senecjusz/Dynia-eyes/50-elektronika/README.md

# 50 – Elektronika

- [sprzet.md](sprzet.md) – posiadane i brakujące części,
- [polaczenia.md](polaczenia.md) – jak co jest podłączone (piny, zasilanie) i opis wszystkich szkiców,
- szkice testowe: `blink/`, `skan-i2c/`, `test-serwa/` (19.10),
- `kalibracja/` – kalibracja modułów po kolei z portu: `k <n>` wybiera kanał i trzyma 1500 µs do nasadzenia orczyka, `s`/`min`/`max` zapisują środek i krańce, `t` drukuje tabelę do `kalibracja-oczu.md`,
- `oczy-ruch/` – program ruchu oczu (sakady, fiksacje, tryby spoczynek/aktywny),
- `test-powerbank/` – test auto-wyłączania powerbanku (E5.5),
- `test-galka/` – łagodny ruch gałki dużego oka bez kalibracji (koło albo losowo, amplituda i kanały z portu: `start`, `a`, `ax`, `ay`, `x`, `y`, `losowo`, `stop`, `off`),
- `test-24h/` – test 24 h mechaniki na dwóch modułach, dziennik i środki oczu w NVS (E5.6),
- schematy i zdjęcia płytek.
