senecjusz/Dynia-eyes/10-inspiracje/README.md

# 10 – Inspiracje

Projekty i materiały znalezione w internecie, na których bazujemy.

Jeden plik `.md` na inspirację, np. `ping-pong-eyes-instructables.md`:
- link do źródła,
- co z tego bierzemy (mechanizm, kod, pomysł),
- na który poziom projektu się przydaje (1 / 2 / 3).

Pobrane pliki (STL, kod, PDF) w podfolderze o tej samej nazwie.

Pliki:
- `mechanizmy-oka-zrodla.md` – źródła researchu mechanizmów oka,
- `pumpkin-eyes-kent-harris.md`, `arduino-servo-pumpkin-eyes-68percentwater.md` – projekty dyni z oczami na serwach,
- `servo-pumpkin-pythoncader.md` (kod w `servo-pumpkin-pythoncader/`) – analiza kodu ServoPumpkin (21.10), wzór dla `50-elektronika/oczy-ruch`.
