senecjusz/Dynia-eyes/60-firmware/README.md

# 60 – Firmware

Kod dla Arduino Nano (ATmega328) sterujący serwami przez PCA9685.

Jeden podfolder na program, np. `test-serwa/`, `oczy-losowo/`, `duze-oko/`.
