senecjusz/Dynia-eyes/40-cad/archiwum/v1/README.md

# Oko F v1 – PRZESTARZAŁE, NIE DRUKOWAĆ

Pierwsza wersja modułu małego oka (wariant F), zastąpiona przez **v1.1** (`40-cad/stl/*-v1.1.stl`).

Powody wycofania (review v1, 2026-10-18):
- **napęd w martwym punkcie**: korba, cięgno i orczyk leżały na jednej prostej przy oku na wprost,
- luzy liczone od piłeczki 40,0 mm (realnie 39,5–40,5),
- STL eksportowane z grubą siatką (otwory jako wielokąty co 22,5°): luz bagnetu spadał z 0,6 do ~0,14 mm, a gwint gniazdo–nakrętka miał wcisk,
- rant Ø72 × 2 mm za duży.

Stan modelu v1 jest zapisany w Onshape jako wersja dokumentu **„v1”** (dokument SimpleEye).

| Plik | Co to |
|---|---|
| `*-v1.stl` | eksporty v1 (nie drukować) |
| `oko-f-v1-build.js` | skrypt, który zbudował drzewo v1 przez REST API |
