senecjusz/Dynia-eyes/30-projekt/decyzje.md

# Dziennik decyzji

| Data | Decyzja | Dlaczego |
|---|---|---|
| 2026-10-17 | Sterowanie: Arduino Nano + PCA9685, serwa SG90 | Sprzęt już kupiony; PCA9685 obsłuży do 16 serw |
| 2026-10-17 | Dostęp agentów do GitHuba tylko przez deploy key tego repo | Ochrona pozostałych repozytoriów |
| 2026-10-17 | Dynia prawdziwa | Projekt na 1–2 tygodnie, wilgoć akceptowalna |
| 2026-10-17 | Małe oczy bez powiek – 1 serwo na oko | Najprostszy mechanizm, pewny do zrobienia z synem |
| 2026-10-17 | Punkt wyjścia: moduł-rurka (68percentwater), mocowanie gwintem | Mały otwór w dyni, montaż bez narzędzi przez syna |
| 2026-10-17 | Poziomy = złożoność, nie mechanizm; duże oko w podpoziomach 2a/2b/2c | Każdy krok daje działające oko; mechanizm dobieramy w analizach |
| 2026-10-17 | Moduł oka wpinany bagnetem w gniazdo osadzone w dyni; mocowanie gniazda do ustalenia | Montaż modułu bez narzędzi, wymuszona pionowa oś oka |
| 2026-10-17 | Mocowanie małego oka: gniazdo z rantem + nakrętka (rodzic), moduł na bagnet (syn); wymiary rantu i napędu zaktualizowane w v1.1 (patrz niżej) | Najbezpieczniejsze; dziecko robi tylko prostą, nie do pomylenia czynność |
| 2026-10-17 | Drukowany klucz nasadowy do nakrętki gniazda, pod grzechotkę 3/8" | Syn może sam dokręcić gniazdo; jeden klucz do wszystkich oczu |
| 2026-10-17 | Model oka F v1 w Onshape (SimpleEye) ze zwykłych operacji + zmienne `#…`, wszystkie części w jednym Part Studio w pozycji złożonej | Użytkownik może sam edytować drzewo; jedno miejsce do sprawdzania kolizji i luzów |
| 2026-10-17 | Gwint gniazda/nakrętki: trapezowy, prawy, skok 3 mm, luz 0,3 mm, od 14 do 45 mm pod powierzchnią | Docisk ścianki 15–35 mm; prawy = dokręcanie „normalnie” patrząc od środka dyni |
| 2026-10-17 | Bagnet: 3 zaczepy w gnieździe na 0°/150°/210° (nierówno = jedna pozycja), obrót 30°, garb zatrzasku 0,6 mm | Moduł wchodzi tylko pionowo; klik potwierdza zamknięcie |
| 2026-10-17 | Napęd oka: SG90 leżący w tulei za jarzmem (wałek pionowo), cięgno korba 20 mm ↔ orczyk 14 mm, piłeczka na 2 czopach + kolec z tyłu | Wszystko mieści się w tulei Ø53,3; ruch oka ±30–40° bez kolizji |
| 2026-10-17 | Środek piłeczki 5 mm pod powierzchnią dyni; piłeczka wystaje ~13 mm ponad rant | Czopy muszą zmieścić się w tulei przed rantem; do oceny na wydruku |
| 2026-10-17 | Pudełko z elektroniką i powerbankiem w środku dyni (pionowa wieża); powerbank na podstawce = opcja | Minimum bez dodatkowych konstrukcji; wyprowadzenie na zewnątrz tylko gdy starczy czasu |
| 2026-10-17 | Plan: minimum (4–8 małych oczu) do 25.10, rozszerzenia niezależne; duże oko raczej na przyszły rok | 2 weekendy do Halloween; nic opcjonalnego nie może blokować minimum |
| 2026-10-17 | Połączenia i osie na śruby M3/M4; piłeczka na śrubach-osiach przez bieguny (P1) | Śruby są w warsztacie; pewniejsze niż drukowane czopy i klej |
| 2026-10-18 | Kontroler: Arduino Nano; zapas: ESP32 / Raspberry Pi (gdyby zabrakło pamięci), w warsztacie też Uno i Mega | Tani, 5 V jak PCA9685 i PIR, mały pobór; syn nie programuje sam, więc micro:bit niepotrzebny |
| 2026-10-18 | Dynia będzie prezentowana w szkole: filtrowanie radaru, limit serw w ruchu, zapasowe moduły | Tłum dzieci = ciągły ruch i dotykanie |
| 2026-10-18 | Małe oczy zawsze chaotyczne, bez czujnika; na ruch reaguje tylko duże oko (zamknięte gdy nikogo nie ma, otwiera się po wykryciu PIR-em) | Najprostsze; minimum nie potrzebuje żadnego czujnika |
| 2026-10-18 | Śledzenie przez duże oko: radar LD2450 + ESP32 (otwarcie i kierunek z jednego czujnika; góra–dół z odległości) | Duże oko ma 2 osie, radar podaje kąt wprost; Nano nie obsłuży portu szeregowego radaru |
| 2026-10-18 | Duże oko próbujemy zrobić w tym roku, równolegle z małymi oczami (małe oczy = minimum) | Projekt w CAD jest szybki; użytkownik ocenia mechanizm jako prosty |
| 2026-10-18 | Firmware od początku na ESP32, z kalibracją serw przez stronę w telefonie (Wi-Fi, zapis w pamięci) | Kalibracja to największe ryzyko; radar LD2450 później bez migracji |
| 2026-10-18 | Zamówić radar HLK-LD2450 | Dostawa kilka dni; śledzenie przez duże oko to wtedy jeden wieczór |
| 2026-10-18 | Drukarki: X1C w Warszawie (wydruki próbne w tygodniu), A1 mini w Kobyłce (weekendy, małe części) | Logistyka między dwoma miejscami |
| 2026-10-18 | v1.1 małego oka: napęd korba 22 \/ cięgno 16 \/ drukowane ramię orczyka 22 mm, ±30° (start ±25°), piłeczka 39,5–40,5, rant Ø68×1,5; drukowana testowo bez poprawek z review | Usuwa martwy punkt z v1 (przy orczyku 13–14 mm blokada ~20°); poprawki review → v2 |
| 2026-10-18 | Zasada DFAM: każda część z płaską stroną na stół, nic nie wystaje poza nią | Jarzmo v1/v1.1 nie leżało płasko |
| 2026-10-18 | v2 modułu oka ze śrubami zlecona nowej sesji (brief 30-projekt/brief-v2-modul-oka.md) | Po review v1.1 |
| 2026-10-18 | v2 modułu oka w gałęzi „v2” dokumentu SimpleEye (wersje „v1.1” i „v2 do review”): Part Studio „Oko F v2”, Variable Studio „Zmienne v2”, Assembly „Oko F v2 - zlozenie” | v1 i v1.1 zostają nietknięte; jedno miejsce na historię |
| 2026-10-18 | Oś oka: 2 × M3×8 z niskim łbem (ISO 7380 / DIN 7984) wkręcone ciasno w występy tulei, łby w pogłębieniu; jarzmo i piłeczka luźno; luz osiowy 0,3 mm | Łeb DIN 912 nie mieści się w ściance tulei bez wystawania pod gniazdo |
| 2026-10-18 | Przeguby napędu: M3×8 od dołu, tulejka z kołnierzem (korba/ramię luźno 0,2 mm), wkładki M3 w cięgnie, śruba dokręcona do oporu | Pewny luz i brak odkręcania przy ruchu wahadłowym |
| 2026-10-18 | Napęd v2: korba 26 mm @16°, cięgno 15,15, ramię orczyka 25,5; wałek serwa 51 mm za osią oka; kąt przenoszenia ≥ 41° przy ±30° (także z luzami) | Przy łbach M3 i tulejkach wymiary v1.1 nie mieszczą się w tulei Ø48,5 |
| 2026-10-18 | Jarzmo: pierścień odchylony o 60° w bok, kołek Ø4 + siodło; ograniczniki ±33° (kołki na oczkach w łukowych rowkach występów tulei) | Miejsce na cięgno za piłeczką; wymuszony obrót ręką idzie na tuleję, nie na serwo; druga pozycja czworoboku niemożliwa |
| 2026-10-18 | SG90 wzdłuż osi, wałkiem do tyłu, wysunięty 7 mm pod tuleję za gniazdem; wsuwany od tyłu, przednie ucho na słupku tulei, tylne na pokrywie tylnej (odciążenie kabla kołkami) | Warstwa napędu na wysokości środka piłeczki daje najwięcej miejsca; moduł krótszy (72,6 mm) |
| 2026-10-18 | Gałka wystaje ~8 mm; gniazdo na ściankę 15–30 mm; rant i nakrętka (Ø72, bez skrzydełek) dopasowane do dyni R 150; gwint 45° z fazą początku; bagnet z językami (garb 0,6 mm) i znacznikami WSUŃ/ZAMKNIĘTE | Brief v2 (pkt 4, 5, 7, 8, 9) |
| 2026-10-18 | v2 bez bagnetu: gniazdo + tuleja = jedna Obudowa (montuje rodzic, syn wpina wtyczkę); piłeczka wklejona (CA) w drukowaną tylną Miskę zamiast jarzma C i wiercenia | Mniej części i mniejsza średnica (otwór ~Ø57 zamiast 64); moment rozłożony na tylną połowę piłeczki |
| 2026-10-18 | v2.1 w gałęzi „v2” (wersja „v2.1 do review”): Part Studio „Oko F v2.1”, Assembly „Oko F v2.1 - zlozenie”; „v2 do review” zostaje w historii | Poprawki po review v2 |
| 2026-10-18 | Obudowa jednoczęściowa: otwór w dyni Ø57, rant Ø63 z ząbkami, gwint 45° skok 3 na rurze Ø52,5, nakrętka Ø66 od środka; ścianka dyni 15–25 mm | Mniejsza średnica bez bagnetu; przegub H musi leżeć za gwintem, żeby go skręcić przy założonej nakrętce |
| 2026-10-18 | Miska = pas kulisty 8 mm (wnętrze Ø40,9, klej 0,2) z tyłu piłeczki w płaszczyźnie odchylonej o 60°, korba zrośnięta; przyrząd do wklejania ustawia źrenicę | Pełna półkula łamie DFAM (oczka poza płaską stroną) i zajmuje miejsce cięgna |
| 2026-10-18 | Wnętrze zostaje Ø48,5; napęd v2.1: korba 25,25 @17°, cięgno 17,21, ramię 27 @200°, wałek serwa 54 mm za osią oka; kąt przenoszenia ≥ 44° przy ±30° | W mniejszej rurze czworobok z łbami M3 i tulejkami nie mieści się (≤ ~30° kąta przenoszenia albo kolizje) |
| 2026-10-18 | Oś oka: 2 × M3×5 ISO 7380 (koniec 0,35 mm przed piłeczką); wybranie 0,6 mm w ściance na przegub H | Dłuższa śruba weszłaby w piłeczkę; przy −33° ramię i cięgno dotykały ścianki |
| 2026-10-18 | v2.1b: szczelina na klej 0,5 mm (klej wypełniający, akrylowy 2K); czasza przyrządu = piłeczka + 0,4 niezależnie od kleju; wersja „v2.1b do review” | Decyzja użytkownika; 0,2 mm za mało dla piłeczek 39,5–40,5 |
| 2026-10-18 | Assembly: wałek serwa z limitem −37…+30°, przegub C Revolute, H Ball | Bez limitu solver wpadał w drugą gałąź czworoboku (ramię 68°); Cylindrical w C pozwalał cięgnu się przechylać |
| 2026-10-18 | Luz gwintu drukowanego 0,5 mm (zamiast 0,3) i próbka gwintu przed drukiem obudowy | Nakrętka v1.1 po wydruku była za ciasna |
| 2026-10-18 | Cienkie elementy wymagające podpór niedopuszczalne; jarzmo/miska ze ściankami ≥ 2–2,4 mm i płaską stroną na stół | Jarzmo v1.1 pękało przy zdejmowaniu podpór |
| 2026-10-18 | v2.1c (wersja „v2.1c do review”): jarzmo drukowane płaskim bokiem miski bez podpór; korba zrośnięta z miską na całej szerokości pasa; piasta C Ø10 jako kropla 45° (spłaszczona po stronie ściany); oczka 2,4 mm; pogłębienie łba osi 1,9 | Wydruk v1.1: jarzmo bez płaskiej strony pękało przy odrywaniu podpór; ścianka wokół tulejki była 1,2 mm |
| 2026-10-18 | `luzGwint` 0,5 i osobne części „Probka gwintu” (pierścień 14 mm + kawałek nakrętki) drukowane przed obudową | Nakrętka v1.1 z luzem 0,3 była po wydruku za ciasna |
| 2026-10-18 | Kabel SG90: taśma prosto do tyłu z dołu krótszego boku od strony wałka; pokrywa z otworem w kształcie dziurki od klucza (9 × 3,4 na wtyczkę 3-pin, szczelina 1,2 zaciska taśmę) i prowadnicami zamiast kołków | Kabel wychodzi przy wałku; wtyczka musi przejść przy założonej pokrywie |
| 2026-10-18 | Otwór małego oka pod stałą otwornicę Ø56 mm (część w otworze Ø~55,6) | Otwornica 57 niedostępna; stała daje równiejszy otwór niż nastawna |
| 2026-10-18 | v2.1d: otwór w dyni pod stałą otwornicę Ø56; część obudowy w otworze Ø55,6 (luz 0,2/str.), gwint Ø54,9 (0,55/str.), rant Ø63 bez zmian; serwo i pokrywa montowane od środka dyni po założeniu obudowy | Otwornicy Ø57 nie ma; serwo i występ pokrywy wystają poza Ø56 |
| 2026-10-18 | v2.2: gniazdo w dyni + kaseta (kompletny moduł skręcony na stole) wsuwana osiowo, z żebrem (pozycja GÓRA) i 2 sprężystymi zaczepami; otwór Ø62 (zastąpione: Ø63,5, nastawna otwornica) | W dyni nic się nie skręca (v2.1d nie dało się złożyć); syn wkłada moduł sam |
| 2026-10-18 | Zakres pracy oka ±30°, ograniczniki ±33° jako stop | Przy ±33° napęd na granicy (review v2.1d) |
| 2026-10-18 | Gwint: luz 0,3 przy flankach 45° i głębszy zarys (~1,6–1,8 mm) | Próbka v2.1 (luz 0,5) za luźna: ~1,3 mm luzu |
| 2026-10-18 | CAD zostaje w Onshape. Fusion 360 odpada (tylko Windows). SolidCraft (open source, klon Fusion z MCP, Win+Linux) – wrócić, gdy projekt się ustabilizuje | Praca na dwóch komputerach (Windows + Linux); SolidCraft v0.14 jest jeszcze za młody |
| 2026-10-18 | v2.2: otwór w dyni Ø63,5 (otwornica 2½", „64”); kaseta Ø54,5 ze ścianką 3; gniazdo Ø54,9 / rdzeń 58,9; gwint 45° skok 5, zarys 2,0, Ø62,9; nakrętka Ø74 × 7 (otwór 59,5, zazębienie 1,7); rant Ø74 | Przy Ø62 ścianka kasety 2 mm nie mieści łba śruby osi z gwintem; przy flankach 45° i skoku 3 zazębienie ≤ 1,5 |
| 2026-10-18 | Kaseta wsuwana od środka dyni; rowek kasety na żebrze gniazda (135°), 2 zaczepy obwodowe drukowane w XY, haczyki w okienkach gniazda (59°/239°); oś oka: ISO 7380 M3 skrócone do 4 mm, łby zakrywa otwór gniazda | Złożony moduł z serwem nie przejdzie przez otwór od zewnątrz; zaczepy dostępne z wnętrza dyni |
| 2026-10-18 | Kaseta składana na stole w kolejności: jarzmo od tyłu → sanki serwa od tyłu → ramię przez tył → cięgno od tyłu → przeguby C i H od spodu (dwa otwory dolne) → pokrywa; sprawdzone symulacją wsuwania | W v2.1d słupek ucha i występy pokrywy blokowały drogę jarzma; cięgno założone wcześniej blokuje ramię |
| 2026-10-18 | Ogranicznik: kołek Ø2,6 × 1,6 na oczku jarzma, 6,7 mm za osią, w szczelinie na wylot w kasecie (stop ±33°); piasty C i H Ø10 (ścianka 2) z wybraniami w ściance kasety ≥ 2 mm | Review v2.1d: ogranicznik za słaby, piasty 1,15–1,2 mm |
| 2026-10-18 | Rozstaw oczu w dyni R 150: poziomo ≥ 115 mm, pionowo ≥ 145 mm (tył kasety okrągły, bez spłaszczeń) | Spłaszczenia dawały nożowe krawędzie (review) |
| 2026-10-18 | v2.2 ma osobne Variable Studio „Zmienne v2.2” (Part Studio v2.2 odwołuje się tylko do niego) | Zmiany v2.2 nie psują Part Studio v2.1 w tej samej gałęzi |
| 2026-10-18 | Otwór małego oka Ø63,5 (nastawna otwornica do 64) | Zaakceptowane przez użytkownika po planie v2.2 |
| 2026-10-18 | v2.3 = wąskie poprawki review v2.2: luz sanek 0,25, fazki wejściowe, zaczepy obrócone (kolizja z otworem H), pasek za okienkami ≥ 3,5, ucha pod wkładki; napęd bez zmian | Najważniejsze: wkładanie i pewne zablokowanie kasety; reszta po wydruku |
| 2026-10-18 | Rozstaw oczu w dyni: poziomo ≥ 125 mm, pionowo ≥ 145 mm | Review v2.2: przy 115 nachodzą ucha pokryw |
| 2026-10-18 | Pilotaż CAD w SolidCraft 0.15 (model `40-cad/solidcraft/oko-f-v2.3.solidcraft`), praca na żywo w aplikacji | Onshape zablokował API; SolidCraft działa na Windows i Linux |
| 2026-10-18 | Gwint gniazda i nakrętki: natywny ISO **M63×3** (flanki 60°) zamiast 45° skok 5; nakrętka M63.6×3 (luz 0,3 promieniowo), do porównania próbka M64.2×3 (0,6); najpierw próbka gwintu | Własny zwój 45° zawiesza SolidCraft 0.15 (#2079, #1856); natywny Thread liczy się w ~10 s |
| 2026-10-18 | Pilotaż SolidCraft 0.15 (CLI) dla v2.3, Onshape w zapasie | Onshape zablokował API (429, Retry-After ~7 h) |
| 2026-10-18 | Gwint gniazda i nakrętki w SolidCraft: ISO M63×3 (60°) zamiast 45°; nowa próbka przed drukiem | Własna helisa zawiesza SolidCraft (znane błędy), natywny gwint ISO działa |
| 2026-10-18 | SolidCraft głównym narzędziem CAD, dopóki daje oczekiwane wyniki; Onshape w zapasie | Pilotaż etapu 1 (gniazdo, kaseta, gwint ISO) zaakceptowany przez użytkownika |
| 2026-10-18 | SolidCraft głównym narzędziem CAD (Onshape zapasowo); v2.3 kompletna w `40-cad/solidcraft/oko-f-v2.3.solidcraft` | Decyzja użytkownika po etapie 1 |
| 2026-10-18 | v2.3: wybranie H poszerzone (−24,95 / −25,2 / −25,6), ścianka ≥ 2,05 | Symulacja: ramię–kaseta 0,32 i cięgno–kaseta 0,41 przy ±33° po zmianach v2.3; teraz 0,61 / 0,51 |
| 2026-10-18 | v2.4 = poprawki review v2.3 (otwory dolne ≥ 7,5, błona przyrządu, mostek i ścianki przy H, fazki wejściowe, faza zwoju i nakrętki, trzpień 0,3, parametry, widelec do zaczepów, szczelność siatek) | Review v2.3: błędy migracji do SolidCraft i drobne usterki |
| 2026-10-18 | Komputer w Warszawie: deploy key repo trzymany w `.ssh/` katalogu projektu (`~/Projects/010-Eye-pumpkin/.ssh/`, poza drzewem repo), git sięga po niego przez `core.sshCommand`; w `~/.ssh/config` nie ma żadnego wpisu | Życzenie użytkownika: klucz przy projekcie, nie w katalogu domowym. Poza drzewem repo nie da się go przypadkiem scommitować. Klucz bez hasła, więc chronią go tylko uprawnienia 600/700 |
| 2026-10-18 | v2.4: zaczepy 33°/213°, haczyki i okienka 47°/227° (−5° od v2.3); wybranie H współosiowe (r 25,25 / 25,8), pogrubienie H od z −46,5 | Usunięcie mostka przy otworze H i ścianka ≥ 2 wszędzie (review v2.3) |
| 2026-10-18 | v2.4: nakrętka bez radełka i faz otworu, obrócona o 24° (faza gwintu); gwint zawsze ostatnią operacją | Ograniczenie SolidCraft 0.15: radełko + czoło stożkowe psują gwint wewnętrzny |
| 2026-10-18 | Eksport 3MF zawsze przez `40-cad/narzedzia/napraw_siatki.js` + `sprawdz_siatki.js` (0 błędów) | Review v2.3: nieszczelne siatki z SolidCraft |
| 2026-10-18 | v2.4: luz ramię–kaseta 0,26 mm przy stopie +33° akceptowany; w razie potrzeby zakres pracy w firmware ±25° | Dotyczy tylko stopu; różnica ±25/±30° dla efektu nieistotna (użytkownik) |
| 2026-10-19 | Onshape (SimpleEye) wraca jako główne CAD; v2.5 małego oka powstaje w nim przez przebudowę według tabeli „Do v2.5” i `AGENTS.md`; SolidCraft zostaje archiwum v2.3/v2.4 | SolidCraft 0.15 przelicza całe drzewo przy każdej zmianie (~350 s przy 200 operacjach); blokada Onshape 18.10 była limitem okna (429), nie puli rocznej |
| 2026-10-19 | v2.5 w Onshape: najpierw 10 części modułu (gniazdo, nakrętka, kaseta, jarzmo z miską, sanki, ramię, cięgno, 2 tulejki, pokrywa), przyrządy i widelec później | Moduł jest potrzebny do wydruku testowego |
| 2026-10-19 | v2.5: gwint 45°, skok 5, rdzeń Ø58,9, gwint Ø62,9, `luzGwint` jako zmienna (start 0,3, wartość po próbce E2.0); nakrętka z powrotem z radełkiem | Profil 45° wydrukował się dobrze w v2.2, ISO 60° w PETG kiepsko; radełko usunięto tylko przez ograniczenie SolidCrafta |
| 2026-10-19 | v2.5: szczelina SG90 na 12,2 + `luzSanki` (rozrzut serw), mniejsze serwo dociska wkręt ucha | Projekt na rozrzut wymiarów zamiast pomiaru jednego egzemplarza |
| 2026-10-19 | v2.5 w nowym dokumencie Onshape „Oko F v2.5”, w folderze obok SimpleEye; SimpleEye zostaje archiwum | Stary dokument (271 operacji, atomowy) jest nieutrzymywalny |
| 2026-10-19 | `luzGwint` = 0,20 (gwint 45°, skok 5) dla gniazda i nakrętki v2.5 | Próbka E2.0: 0,20 → luz poprzeczny ok. 0,5 mm, pasuje; 0,25 → ok. 1,15 mm, za luźno |
| 2026-10-19 | Kontroler: ESP32-C3 SuperMini; NodeMCU ESP8266 i Arduino Nano jako zapas | Zgodne z decyzją „firmware na ESP32”: Wi-Fi do kalibracji, drugi UART na radar LD2450, mały rozmiar |
| 2026-10-20 | `wkladkaD` 4,0 → 4,4 (gniazda wkładek M3 w Kasecie i Cięgnie) | Wkładki M3×4×5 (długość 4, Ø5, podwójne radełko, z zestawu 360 szt.) w Ø4,0 wypychają plastik i rozdymają piasty Cięgna. Punkt odniesienia: karta Ruthex RX-M3x5x4 o tych samych wymiarach (otwór Ø4,4, głębokość ≥ 5, ścianka ≥ 1,3; Cięgno 1,6, Kaseta 1,8). (Uzupełnienie 20.10: nasze wkładki mają stopień prowadzący Ø4,0 – patrz wiersz niżej.) |
| 2026-10-20 | Gniazdo v2.6: `rantD` 74 → 67,5 (najwyżej 2 mm poza otworem Ø63,5); ząbki przy ściance przodu (r 31,5 → ok. 33) | Decyzja użytkownika po montażu v2.5: rant nie musi tyle wystawać, ma tylko nie wpaść do środka |
| 2026-10-20 | Gniazdo v2.6: osiowe bruzdy 6,8 × 1,05 pod łby śrub osi oka | Łby M3×10 użytkownika wystają 0,75 mm ponad Kasetę (pomiar 20.10), a Kaseta wsuwa się osiowo, nie obraca; Gniazdo ma przyjmować także łby wyższe niż ISO 7380 |
| 2026-10-20 | `wkladkaD` 4,4 wybrane do druku v2.6a: stopień prowadzący wkładki Ø4,0 (pomiar użytkownika), radełko Ø5 | Stopień wchodzi w otwór na zimno (0,2/str.), radełko ma 0,3/str. wcisku jak w karcie Ruthex dla Ø5; skuteczność potwierdzi dopiero wtopienie w nowe Cięgno |
| 2026-10-20 | v2.6: Sanki usunięte; serwo trzyma blok przedni wydrukowany z Kasetą (wkręt M2 wstępnie w uchu, dokręcany przez otwór montażowy połączony z otworem górnym) i Klamra H z tyłu (ramię zewnętrzne ≤ 3,5 nad kablem); kierunek serwa bez zmian (wałek i kabel z tyłu) | Sanek nic nie trzymało od ściany do środka, wpadały do Kasety (montaż 20.10); gniazdo blokujące ucho odrzucone, bo jego luz zależy od producenta serwa |
| 2026-10-20 | v2.6: Jarzmo i napęd wsuwane od przodu Kasety; napęd skręcany na stole; ucha Pokrywy wewnątrz Kasety po bokach, Pokrywa bez okna, zacisku, prowadnic i języka | Użytkownik włożył Jarzmo od przodu bez kanałów kołków; łączenie przegubów w rurze niewykonalne; nic poza Klamrą H nie ma wystawać poza obrys |
| 2026-10-20 | v2.7: przeguby C i H na śrubie M3×12, 1 podkładce M3 i nakrętce samohamującej; Cięgno bez piast i wkładek; Kaseta bez zmian (wariant B) | Bez lutownicy i bez deformacji piast; przy H góra nakrętki 6,7, luz do ścianki 0,79 przy ±30° oka i 0,27 przy ograniczniku ±33°; poszerzenie wybrania H w Kasecie (wariant A) odłożone |
| 2026-10-21 | Dźwigienkę nasadza się na wałek przy serwie na 1500 µs, mechanizm w położeniu „otwarte V, przegub H po prawej” (patrząc od tyłu); program ruchu w zakresie ±25° serwa wokół środka | Kalibracja pierwszego modułu: przy innym nasadzeniu środek uciekał, a czworobok w drugim położeniu blokował ruch |
| 2026-10-21 | v2.8: uszy SG90 przykręcane śrubami M3 (nie M2): blok przedni Kasety i Klamra H z otworem ciasnym Ø2,6 na całą długość, bez kanału na wkręt wstępny; śruba M3×10 | Montaż v2.7: M2 w otworze Ø2 z kanałem trzymała słabo; M3 przechodzi przez ucho SG90 bez rozwiercania i jest standardem projektu; wkręt wkładany pęsetą przez okno po wsunięciu serwa |
| 2026-10-21 | v2.8: Pokrywa przykręcana M3×8 wprost w plastik – ucha Pokrywy w Kasecie z otworem ciasnym Ø2,6 (głębokość pod M3×8 przez Pokrywę 3 mm + dno ≥ 0,6), bez wkładek | Ustalone przez użytkownika 20.10 (pomysł „śruba w plastik zamiast wtapiania”); Pokrywę zdejmuje się rzadko, wkładki tylko do częstego rozkręcania |
| 2026-10-21 | Piłeczka docelowo na 2 × M3×10 przez nawiercone bieguny (oś oka) + cyjanoakryl z primerem w Misce | Sprawdzone w montażu v2.5/v2.7: trzyma; klej modelarski nie trzymał |
| 2026-10-21 | v2.8 bez czekania na test Gniazda w dyni | Decyzja użytkownika: projekt ma iść naprzód; zmiany Gniazda z v2.6 przyjęte bez próby w dyni |
| 2026-10-20 | Zasilanie: powerbank (Baseus 20 000 mAh, zapas Manta) przez gniazdo USB-C na obudowie (breakout z 5,1 kΩ na CC) do V+ PCA9685 i 5V ESP, masa wspólna; bez akumulatora 12 V i bez zakupu pakietów NiMH; zapasu szukamy dopiero, gdy powerbank nie przejdzie testu podtrzymania | Wystawa trwa kilka dni, więc źródło trzeba łatwo wymienić; Baseus ma ok. 74 Wh (szacunek 30–40 h przy 0,3–0,4 A), NiMH 2400–5000 mAh daje ok. 1 dzień; 12 V odrzucony przez użytkownika ze względów bezpieczeństwa (dziecko 8 lat) |
| 2026-10-20 | Korekta wiersza „Gniazdo v2.6: osiowe bruzdy 6,8 × 1,05”: v2.6 po dwóch review (projekt i siatki), zgoda użytkownika: bruzdy Gniazda 8,3 × 1,05 z dnem walcowym R28,55 (z −8,6…−45,7, ścianka 0,90), `uchoDno` 1,6 (M3×8 nie dobija do dna), luz korpusu SG90 0,7 z przodu i z tyłu; kanał wkrętu 2,8 × 1,5 (usunięty w v2.8) | Review Fable/Astra 20.10: przy przesunięciu i skręcie Kasety łeb ocierał o bok bruzdy 7,3; wkręt M2×6 nie sięgał pełnego otworu; klony SG90 dłuższe niż model. Użytkownik chciał jeden kompletny zestaw do druku |
| 2026-10-20 | Otwory dolne Kasety (dostęp do przegubów C i H od spodu) zostają, choć napęd skręca się na stole | Mogą się przydać (użytkownik); Fable: przez otwór H da się dokręcić śrubę po nasadzeniu Ramienia |
| 2026-10-21 | v2.8: luz korpusu SG90 (`luzKorpusSerwa`) 0,7 → 0,4 z przodu i z tyłu | Ścianka przy otworze Ø2,6 pod M3×10 w uchu miałaby 0,65; przy 0,4 ma 0,95 (wariant b wykonawcy, zatwierdzony przez orkiestratora; `40-cad/onshape/weryfikacja-v2.8.md`) |
| 2026-10-22 | Duże oko w nowym dokumencie Onshape „Duże oko v1” (folder Halloween), z własnym Part Studio i Variable Studio; „Oko F v2.5” bez zmian | Decyzja użytkownika: osobny model, nie mieszać z modułem małego oka |
| 2026-10-22 | Duże oko: model od razu z geometrią 2c (obie powieki na wspólnej osi, kardan 2 osie, Płyta na 3 × MG90S, miejsce na Cięgno powieki dolnej); pierwszy wydruk 2b (dolna powieka na Ustalaczu), 2a awaryjnie (oś góra–dół zablokowana) | Użytkownik: przewidzieć całą geometrię od razu; przejście 2b → 2c to jedna nowa część bez zmian Rury i Płyty (`20-analizy/2026-10-18-duze-oko-jedna-noc.md`) |
| 2026-10-22 | Gałka Ø 60 (`#kulaD`), otwór w dyni 83, rant 96, bez próby z kartonem | Użytkownik: otwór zawsze można powiększyć (większy niż ok. 90 wymaga nowej Rury, bo rant 96 musi go przykryć) |
| 2026-10-22 | Środek gałki: metalowy przegub kardana 5/5 z warsztatu (Ø 11 × 24 mm, otwory Ø 5, wkręty dociskowe M4, zgięcie > 90° wg użytkownika), trzpienie M5 w Słupku i Uchwycie gałki; bez drukowanego Krzyżaka | Przegub jest w warsztacie; M5 zgodne z zasadą śrub; 2/2 (Ø 9 × 23,5, otwory Ø 2) za słaby na gałkę z powiekami i wymagałby pręta Ø 2 |
| 2026-10-22 | Gałka biała, front gładki (bez rowków, wkładek i szwów), bez tęczówki w modelu; tęczówkę i źrenicę rysuje syn | Praca z dzieckiem; AMS w X1C jest, ale nieużywany do tęczówki |
| 2026-10-22 | Rozmieszczenie: duże oko na środku frontu, po 3–4 małe oczy z każdej strony | Decyzja użytkownika |
| 2026-10-22 | **Korekta 3 wierszy wyżej (2c w modelu / 2b w druku; Ø60 z otworem 83 i rantem 96; Rura z gwintem i Nakrętką z analizy 18.10):** otwór w dyni ≤ Ø80 (część w otworze ≤ Ø79,5), rant ≤ 2 mm poza otwór, mocowanie lekkie bez Rury z gwintem, Nakrętki i kasety; od razu 2c, także w pierwszym wydruku | Użytkownik w rozmowie z orkiestratorem 22.10: „jesteśmy ograniczeni otwornicą 80”, „nie robiłbym tym razem tak ciężkiego mechanizmu jak zewnętrzne mocowanie i wkładanie kasety; to musi być lżejsze (cieńsze)”, „od razu 2c”. Otwór 83 był możliwością („zawsze można powiększyć”), nie wymaganiem. Wiersze wyżej wpisał wykonawca z rozmowy z użytkownikiem; rozstrzygnięcie techniczne orkiestratora z upoważnienia użytkownika |
| 2026-10-22 | Duże oko: **4 × MG90S** – lewo–prawo, góra–dół i osobne serwo na każdą powiekę (bez zapasowego MG90S); zastępuje 3 serwa i sprzężenie powiek jednym serwem | Użytkownik: „osobne serwo pod każdą powiekę jest bezpieczniejsze”; trzy review koncepcji v1 (Fable, Astra, Opus) wykazały kolizje jednoserwowego napędu powiek; osobne serwa powiek ma Cogley (EyeMech) |
| 2026-10-22 | Duże oko: podparcie gałki na kardanie 5/5 w środku kuli, napęd gałki prętami z przegubem kulowym na obu końcach (S–S), ogranicznik ruchu gałki w oknie Uchwytu wokół Słupka | Zwykłe śruby w cięgnach z analizy 18.10 zakleszczają się (mimośród 0,78 mm przy 15° wobec luzu 0,3 – Fable); kinematyka S–S potwierdzona niezależnym rachunkiem Fable; koncepcja `20-analizy/2026-10-22-duze-oko-2c-koncepcja-v2.md` |
| 2026-10-22 | Rozruch serw dużego oka jak w małym oku: ostatni impuls w NVS i płynny powrót; skok dopuszczalny tylko po zaniku prądu w trakcie ruchu albo ręcznym przestawieniu oka | Decyzja użytkownika; SG90/MG90S nie podają pozycji, więc bez czujnika skoku nie da się całkiem wyeliminować (Astra) |
| 2026-10-23 | Duże oko tylko z części posiadanych: przeguby kulowe RC 2 × M2 i 2 × M5, kardan 5/5, wkręty bez łba M3, druty Ø1,0 i Ø1,2 sprężynowe i Ø2,0 ocynkowany, łożyska 608-2RS i 6802-2RS; śruby i nakrętki dowolne; bez zakupów modelarskich | Użytkownik: rzeczy modelarskich nie dostanie i nie zdąży zamówić; śruby zdobędzie albo skróci |
| 2026-10-22 | Montaż w dyni wspólnie z synem: część kroków robi syn, część ojciec (narzędzia obsługuje ojciec) | Decyzja użytkownika |
| 2026-10-23 | **Korekta wiersza „Duże oko tylko z części posiadanych” (23.10):** przegubów kulowych RC nie ma – „M2 i M5 po 2 sztuki” to kardany PATIKIL 2/2 (2 szt., śruby M3) i 5/5 (2 szt., śruby M4), wychylenie > 90°; pręty napędu gałki z przegubem krzyżowym na obu końcach (drukowanym na śrubach albo z kardanów), zamiast końcówek kulowych | Użytkownik: „mam tylko to, to się wychyla powyżej 90 stopni” (linki Amazon B0FWJBJCKK, B0FWJB1HWS); wykonawca: w materiałach są tylko zdjęcia kardanów |
| 2026-10-23 | Korekta wiersza „Gałka biała, front gładki”: dopuszczone wgłębienie zera Ø3,2 × 1,0 w biegunie przednim Gałki (pod źrenicą rysowaną przez syna) do przyrządu zera – czapka z trzpieniem Ø3 na kołnierzu Ramy | Użytkownik: „jak będzie potrzeba zrobić wgłębienie, to ok”; bez cechy na kuli kierunku patrzenia nie da się ustawić przyrządem |
| 2026-10-23 | **PRD (`30-projekt/PRD.md`) nadrzędny wobec briefów i koncepcji E6**; praca z PM w rozmowie, bez orkiestratora i rund review | Użytkownik: model orkiestratora mało wydajny; orkiestrator dopisywał wymagania funkcjonalne (`wnioski-pracy-2026-10-23.md`, pkt 0) |
| 2026-10-23 | **Korekta „Duże oko: 4 × MG90S”:** powieki na jednym serwie (3 × MG90S); dolna nieruchoma albo osobne serwa tylko za zgodą użytkownika | Użytkownik: prościej w mechanice i sterowaniu |
| 2026-10-23 | Duże oko: zakres cel ±35° lewo–prawo / ±25° góra–dół, minimum ±30° / ±20° | Duże oko ma być „plastyczne”; ±25° / ±15° wpisał agent 18.10 bez decyzji użytkownika |
| 2026-10-23 | Duże oko v1 (Onshape) porzucone; nowy mechanizm wzorowany na The Face maker101 (kardan, nieruchome serwa, pręty, jedno serwo powiek), pręty drukowane, drut tylko gdy wyraźnie upraszcza | Napęd v3.2 przekombinowany; nic nie wydrukowano |
| 2026-10-23 | Duże oko w dyni: wcisk w otwór, awaryjnie mocowanie od środka; wyjmowanie bez niszczenia niewymagane; odporność na dzieci poza zakresem | Użytkownik: najprostsze możliwe, zastosowanie jednorazowe; „jak zepsują, to zepsują” |
| 2026-10-23 | Dynia w szkole od środy 28.10 przez kilka dni, zasilanie tylko z powerbanku (bez gniazdka); pudełko z elektroniką w środku dyni; czujnik PIR; bez światła i dźwięku; mechanizm pomarańczowy | Użytkownik |
| 2026-10-24 | Duże oko: moduł wkładany od środka dyni, kołnierz z łapami na wkręty do drewna 4 × 30–40, z zewnątrz maskownica Ø84; zastępuje wcisk od zewnątrz | Użytkownik w rozmowie z projektantem; koncepcja `20-analizy/2026-10-24-duze-oko-koncepcja-wstepna.md` zaakceptowana |
| 2026-10-24 | Jeśli powieki A (obie ruchome, 1 serwo) się nie mieszczą – wariant B (dolna nieruchoma) bez pytania; C (4 serwa) tylko za zgodą | Użytkownik przed nocną pracą zespołu |
| 2026-10-24 | Noc 24/25.10: projektant pracuje samodzielnie, review przez Astrę (krytyczny architekt), pomysły i wątpliwości do PM, commit na main po kamieniach milowych | Użytkownik: praca ma nie stanąć, rano bez pytań o wymiary (`30-projekt/brief-duze-oko-krok2-cad.md`) |
| 2026-10-24 | Duże oko v2: OpenSCAD tylko tymczasowo (noc 24/25.10, blokada tworzenia publicznego dokumentu Onshape w sesji agenta); po udanym projekcie model przerysowany w Onshape, dokument zakłada użytkownik | Użytkownik: OpenSCAD jest dla niego trudny, woli Onshape |
| 2026-10-24 | Elektronika i powerbank w podstawce pod dynią (sklejka 18/12 + druk), kable przez otwór w dnie dyni, dynia przymocowana do podstawki od środka, powerbank wymieniany szufladką z tyłu bez podnoszenia dyni; zastępuje pudełko w środku dyni | Użytkownik: wymiana powerbanku bez podnoszenia 10-kilogramowej dyni |
| 2026-10-24 | Szuflada podstawki (powerbank, ESP32-C3, płytki) drukowana 3D; okablowanie oczu trzema skrętkami Ethernet (grupa małych lewa, grupa małych prawa, duże oko) z keystone’ami | Użytkownik: jeden wspólny przewód na grupę, łatwe rozłączanie; keystone’y już kupione |
| 2026-10-25 | Podstawka: szufladka tylko na powerbank, otwierana do przodu, USB-C wpinany ręcznie; elektronika na stałe w podstawce; podstawka bez dna, płyta górna 18 mm, ok. 58 mm wys.; dynia na tulei przez otwór Ø80 w dnie, skrętki przez tuleję | Użytkownik w rozmowie z projektantem podstawki (z tyłu stoją inne dynie) |
| 2026-10-25 | **Korekta „powieki na jednym serwie”:** duże oko 4 × MG90S, każda powieka na własnym serwie; drut w uszku na tylnej krawędzi czaszy ok. 34 mm od osi; drukowane przedłużenie orczyka 25 mm (otwarcie 51,5°); tuba pierścienia zostaje | Użytkownik w rozmowie z projektantem po analizie uproszczenia (Opus, Astra, Fable): „dwie powieki, nawet na dwóch serwach – ruchem można dużo fajniej sterować” |
| 2026-10-25 | Duże oko: połączenie prętów S1/S2 z gałką przez kardany 2/2 z warsztatu (kostka z otworem Ø2 na kołek, pręt Ø2 do orczyka) zamiast oczka na sworzniu | Decyzja użytkownika w rozmowie z projektantem |
| 2026-10-25 | Klej dozwolony: gdy prościej wydrukować w częściach i skleić albo coś przykleić, kleimy; śruby tam, gdzie coś się obraca lub rozkręca | Użytkownik: „czasem prościej wydrukować coś w częściach i sklejać, nie mam problemu coś przykleić” |
| 2026-10-24 | Kalibracja małych oczu: wspólne wartości 1500/1100/1800 µs dla wszystkich modułów; jarzma montowane obrócone o 180° względem instrukcji (Ramię w lewo) | Użytkownik przy kalibracji z programistą |
| 2026-10-25 | **Podstawka wykonana (stan faktyczny):** dno 6 mm sklejone ze ściankami 40 mm, płyta górna 18 mm przykręcona 4 śrubami do dołu, otwór w płycie Ø60, bez listew nośnych; elektronika mocowana do dna; w dyni nie ma pudełka. Zastępuje wariant „bez dna, ok. 58 mm” | Użytkownik wykonał podstawkę z drewna |
| 2026-10-25 | Łączniki RJ45 gniazdo–gniazdo w dyni (nie keystone'y w podstawce); PIR HC-SR501 w przedniej ściance podstawki | Użytkownik: ma kabel i zaciskarkę, PIR kupiony |
| 2026-10-25 | Szufladka powerbanku zabezpieczona śrubą przed otwarciem przez dzieci | Użytkownik |
| 2026-10-26 | **Duże oko: wzorem jest adaptacja referencji The Face maker101** (synteza `20-analizy/2026-10-25-referencja-face-maker101-synteza.md`): jedna płyta serw, **jeden przegub gałki – kardan 5/5 z warsztatu w środku kuli**, pręty z drutu bez przegubów. **Wycofuje wiersz 2026-10-25 o kardanach 2/2 przy prętach S1/S2** | Użytkownik 26.10 („Ad 1 OK”); kardany 2/2 przy gałce to rozbudowa ponad referencję (PRD §9) |
| 2026-10-26 | Duże oko: zawias powiek na dwóch słupkach płyty serw, po bokach gałki (jak w referencji); oko z powiekami skręcane na stole, potem wsuwane w tubę; ok. 1 mm słupek–tuba akceptowane | Użytkownik 26.10 („OK” na wariant A) |
| 2026-10-26 | Podstawka – wymiary wykonane wg pomiarów (PRD 0.2 §5): wnętrze 216, dno 9, głębokość 226, wysokość 69; szufladka v2 (osobny front, mała rączka, blokada M4 w płytę górną, PIR po prawej stronie frontu). Zastępuje wiersz 2026-10-25 „dno 6 mm…, listwy” w części wymiarów | Pomiary i decyzje użytkownika 25.10 w sesji montażu |
| 2026-10-26 | Duże oko v3, wygląd: źrenica (czarny środek) najwyżej Ø20; gałka wystaje 24 mm przed rant tuby, zamknięte powieki 28 mm; czasza gałki od tyłu ok. 111° od przodu (zamiast ok. 120°, bo przy 120° pręt L–P zahacza o krawędź) | Użytkownik 26.10 („Q1 OK, Q2 OK, Q3 OK”) |
| 2026-10-26 | Duże oko v3: drut napędu i powiek Ø1,2 (Ø1,0 brak w warsztacie); nasady słupków zawiasu i kardana pogrubione skosami/żebrami 45° po płycie (bez nowych części), płytę użytkownik drukuje pod ok. 45° (orientacja po jego stronie); sztywność słupków liczona i sprawdzona przez Opus 5.5 i Astrę | Użytkownik 26.10 („mam tylko 1,2 mm”, „TAK / TAK … / tak”) |
| 2026-10-26 | Duże oko v3: płyta drukowana pod 45° z projektowaną podporą jako osobna siatka (jak w filmie Slant 3D, notatka `20-analizy/2026-10-26-druk-wytrzymalosc-notatki.md`), wyłączone podpory slicera | Użytkownik 26.10 („trzeba będzie zbudować oddzielną siatkę z supportami tak jak w filmie”) |
| 2026-10-26 | Duże oko v3: powrót na drut Ø1; zaczep „Z” według gięcia ręcznego użytkownika (noga 5–7 mm, R ok. 1 mm, ogon skracany do ok. 2 mm); test próbki 33° odwołany; minimalna zmiana, dopasowanie gięcia po stronie użytkownika | Użytkownik 26.10 („tak, tylko nie szalejcie. Jak trzeba będzie kombinować z gięciem, to coś wykombinuje”) |
| 2026-10-27 | Duże oko v3: na drutach powiek ogon „Z” przy uszku skracany po zgięciu do ok. 1 mm (zahaczał o powiekę i gałkę); na drutach gałki ogon 2 mm | Użytkownik 27.10 („Q2 tak”) |
| 2026-10-27 | Duże oko v3: trzpienie kardana jako drukowana część (kołnierz Ø9,3 × 5,2 w obecnych gniazdach, trzpień Ø4,95 wchodzi w kardan najwyżej 6 mm) z rdzeniem M3 × 10 ISO 7380 (12 mm z łbem); zastępuje M5 × 8, której nie ma; gałka i płyta bez przedruku | Otwór kardana zmierzony 27.10: Ø5,05–5,1, gładki, głębokość użytkowa 6 (wcześniejsze Ø5 było z karty produktu); posiadane M5 × 16 mają łby stożkowe Ø ok. 10 i nie wchodzą w gniazdo Ø9,5; użytkownik zatwierdził brief („tak”), po wydruku: „trzyma się dość mocno” |
| 2026-10-28 | Duże oko v3: oś powiek to wkręt M2 × 6 (posiadany) wkręcony w powiekę dolną, luźno w słupku i uchu powieki górnej; tuby ze szczelinami 5,0 na łby; przedruk powiek i tub, płyta i gałka bez zmian. Zastępuje drut Ø2 × 5,6 | Drutu Ø2 użytkownik nie ma; kołek na kleju odrzucił: „ma być zablokowany na ławce, nie dopiero w tubie”; review Astry `20-analizy/review/2026-10-28-duze-oko-zawias-astra.md` |
| 2026-10-28 | Duże oko v3: przedłużenie orczyka z rowkiem na ramię orczyka (szer. 4, gr. 2) i otworami na kołki Ø1 | Model zakładał piastę po płaskiej stronie orczyka; pomiar użytkownika ramienia 4 × 2 |
| 2026-10-28 | **Korekta wiersza z 27.10 (ogon 1 mm):** na drutach powiek ogon „Z” przy uszku 2 mm, zagięty w drugą stronę, ku serwu | Propozycja użytkownika; przemiatanie: do gałki 0,95 i 3,03, do powiek bez kolizji (commit 1b2aaf9 na `projektant-duze-oko`) |
| 2026-10-28 | Duże oko v3: uszka drutów na powiekach powiększone (wariant A): uszko zaczyna się 2,6 mm nad stołem, drukowane na podporze ze slicera, ścianki wokół otworu ≥ 1,12 | Użytkownik: jedno uszko wydrukowało się uszkodzone, „to uszko jest po prostu za malutkie”; wybór wariantu A w sesji projektanta |
| 2026-10-28 | Duże oko v3: kabel MG90S wychodzi po stronie wałka; serwa powiek: dwie wnęki 4 × 8 od krawędzi płyty (środki 27 i 46 mm od przodu) wycinane ręcznie, bez przedruku płyty; L–P: w razie potrzeby zeskrobać ok. 1 mm ze ścianki gniazda | Pomiar użytkownika przy montażu 28.10; model zakładał kabel po stronie przeciwnej (rysunek, pewność niska) |
| 2026-10-28 | Tacka elektroniki v2 bez przedruku: ESP32-C3 podniesiony o ok. 7 mm dwiema klejonymi podkładkami 11 × 4,9 × 7 na słupkach (`40-cad/3mf/Podstawka v2/Tacka - podkladki ESP (2 szt).3mf`, 8a07059 na `wykonawca-montaz`); wysokość do potwierdzenia jedną wtyczką Dupont | Użytkownik: „nie będziemy przedrukowywać całej podkładki… trzeba będzie podnieść ten ESP”; słupki 16 mm, wtyk Dupont z przewodem ok. 22–23 mm. Zasada 28.10: żadnych przedruków dużych części |
| 2026-10-28 | Mocowanie dyni do podstawki: otwór w dnie dyni wycinany otwornicą 60 (jak otwór w płycie podstawki Ø60–61); tuleja z gwintem ma ciasno pasować do tego otworu, bez dużego luzu | Użytkownik: „to powinno być w miarę ciasne montowanie… albo robimy 80-tką i wtedy tuleje 80, albo… 60”; wybór „60”. Model montażu (gwint Ø76 pod otwór Ø80) do przerobienia |
| 2026-10-28 | Duże oko v3: moduł podparty od dołu dwoma wspornikami L przyklejonymi na gorąco do ścianki w tylnym końcu tuby i do kołnierza; płyta klejona do ich półek; tuba z 8 łapami co 45° (łapę w miejscu kolizji można pominąć); drukuje się jedną tubę i parę wsporników tej samej długości | Użytkownik: klejone same ramiona (< 1 cm²) to za mało, płyta ma być podparta od dołu; jego propozycja 8 łap, ścianki i wspornika L; „commit, wszystko wydrukuję” (37b0045) |
| 2026-10-28 | Tuleja mocowania dyni: gwint Ø59 w otworze 60 (luz 0,5 na stronę), nakrętka z luzem gwintu 0,20 (standard z próbki E2.0), ścianka pod gwintem 3, przelot Ø49, wysokość 78, gwint na całej wysokości (bcc182c) | Użytkownik: „zróbmy to pół milimetra luzu… grubość 2,5 do 3 mm… RJ45 pojedynczo”; wcześniej: „żeby nie zrobił mega ciasno… nakrętka ma wejść… wykorzystajmy standardy” |
| 2026-10-28 | Małych oczu w dyni 7: 4 po lewej (kanały 0–3), 3 po prawej (4–6), rozmieszczone niesymetrycznie, z miejscem na duże oko na środku; czy robimy duże oko – później | Użytkownik: „zakładam, że wybieram 4 plus 3. A potem będziemy zastanawiać się, czy robimy duże oko, czy nie”; rozstaw `20-analizy/2026-10-28-rozstaw-oczu.md` |
| 2026-10-28 | Obciążenie powerbanku: rezystor 47 Ω / 3 W włączany tranzystorem IRLZ44N z ESP, impuls 1 s co 10 s | Elektronika z użytkownikiem; tranzystor zamówiony przez użytkownika |
| 2026-10-28 | Duże oko nie będzie gotowe na czwartek 29.10; do szkoły jadą małe oczy, PIR i przycisk | Użytkownik: „już widzę, że dużego oka nie skończę na jutro” |
| 2026-10-28 | Na czwartek 8 małych oczu: 4 po lewej, 3 po prawej i 1 na środku frontu (w miejscu przyszłego dużego oka); środkowe oko na kanale 7, jako czwarte serwo prawej skrętki | Użytkownik: „przyjmuję rozwiązanie z 8 małymi oczami” |
| 2026-10-29 | Na wystawę 4 małe oczy (lewa skrętka, kanały 0–3); pozostałe 4 i duże oko po terminie; firmware N_MALE = 4 (74a1979) | Użytkownik ok. 4:15: „Rezygnuję z ruszania się czterech oczu. Zostaną tylko cztery. Nie dam rady zrobić to”. Sprawdzone na sprzęcie: 4 oczy, przycisk blokady, powerbank 35,7 min bez restartu z obciążeniem IRLZ44N |
