senecjusz/Dynia-eyes/30-projekt/otwarte-2026-10-25.md

# Otwarte sprawy – stan 25.10 wieczorem (przenosiny do Warszawy)

Plan zadań: `30-projekt/plan.html`. Wymagania: `30-projekt/PRD.md`. Sesje agentów zostają na komputerze w Kobyłce. W Warszawie po `git pull` nowa sesja PM zaczyna od tego pliku.

## Do decyzji albo odpowiedzi użytkownika

1. **Uchwyt serw dużego oka – do analizy, potem decyzja** (użytkownik 25.10: mocowania poprowadzono od płyty najprostszą drogą bez oceny; rozważyć m.in. ramki przykręcane do serw, a potem do płyty). Szczegóły: `20-analizy/2026-10-25-uchwyt-serw-do-decyzji.md`. Dotychczasowe ustalenia – ramka S2: Opus i Astra w 2 rundach potwierdzili, że serwa S2 nie da się wsunąć w ramkę przy środkowym słupku. Błąd jest już w v9, który wydrukowałeś z błędem. Raporty: `20-analizy/review/2026-10-25-uchwyt-scianki-{opus,astra}{,-r2}.md`.
   - Wariant: ramka S2 przed uszami, serwo wsuwane od +x. Jest w `40-cad/openscad/duze-oko-v2.scad` za przełącznikiem `ramkaS2Zewn = false` (wyłączony). W pozycji zamontowanej nie ma kolizji: luz 0,30 mm w oknach, orczyki i pręty co najmniej 1,39 mm.
   - Astra r2: wariant też nie przechodzi przy wsuwaniu. Dolne ucho S2 trafia w skos podstawy wieży 1 przy odsunięciu ≥ 6,64 mm. Poprawka: wybranie w skosie i góra okna na z = −37,7 mm.
   - **Serwo SD:** dolne ucho blokuje się o niską ściankę słupek–wieża 3, potrzebne lokalne wybranie z luzem 0,30 mm. Projektant zgłosił, że ściankę usunął. Do sprawdzenia, czy SD wchodzi.
   - Rekomendacja PM: włączyć wariant, wprowadzić poprawki Astry r2, sprawdzić wsuwanie wszystkich 4 serw na siatkach, wyeksportować. Review jest po 2 rundach, więc dalej już tylko kontrola na siatkach, bez nowej rundy.
   - Pytanie pomocnicze: czy w wydrukowanym v9 serwo S2 dało się włożyć?
   - **Stan modelu:** w `duze-oko-v2.scad` są niewyeksportowane zmiany (żebra, ścianki, wariant). `40-cad/3mf/Duze oko v2/Uchwyt serw.3mf` to nadal v9 – **nie drukować**.
2. **Mocowanie PIR (P6).** Projektant podstawki pyta, co nie pasuje: (a) płytka nie wchodzi w szczelinę za czołem szufladki; (b) kopułka nie przechodzi przez otwór Ø24; (c) potencjometry lub piny kolidują z przegrodą; (d) coś innego. Najlepiej zdjęcie i wymiar.
3. **Grubość ścianki dyni przy otworze dużego oka.** W modelu jest 40 mm, Pierścień i Uchwyt działają od 28 do 50 mm. Po wycięciu otworu zmienia się jedną zmienną `scianka` i eksportuje 2 części.
4. **Kalibracja małych oczu.** Programista czekał na odpowiedź, czy oko na kanale 0 przy 1500 µs patrzy prosto. Jeśli nie, przełożyć Ramię i napisać „test”. Wspólne wartości wszystkich małych oczu: 1500/1100/1800 µs (`50-elektronika/kalibracja-oczu.md`). Moduł „8” buczy, ostatni chodzi ciężko.
5. **Program docelowy (S1).** Plan etapów `50-elektronika/dynia-v2-plan.md` czeka na zatwierdzenie (review Opus/Astra r1–r3 w `20-analizy/review/2026-10-24-dynia-v2-plan-*`). Do potwierdzenia: duże oko na kanałach 12–15 (lewo–prawo, góra–dół, powieka górna, powieka dolna).
6. **Gniazdo/breakout USB-C** (z 5,1 kΩ na CC) do zasilania z powerbanku – czy jest w warsztacie.

## Gotowe do druku (po review Opusa i Astry)

- `40-cad/3mf/Podstawka v1/Szuflada (X1C).3mf` – w całości na X1C, bez podpór. Blokada: śruba M4 × 25 imbus, w kołnierzu czoła Ø4,5, w sklejce otwór Ø3,3 na pełne 22 mm (bez stożka wiertła), 9 mm od boku, 19,5 mm nad dnem. Połówki A1 mini tylko jako zapas.
- `40-cad/3mf/Podstawka v1/Kaseta elektroniki.3mf` – 4 wkręty 3 × 12 do dna.
- Duże oko v9: Gałka, Powieki, Maskownica, Przedłużenia orczyka (bez Uchwytu i Pierścienia). „Probka drutu” jest nieaktualna.

## Stan faktyczny (dla nowej sesji)

- Dynia kupiona. Podstawka z drewna wykonana: dno 6 mm sklejone ze ściankami 40 mm, płyta górna 18 mm z otworem Ø60 na 4 wkrętach (na końcu), całość 254,8 × 222,8 × 64. Elektronika mocowana do dna, w dyni nie ma pudełka.
- Sesje w Kobyłce (do wglądu w aplikacji): projektant dużego oka, projektant podstawki, programista, krytyk.
