senecjusz/Dynia-eyes/20-analizy/2026-10-17-modul-malego-oka-wymiary.md

# Moduł małego oka – wymiary wstępne

Punkt wyjścia: piłeczka pingpongowa **Ø 40 mm** i montaż przez syna (patrz [mocowanie](2026-10-17-mocowanie-malego-oka.md)). Dynia prawdziwa, **wysokość 25–27 cm**. Wszystkie liczby to szacunki do sprawdzenia na wydruku testowym.

## Cel wizualny (punkt wejścia od użytkownika)

Kadr z filmu [68percentwater, 0:07](https://www.youtube.com/watch?v=ryUNHPJ3leY&t=7s):
- **brak ozdobnej oprawy**: gałka siedzi bezpośrednio w otworze wyciętym w miąższu,
- gałka jest **lekko cofnięta** i krawędź miąższu działa jak oczodół; szczelina wokół gałki ma ok. 3–7 mm,
- oczy rozsiane po całej dyni, mniej więcej 7 widocznych z jednej strony.

**Konsekwencja:** pierścień-oprawa nakręcany z zewnątrz (wariant A) **psuje ten efekt**. Mocowanie musi działać **wyłącznie od środka**, a z zewnątrz widać tylko miąższ i gałkę. Patrz wariant E w [mocowaniu](2026-10-17-mocowanie-malego-oka.md).

## Układ modułu (od zewnątrz do środka dyni)

```
  zewnątrz                ścianka dyni                 wnętrze
   ___                  |///////////|
  /   \  piłeczka       |///////////|      serwo SG90
 | (o) |==== jarzmo ====|== tuleja ==|== cięgno ==[ servo ]
  \___/                 |///////////|
  oprawa (pierścień     |///////////|  kołnierz tulei
  nakręcany przez syna)
```

- **Piłeczka** obraca się na osi pionowej (czopy góra/dół) zamocowanej w przedniej części tulei.
- **Jarzmo**: drukowany półpierścień „C” za piłeczką, trzyma ją na czopach i ma ramię korby.
- **Serwo SG90** siedzi z tyłu tulei, wewnątrz dyni. Z jarzmem łączy je drukowane cięgno, jak u 68percentwater.
- Z przodu wystaje **połowa piłeczki** (środek kuli w płaszczyźnie oprawy, ~20 mm ponad oprawę). Przy obrocie ±40° źrenica wciąż jest dobrze widoczna.

## Wyliczenie średnicy

| Element | Obliczenie | Wynik |
|---|---|---|
| Promień piłeczki | 40 / 2 | 20 mm |
| Luz piłeczka–jarzmo | | 0,75 mm |
| Grubość jarzma | | 2,5 mm |
| **Promień omiatania jarzma** przy obrocie | 20 + 0,75 + 2,5 | 23,25 mm |
| Luz jarzmo–tuleja | | 1 mm |
| **Średnica wewnętrzna tulei** | 2 × 24,25 | **~48,5 mm** |
| Ścianka tulei | | 2,4 mm (6 obrysów 0,4) |
| Średnica zewnętrzna tulei | 48,5 + 2 × 2,4 | ~53,3 mm |
| Gwint (grubszy, drukowany, skok ~3 mm) | + 2 × 1,8 | **~57 mm** |
| **Otwór w dyni** | gwint musi przejść + zapas na nierówny miąższ | **Ø 60 mm** |

Otwornica **60 mm** to rozmiar standardowy. Jeśli zestaw jej nie ma, kolejne typowe to 57 i 64 mm.

## Długość modułu

| Odcinek | mm |
|---|---|
| Piłeczka przed oprawą | ~20 |
| Oprawa (pierścień) | ~5 |
| Ścianka dyni (średnia dynia) | 20–30, gwint na **15–35** |
| Za ścianką: jarzmo, cięgno, serwo | ~45 |
| **Razem** | **~90–100**, z czego **~45–55 w środku dyni** |

Dynia 25–27 cm ma wnętrze o promieniu ok. 12 cm, więc moduły skierowane do środka zmieszczą się. Przy wielu oczach serwa trzeba **obracać względem siebie**, żeby ramiona nie kolidowały (uwaga z filmu 68percentwater).

## Oprawa i kołnierz

- Oprawa (pierścień nakręcany): Ø zewn. ~70–76 mm, z radełkiem do łapania palcami i strzałką „GÓRA”.
- Kołnierz tulei od środka: Ø ~76 mm, z ząbkami przeciw obracaniu.
- Szeroki docisk = mały nacisk na miąższ.

## Ile oczu zmieści dynia 25–27 cm

- Średnica dyni ~29–31 cm, obwód ~90–97 cm, przód (180°) ~45–49 cm.
- Rozstaw osi oczu: oprawa ~70 mm + ~15 mm miąższu = **~85 mm**. Mniej osłabia dynię.
- Użyteczna wysokość (bez szypułki i spłaszczonego dołu): ~14 cm, czyli **2 rzędy przesunięte o pół rozstawu** (układ plastra miodu).

| Rozmieszczenie | Ile oczu |
|---|---|
| Tylko przód | **~7–8** (4 + 3/4) |
| Dookoła dyni | **~16–20** |

**Wniosek:** piłeczka 40 mm jest w średniej dyni dość duża. Przy dużym oku (poziom 2, Ø 70–80 mm, otwór ~100 mm) z przodu zostaje miejsce na ~4–5 małych oczu, resztę trzeba dać na boki. Alternatywy: większa dynia albo małe oczy z mniejszych kulek, ale wtedy bez gotowej piłeczki.

## Do sprawdzenia na wydruku testowym
1. Luzy: piłeczka–jarzmo, jarzmo–tuleja, gwint tuleja–oprawa.
2. Czy gwint drukowany daje się nakręcić palcami dziecka (najlepiej trapezowy, skok 3–4 mm).
3. Zakres ruchu oka bez zahaczania o oprawę.

## Wariant F – wymiary gniazda

Gniazdo (tuleja z rantem + nakrętka) i moduł oka wsuwany w nie na bagnet. Patrz [mocowanie, wariant F](2026-10-17-mocowanie-malego-oka.md).

| Element | Obliczenie | Wynik |
|---|---|---|
| Średnica zewn. tulei modułu | z tabeli wyżej | ~53,3 mm |
| Luz moduł–gniazdo (bagnet) | 2 × 0,6 | 1,2 mm |
| **Średnica wewn. gniazda** | 53,3 + 1,2 | **~54,5 mm** |
| Ścianka gniazda | | 2,4 mm |
| Średnica zewn. gniazda | 54,5 + 2 × 2,4 | ~59,3 mm |
| Gwint pod nakrętkę (tylko wewnętrzny koniec, skok ~3 mm) | + 2 × 1,5 | ~62,3 mm |
| **Otwór w dyni** | gwint musi przejść przez otwór | **Ø 64 mm** (otwornica standardowa) |
| **Rant (zewnątrz)** | otwór + 2 × 4 mm zakładki | **Ø ~72 mm**, grubość ~2 mm |
| **Kołnierzyk rantu (do wewnątrz)** | gałka 40 + 2 × 1,5 mm szczeliny | **Ø ~43 mm**, czyli widać gałkę i wąską szczelinę |
| Nakrętka (od środka) | | Ø ~76 mm, ze skrzydełkami |
| Długość gwintu | ścianka 20–30 mm + zapas | zakres docisku **15–35 mm** |

Wpływ na liczbę oczu: rant Ø 72 mm zamiast oprawy ~70–76 mm, więc rozstaw ~85–90 mm i szacunek **~7–8 oczu z przodu** zostaje bez zmian.

### Klucz do nakrętki (pomysł użytkownika)

Drukowany **klucz nasadowy pod grzechotkę**, dzięki któremu nakrętkę może dokręcić także syn.

- **Nakrętka:** zamiast skrzydełek (albo obok nich) na obwodzie **4–6 wycięć** jak w nakrętce koronowej. W nie wchodzą zęby klucza.
- **Klucz:** kubek z zębami na krawędzi. W środku jest **pusty**, bo nakłada się go na wystający koniec gniazda; głębokość ~30 mm pokrywa najcieńszą ściankę dyni. Na dnie **gniazdo pod kwadrat grzechotki**, **3/8" (9,525 mm)**, bo taka jest grzechotka w warsztacie (są też przejściówki na 1/2" i 3/4"). W wydruku otwór ~9,8 mm (luz ~0,3 mm, do kalibracji), z fazą na wejściu i z rowkiem pod kulkę zatrzaskową grzechotki.
- **Uwaga na siłę:** grzechotka daje dużą dźwignię, a miąższ i drukowany gwint łatwo przeciągnąć. Zasada: kręcić tylko do wyraźnego oporu. Opcjonalnie w kluczu **sprzęgło przeciążeniowe**: zęby skośne, które przeskakują przy zbyt dużej sile (wersja 2, jeśli zwykły klucz się nie sprawdzi).
- Klucz jest wspólny dla wszystkich gniazd, więc to jeden wydruk.
