senecjusz/Dynia-eyes/10-inspiracje/arduino-servo-pumpkin-eyes-68percentwater.md

# Arduino servo pumpkin eyes – 68percentwater

- **Link:** [YouTube](https://www.youtube.com/watch?v=ryUNHPJ3leY&t=13s) (3:22, ~10 lat temu, 87 tys. wyświetleń)
- **Opis autora:** dynia z oczami z plastiku poruszanymi przez serwa sterowane Arduino.
- **Poziom:** 1 – **punkt wyjścia dla najprostszego rozwiązania** (wybór użytkownika).

## Co widać na filmie (z klatek i napisów)
- Prawdziwa dynia, kilkanaście oczu rozsianych po całej powierzchni.
- Każde oko to **moduł w białej rurce** (wygląda na PVC): gałka z przodu, w rurce patyczek jako oś lub cięgno, **serwo z tyłu rurki**, połączone z mechanizmem **drutem**.
- Moduły wsunięte w otwory **od środka dyni**. Napis: każdy zespół serwa jest obrócony tak, by ramiona serw nie kolidowały, a potem **sklejony na gorąco z sąsiednim** zespołem, żeby trzymał się na miejscu.
- Wyłącznik przyklejony na gorąco do zaostrzonego patyczka wbitego w dynię.

## Co bierzemy
- **Koncepcja modułu-rurki**: przez ściankę dyni przechodzi tylko rurka o średnicy niewiele większej od gałki, a serwo siedzi z tyłu, w środku dyni. Dzięki temu otwór jest mały, a ruch oka nie zależy od grubości ścianki.
- Potwierdzenie, że wiele małych oczu w prawdziwej dyni działa i dobrze wygląda.

## Co robimy inaczej
- Rurka, oś i cięgno **drukowane** zamiast PVC, patyczka i drutu.
- Mocowanie modułu **gwintem z pierścieniem**, które syn zakłada sam, zamiast kleju na gorąco.
- Serwa obrócone różnie, żeby ramiona nie kolidowały, to dobra uwaga: w module warto przewidzieć **kilka pozycji serwa** albo zwarty napęd w osi rurki.
