senecjusz/Dynia-eyes/10-inspiracje/pumpkin-eyes-kent-harris.md

# Pumpkin Eyes – Kent Harris (Clark)

- **Link:** [YouTube – Pumpkin Eyes Video](https://www.youtube.com/watch?v=kTkNVE17_lc) (60 s, ~5 lat temu)
- **Opis autora:** mechaniczne oko na Arduino do dyni na Halloween; pierwsze oko działa, drugie w budowie.
- **Poziom:** pośredni między 1 a 2 – małe oko **z jedną powieką**.

## Co widać na filmie (z klatek, bez dokumentacji)
- Biała gałka z namalowaną tęczówką, wielkości zbliżonej do piłeczki pingpongowej.
- **Pomarańczowa drukowana czasza** otaczająca gałkę – wygląda jak powieka obracająca się na poziomej osi przez środek oka, z odsłoniętą szparą pośrodku.
- Mikroserwo (wygląda na SG90) zamocowane **z boku**, napęd powieki od boku.
- Całość na drukowanej ramce z nóżką / podstawą.

## Co bierzemy
- **Kolor powieki = kolor dyni** – oko wygląda, jakby wyrastało z dyni. Świetne do prawdziwej dyni.
- Wariant „małe oko + powieka” jako opcja pośrednia: 2 serwa na oko (gałka lewo–prawo + powieka).
- Uwaga dla modułu: serwo z boku poszerza moduł – ma wpływ na średnicę otworu w dyni.
