senecjusz/Dynia-eyes/10-inspiracje/mechanizmy-oka-zrodla.md

# Mechanizmy oka – źródła

Źródła wyciągnięte z researchu Gemini: [20-analizy/2026-10-17-mechanizm-oka](../20-analizy/2026-10-17-mechanizm-oka/whitepaper.md).
Linki zbudowane z identyfikatorów w dokumencie – warto kliknąć i sprawdzić, czy prowadzą tam, gdzie trzeba.

## Piłeczka pingpongowa Ø 40 mm (poziom 1)

| Projekt | Link | Co bierzemy |
|---|---|---|
| LOOK MUM NO COMPUTER – Kosmo Eye | [YouTube](https://www.youtube.com/watch?v=fufVeOHFu5Q) | **Kandydat nr 1:** widełki C na wale SG90, ruch bez popychaczy; opcjonalnie 2. oś przez elastyczny łącznik |
| Cat's Menagerie | [YouTube](https://www.youtube.com/watch?v=gDrjgVRJONA) | Kołek przelotowy + gwóźdź jako korba, ścianka piłeczki nie przenosi sił |
| PyroElectro – robotic eyes | [YouTube](https://www.youtube.com/watch?v=4xEqbry2gFk) | Gimbal 2-osiowy z pierścienia PVC |
| Tioh – powieka do piłeczki 4 cm v3 | [Printables 95892](https://www.printables.com/model/95892) | Gotowa powieka do piłeczki |
| Eyes in a Box, Rock On! | Instructables (brak linku w dokumencie) | Śruby M3 przyklejone na biegunach; wnętrze wolne na LED |

## Duże oko drukowane 70–80 mm (poziom 2)

| Projekt | Link | Co bierzemy |
|---|---|---|
| Will Cogley – V2 Simplified | [YouTube](https://www.youtube.com/watch?v=Ftt9e8xnKE4) | Sztywne drukowane popychacze, kołyska dla osi góra–dół |
| Will Cogley – V3 | [YouTube](https://www.youtube.com/watch?v=ihXxbQefl1c) | Wewnętrzny kardan |
| Will Cogley – V4 Zero Fasteners | [YouTube](https://www.youtube.com/watch?v=uzPisRAmo2s) | Zatrzaski zamiast śrub |
| EyeMech E31 | [Printables 1220172](https://www.printables.com/model/1220172) | Gotowy mechanizm oka z powiekami |
| Polymaker – Luke Taylor | [YouTube](https://www.youtube.com/watch?v=Y0upri54Jhs), [Thingiverse 1152248](https://www.thingiverse.com/thing:1152248) | Łożyska w przegubach, większe serwa |
| Stan Winston School | [YouTube](https://www.youtube.com/watch?v=8fTt1kiLn7c) | Swash plate, regulacja wysunięcia oka |
| Paul's Bots | [YouTube](https://www.youtube.com/watch?v=3a2vmJmOzxY) | Dwie niezależne powieki |
| Aqua Cat | [YouTube](https://www.youtube.com/watch?v=s0av1qdiazU) | Płaskie popychacze |
