senecjusz/Dynia-eyes/70-budowa/zdjecia/MANIFEST.md

# Manifest zdjęć

Opis każdego zdjęcia w `70-budowa/zdjecia/`. **Najpierw czytaj manifest, zdjęcie otwieraj tylko wtedy, gdy opis nie wystarcza** (oglądanie zdjęć zużywa dużo kontekstu).

## Zasady

- Jeden podfolder na temat: `RRRR-MM-DD-temat/` (np. `2026-10-25-pir/`); pliki `temat-NN.jpg|png`, zmniejszone (dłuższy bok ≤ 1600 px).
- Surowe zdjęcia i filmy: `70-budowa/raw/` (poza Gitem).
- Kto dodaje zdjęcie, dopisuje od razu wiersz poniżej. Zdjęcie bez wiersza = niedokończone.
- **Wymiary:** liczba, jednostka, dokładność i skąd skala (linijka obok, suwmiarka, proporcja do znanego wymiaru). Pomiar ze zdjęcia oddzielaj od pomiaru suwmiarką.
- **Użyte w:** plik, w który wymiar trafił (PRD, model, analiza), żeby było widać, co z tego wynika.

## Zdjęcia

| Plik | Data | Co pokazuje | Odczytane wymiary (dokładność, źródło skali) | Użyte w |
|---|---|---|---|---|
| `2026-10-25-pir/pir-01.png` | 2026-10-25 | PIR HC-SR501 z boku, soczewka z lewej, na płycie roboczej (zrzut okna kamery C920) | bez skali: z tyłu płytki kondensator leżący, żółta zworka, piny listwy – „ok. 10–12 mm” na oko (±3 mm, brak skali; zastąpione przez pir-05 i pir-09) | rozpoznanie przyczyny P6 (`30-projekt/PRD.md` 0.2 §5) |
| `2026-10-25-pir/pir-02.png` | 2026-10-25 | tył płytki HW-416A: BISS0001, stabilizator, 2 potencjometry, 4 kondensatory (3 na rogach wystają poza obrys), listwa 3-pin u góry na środku, zworka w lewym dolnym rogu | kondensatory poza obrysem płytki ok. 1,5 mm (±1, proporcja do płytki 32 mm) | `40-cad/openscad/podstawka.scad`: `pirRogi`, okno PIR (`oknoPIRzap`), bryły PIR do kontroli kolizji |
| `2026-10-25-pir/pir-03.png` | 2026-10-25 | przód płytki: kwadratowa podstawa soczewki na środku, po bokach paski z lutami (rząd u góry i u dołu), otwory montażowe w połowie wysokości | paski boczne ok. 4,5 mm (±1, proporcja do płytki 32 mm) | `podstawka.scad`: luty PIR (`pirLut`, bryły lutów), słupki M2 w połowie wysokości |
| `2026-10-25-pir/pir-04.png` | 2026-10-25 | bok płytki: kopułka z przodu, kondensatory prostopadle do płytki z tyłu | kopułka ok. 11 mm, elementy za płytką 9–10 mm (±2, skala z szerokości płytki 32 mm, perspektywa; zastąpione przez pir-05 i pir-09) | – |
| `2026-10-25-pir/pir-05.png` | 2026-10-25 | bok płytki z linijką stalową przy krawędzi | kopułka 12–13 mm przed płytką, kondensator górny ze zworką 9,5 mm, dolny 47 µF 8 mm, piny listwy 4,5 mm, płytka ok. 1,2 mm (±1, linijka ok. 28 px/mm, perspektywa) | PRD 0.2 §5 (za płytką ≥ 10 mm) |
| `2026-10-25-pir/pir-06.png` | 2026-10-25 | bok od strony potencjometrów (pokrętła w bok), dolny kondensator 47 µF, zworka | potencjometry ok. 10 mm, kondensator górny ok. 11 mm za płytką, kopułka ok. 13 mm (±1,5, linijka dalej od płytki niż płytka) | PRD 0.2 §5: potencjometry i zworkę ustawić przed montażem |
| `2026-10-25-pir/pir-07.png` | 2026-10-25 | ukos od tyłu: piny listwy 3-pin prostopadle do tyłu | piny z plastikiem 6–7 mm (±1,5, proporcja do płytki); wtyki Dupont dodają ok. 14 mm (typowa długość obudowy, nie pomiar) | PRD 0.2 §5: z wtykami Dupont ok. 20 mm; `podstawka.scad`: `pirDupont` 20 |
| `2026-10-25-pir/pir-08.png` | 2026-10-25 | przód płytki z linijką obok (linijka dalej niż płytka – skala linijki zawyża) | kołnierz soczewki ok. 23 mm (71 % szerokości płytki 32 mm), paski z lutami ok. 4,5 mm, otwory ok. Ø2 ok. 1,5–2 mm od krawędzi, rozstaw osi 28–29 mm (±1, proporcja do płytki 32 mm, nie do linijki) | PRD 0.2 §5 (kołnierz 23 × 23, otwory 28–29); `podstawka.scad`: `pirKol`, `pirGn` 23,5, `pirOtwRozst` 28,5 (do pomiaru suwmiarką) |
| `2026-10-25-pir/pir-09.png` | 2026-10-25 | płytka leżąca soczewką do góry, linijka pionowo tuż obok | kołnierz soczewki 3 mm wys., kopułka 11 mm nad kołnierzem (razem 14 od płytki), płytka 1,5 mm, elementy pod płytką 8 mm (±0,5, linijka ok. 27 px/mm przy płytce) | PRD 0.2 §5 (kołnierz 3, kopułka 14, 32 × 24 × 1,5); `podstawka.scad`: `pirKolH`, `pirKopH`, `pirT`, `pirTyl` |
| `2026-10-26-probka-pir/probka-pir-01.jpg` | 2026-10-26 | wydrukowana próbka gniazda PIR (`Szuflada v2 - probka gniazda PIR.3mf`) od lica, PIR włożony: kopułka w otworze Ø24, równo na środku; przy krawędzi otworu cienka linia w prawo (ok. godz. 2) i biała plamka (ok. godz. 4) – do wyjaśnienia: rysa czy ślad druku; półokrągłe wcięcie na prawej krawędzi = połowa otworu M3 (granica wycinka) | bez pomiaru; kopułka mieści się w Ø24 z widocznym luzem na obwodzie | `30-projekt/raport-montaz.md` (próbka PIR zaliczona), `20-analizy/2026-10-25-podstawka-model.md` |
| `2026-10-26-probka-pir/probka-pir-02.jpg` | 2026-10-26 | ta sama próbka od tyłu: płytka HW-416A przykręcona 2 wkrętami M2 w słupki, leży płasko; listwa 3-pin przy krawędzi bliższej górze frontu (próbka odwrócona do zdjęcia), kondensatory i zworka w obrysie płytki | rozstaw otworów M2 28,5 pasuje (oba wkręty weszły bez gięcia płytki – ocena wizualna) | `podstawka.scad`: `pirOtwRozst` 28,5 potwierdzony próbką |
| `2026-10-25-kardan-5-5/kardan-01.png` | 2026-10-25 | Kardan 5/5 zgięty do oporu, widok z góry, linijka cm pod spodem (nie w płaszczyźnie osi) | zgięcie do oporu ok. 90° (±15°, ocena ze zdjęcia, oś piasty częściowo w skrócie perspektywicznym); obrys zgiętego ok. 23 × 17 mm (skala z linijki, ok. 52 px/cm, ±1 mm); A i B nieczytelne w tym ułożeniu | `20-analizy/2026-10-25-referencja-face-maker101-synteza.md` (przegub gałki) |
| `2026-10-25-kardan-5-5/kardan-02.png` | 2026-10-25 | Kardan 5/5 wyprostowany, z boku, na krawędzi linijki cm; widoczny łeb sworznia krzyżaka | długość ok. 26 mm (zgodna z 25,5 z suwmiarki); **A: czoło piasty → oś sworznia ok. 13 mm z obu stron** (krzyżak w połowie długości); **B: widełki przy krzyżaku Ø11 jak piasty (użytkownik: „szerokość to zawsze 11 mm”)**; dokładność ±1 mm (linijka ok. 44 px/cm, perspektywa) | `30-projekt/e6-pomiary.md`, synteza referencji |
| `2026-10-26-drut-z/drut-z-01.jpg` | 2026-10-26 | Drut sprężynowy Ø1,2 zgięty ręcznie w „Z” przez użytkownika, na suwmiarce (skala cm) | noga ok. 7 mm, ogon ok. 5–6 mm, promień gięcia ok. 1–1,5 mm (±0,5 mm, skala z podziałki suwmiarki ok. 11,8 px/mm) – realne gięcie kombinerkami | wymiary zaczepu „Z” dużego oka v3 (do przeprojektowania) |
| `2026-10-26-drut-z/drut-z-02.jpg` | 2026-10-26 | Dwa druty Ø1 zgięte ręcznie w „Z”, przy podziałce suwmiarki (pionowo) | noga ok. 5 mm (górny) i ok. 7 mm (dolny), ogon ok. 4–5 mm przed skróceniem, promień gięcia ok. 1 mm (±0,5 mm, ok. 12,5 px/mm); użytkownik: ogon (pierwsze gięcie) można po zgięciu skrócić | wymiary zaczepu „Z” dużego oka v3 (do przeprojektowania) |
| `2026-10-28-serwa-plyta/serwa-01-przed.jpg` | 2026-10-28 | Płyta dużego oka v3 z serwami G–D i powieki dolnej wciśniętymi na sucho, z boku (+x); G–D z orczykiem stoi wałkiem na dole (odwrotnie niż w modelu) | brak wymiarów; podstawa ustalenia: kabel MG90S wychodzi po stronie wałka (użytkownik 28.10) | `40-cad/openscad/duze-oko-v3-montaz.md` krok 3 |
| `2026-10-28-serwa-plyta/serwa-02-po-odwroceniu.jpg` | 2026-10-28 | Ta sama płyta po poprawce: G–D wałkiem u góry, kabel górą; serwa powiek wałkiem na dole, kable przez wnęki wycięte ręcznie w płycie | wysokości wałków nieodczytane (perspektywa); układ zgodny z rysunkiem `plyta-wneki-kabli.png` | `40-cad/openscad/duze-oko-v3-montaz.md` krok 3 |
| `2026-10-28-serwa-plyta/serwa-03-pret-gd.jpg` | 2026-10-28 | Gałka na kardanie, pręt G–D założony w słupek G–D i w orczyk G–D; orczyk G–D ma piastę na dole serwa (wałek ok. 5,5 nad płytą, ramię do góry), kabel G–D wychodzi górą | wałek G–D nisko zamiast 17,3 nad płytą (ocena ze zdjęcia, bez skali) | `40-cad/openscad/duze-oko-v3-montaz.md` kroki 3 i 6 |
