senecjusz/Dynia-eyes/20-analizy/review/2026-10-25-szuflada-v2-fable.md

# Review szufladki v2 podstawki (korpus, front, rączka, blokada, PIR) – Fable, 25.10

Zakres: działanie, montaż, druk. Dane: `40-cad/openscad/podstawka.scad` (v2, 22:07), siatki `40-cad/3mf/Podstawka v2/`, PRD 0.2 §5, zdjęcia PIR. Własne uruchomienia (OpenSCAD 2021.01, katalog tymczasowy): `podstawka-kolizje.sh` (5 kontroli), `podstawka-eksport.sh` z `OUT3MF` (Korpus, Front, Raczka, Kaseta), `sprawdz_siatki.js`, `skladowe_siatki.js`, `podstawka-wymiary.js`, porównanie trójkątów siatek (własny skrypt), odczyt położeń otworów z siatek. Układ: korpus (x od lewego boku korpusu, y od przedniej ściany, z od spodu korpusu); podstawka = korpus + (18,5; 0; 9).

## Wyniki punktów briefu

1. **Zgodność ze stanem wykonanym i PRD 0.2.** Model: `WIN` 216, `H_IN` 40, `tDno` 9, `tPl` 18 → skrzynka 252 × 226 × 67, otwór płyty Ø60, 4 wkręty płyty 9 od boku / 20 od przodu i tyłu, ścianka tylna 18 (założenie). Rysunek `podstawka-ciecie.png` pokazuje te same liczby i blokadę: Ø3,3 × 22 w przedniej krawędzi, 126 od boku, 9 pod wierzchem. PRD: korpus 215 ≤ 215, ścianki 2,0, wtyk 50, front osobno, rączka M4 wklejana, blokada M4 w płytę, PIR Ø24 / gniazdo 23,5 / 2 × M2 / 22 mm za płytką – wszystko w modelu. Asserty (21) przechodzą. Zgodne.
2. **Korpus w podstawce.** Luz boczny (216 − 215) / 2 = 0,5 na stronę; wysokość 32 pod wnętrzem 40 (8 mm), powerbank 2 + 32 = 34 → 6 mm pod płytą; tył korpusu y 102, przód kasety y 107 (5 mm); kaseta x 63–233 za korpusem, nie obok. Kontrole CGAL `KolizjaZamknieta`, `KolizjaWsuwanie` (0/30/60/90): puste. Wycięcie kablowe x 195,6–207,6, z 12–32 (otwarte do góry) na osi gniazda zasilania kasety (x 220,1 podstawki = 201,6 korpusu); wtyk 50 od czoła portu (x 163) do 213 = lico prawej ścianki; słupki pb (x 164–168, y 29–37 i 92–100, h 14) poza portem (y 64). Gniazdo kasety 53 mm za tylną ścianką korpusu (assert 152 ≤ 155).
3. **Front.** 244 × 65 × 4, x 4–248 podstawki: zakładka 14 na ścianki (18), 17 na płytę, 8 na krawędź dna; 1 nad stołem, 1 pod wierzchem płyty. Druk: lico na stole, słupki M2 (Ø4,5 × 2,5) i gniazdo kołnierza 0,5 od góry, wszystkie otwory pionowe – bez podpór, bez nawisów. Sztywność: 4 mm na całej szerokości podparte ścianą korpusu (215) i krawędziami sklejki; wystają tylko zakładki 14/17/8 – wystarczy.
4. **Front–korpus.** Otwory na siatce korpusu: M4 (92,5; 17) i (162,5; 17) Ø4,5; M3 (10; 8) i (205; 8) Ø3,3 – jak w modelu. M4 × 35: spod łba (y −28) do y 7, nakrętka kończy się na y 6 (front 4 + ścianka 2 + podkładka 0,8 + nakrętka 3,2) → 1 mm zapasu; × 40 kończy na y 12 < przegroda 26. M3 × 10: koniec y 6, nakrętka do y 4,4. Nakrętki w kieszeni PIR (y 2–26), 23 mm przed powerbankiem (y 29). M3 lewa x 6,8–13,2 wobec okna PIR 22–58 (kondensator narożny do x 22,5) – 9 mm; M4 lewa podkładka Ø14 do x 85,5 – 27 mm od okna. `KolizjaSruby`: pusto. Dostęp do nakrętek: tylko z góry, kieszeń 24 × 30 mm (uwaga 7).
5. **Rączka.** Pałąk 86 × 14 × 8, stopy 16 × 14 × 28, prześwit między stopami 54, za pałąkiem 20. Gniazdo łba na siatce: Ø8 na 4,5 głębokości, potem Ø4,5 (promienie 4,0 / 2,25). Szarpnięcie: droga siły łeb → dno gniazda (pierścień 1,75 mm, 34 mm²) → front → ścianka 2 mm pod podkładką Ø14 (138 mm²) → nakrętka; przy 200 N nacisk 1,5 MPa – bez ryzyka; epoksyd tylko przeciw obracaniu. Druk licem na stole: fazka 1,5 przy stole (nawis 45°), stopy jako słupki 20 mm – bez podpór. Pole widzenia PIR: najbliższa krawędź pałąka (x 84,5, y −32) widziana z kopułki (x 40) pod 58° (od lica frontu) – 65° (od czoła kopułki) od osi; stożek HC-SR501 ±50–60° – pałąk na granicy, bez wpływu na działanie.
6. **Blokada.** Oś x 126 = SZ/2 (front x 107,5 korpusu + 18,5), z 58 = 9 + 40 + 9 – połowa grubości płyty; otwór pilotowy Ø3,3 × 22, śruba M4 × 25 wchodzi 21. Wkręty płyty (x 9 / 243, y 20) 117 mm w bok; kołnierz tulei od y 53 (31 mm), wkręty tulei ≥ 48 mm. Łeb Ø7 na froncie z 54,5–61,5, góra frontu 66 (4,5 zapasu), rączka 25 mm niżej. Śruba przez front w krawędź płyty blokuje wysunięcie; korpus trzyma front przez 4 śruby. Trafienie: uwaga 2.
7. **PIR.** Gniazdo kołnierza na siatce 23,5 × 23,5 × 0,5 (x 28,25–51,75), otwór Ø24, słupki M2 na x 25,75 / 54,25 (rozstaw 28,5), otwór Ø1,7 × 5 od czoła słupka (kończy 1,5 przed licem). Płytka 2,5 za tyłem frontu: luty 2 → 0,5 luzu. Okno korpusu x 22–58, z 3–31 (36 × 28) wobec płytki 24–56 / 5–29 z kondensatorami do 22,5: 1,5 mm. Za płytką 4–26 = 22 mm (Dupont 20). `KolizjaPIR`, `KolizjaWkladaniePIR` (przemiatanie 30 mm): puste. Zdjęcia (pir2, pir6, pir9): listwa u góry, potencjometry i zworka u dołu w obrysie, elementy z tyłu ≤ 8 mm – zgodne z modelem. Przewód: uwagi 3 i 4.
8. **Siatki.** Wszystkie 8 plików: 0 otwartych, 0 nierozmaitościowych, 0 zdegenerowanych, 1 bryła; wymiary korpus 215 × 102 × 32, front 244 × 65 × 6,5, rączka 86 × 14 × 28 = parametry. Mój eksport = pliki w repo (korpus 576/576, front 1428/1428, rączka 700/700 trójkątów identycznych). Kaseta v2 = kaseta v1: 2212/2212 trójkątów identycznych, bbox 170 × 100 × 25.

## KRYTYCZNE

Brak.

## WAŻNE

1. **PIR – wymiary ze zdjęć (±1 mm) wobec luzów 0,25–0,5** (`pirKol` 23, `pirKopD` 23, `pirOtwRozst` 28,5). Scenariusz: rozstaw 28 albo 29 zamiast 28,5 → M2 (Ø2) w otworach płytki Ø2 przesunięte o 0,25 na stronę nie wejdą; kopułka ≥ 24 nie przejdzie przez Ø24; kołnierz > 23,5 nie wejdzie w gniazdo (wtedy płytka stanie 0,5 dalej – M2 nadal trzyma 4 mm). Poprawka: przed drukiem frontu zmierzyć suwmiarką rozstaw otworów (zewnętrzna krawędź – zewnętrzna − 2), bok kołnierza i średnicę kopułki; wpisać zmienne. Test: wydruk próbki 60 × 40 × 4 z samym gniazdem PIR (otwór, gniazdo, 2 słupki). Pewność wysoka co do ryzyka, średnia co do błędu.
2. **Blokada – trafienie w otwór pilotowy.** Korpus ma ±0,5 luzu bocznego, front wycentrowany na korpusie, otwór Ø4,5 daje 0,25 promieniowo; trasowanie „126 od boku, 9 pod wierzchem” ręcznie to kolejne ±0,5. Scenariusz: śruba wchodzi skośnie, gwint w krawędzi sklejki krzywy albo śruba nie trafia. Poprawka: wiercić otwór pilotowy Ø3,3 przez otwór frontu przy zamkniętej, wycentrowanej szufladce (wiertło w Ø4,5 ma 0,6 luzu); dodatkowo otwór blokady we froncie Ø5 (łeb Ø7 ma 1 mm oparcia). Pewność wysoka.
3. **Przewody przy ruchomej szufladce (brak w modelu).** USB-C: port na y 64, żeby go wypiąć ręcznie, szufladka musi wyjechać ≥ ~85 mm (port przed płytą + miejsce na palce); przewód od wycięcia (y 102) do gniazda kasety ma 53 mm przy zamkniętej, więc między wtykiem a gniazdem kasety potrzeba ≥ 100 mm wolnego kabla, przy całkowitym wysunięciu ≥ 150. PIR: w szufladce od kieszeni przez przegrodę, nad powerbankiem (6 mm) do wycięcia ≈ 100 mm, dalej od wycięcia (x 220, y 102) do ESP32 (x ≈ 90, y ≈ 130) 133 mm przy zamkniętej, 190 przy wysunięciu 110 → ≥ 60 mm luzu, ≥ 350 mm całego przewodu. Scenariusz: wysunięcie wyrywa wtyk z gniazda kasety albo Dupont z listwy PIR. Poprawka: długości jak wyżej, luz układać po lewej od kasety (x 18–63, 45 mm wolnego). Pewność wysoka (obliczenie), zależna od kabli w warsztacie.
4. **Dupont za PIR a przegroda.** Listwa u góry płytki, wtyki 20 mm do y 24, przegroda y 26–28 pełnej wysokości 30: przewody muszą zagiąć się o 90° w górę na 2 mm – promień gięcia Dupont ≥ 5. Scenariusz: naprężone przewody wypychają wtyki albo przegroda dociska je przy nasuwaniu frontu. Poprawka: wycięcie 12 × 8 w górnej krawędzi przegrody na osi listwy (x 34–46, od z 24; powerbank 32 wysoki nadal zatrzymany) albo przewód wlutowany bez listwy (PRD dopuszcza, wtedy ≥ 10 mm). Pewność średnia.

## DROBNE

5. Okno PIR w przedniej ścianie korpusu zostawia mostek 1 × 2 mm (z 31–32) o rozpiętości 36 – drukuje się, może zwisać; prościej otworzyć okno do góry (cięcie do z 32). Pewność wysoka.
6. Łeb M4 w modelu Ø7 × 4 = DIN 912 (walcowy). Jeśli „okrągły” znaczy ISO 7380 (kulisty): Ø7,6 × 2,2 → luz w gnieździe Ø8 0,2, łeb 2,3 pod licem – działa, ale gniazdo od strony stołu (stopka słonia) może wymagać rozwiercenia do Ø8. Sprawdzić łeb w magazynie.
7. Nakrętki M3 (z 8, 4,8 nad dnem kieszeni) i M4 w kieszeni 24 × 30 mm – tylko z góry, kluczem płaskim 5,5 / 7 albo szczypcami; opcja: gniazda sześciokątne (5,5 / 7 + 0,2, głębokość 2,4 / 3,2) od tyłu przedniej ściany korpusu.
8. Blokada pod dynią: łeb 5,5–12,5 pod wierzchem płyty na środku przodu; dynia ~Ø300 na płycie 226 wystaje ~35 mm przed krawędź – imbus z długim ramieniem (≥ 100 mm) poziomo; sprawdzić po postawieniu dyni.
9. Wysokość skrzynki 67 wynika z 9 + 40 + 18 (nominalne), nie z pomiaru całości; front sięga 66. Przy całkowitej wysokości < 66,5 front dotyka dyni – zmierzyć; `frontPodGora`.
10. Słupki M2 Ø4,5 / otwór Ø1,7: ścianka 1,4; gwint trzyma głównie 2,5 mm w płycie – wkręcać M2 bez siły.
11. Luty z przodu płytki 2 mm → 0,5 luzu do tyłu frontu; wyższe luty odsuną płytkę o ≤ 0,5 – M2 ma zapas (4 mm wejścia). Bez zmian.
12. Fazka rączki działa tylko między stopami (stopy 16 × 14 pełne na licu) – kosmetyka. Front 244 × 4 w PLA: brim.

## Werdykt

Korpus, front i rączkę v2 można drukować: korpus i rączkę od razu, front po zmierzeniu suwmiarką rozstawu otworów, kołnierza i kopułki PIR (uwaga 1), a otwór pilotowy blokady wiercić przez front (uwaga 2).
