senecjusz/Dynia-eyes/20-analizy/review/2026-10-24-dynia-v2-plan-brief-r2.md

Jesteś recenzentem. Tylko do odczytu: bez git pull, commitów, zmian w plikach. Piszesz po polsku, krótko.

Oceń krytycznie `50-elektronika/dynia-v2-plan.md`: tabelę funkcji obecnego firmware'u `50-elektronika/dynia/` (README.md i kod) i propozycję etapów odchudzonego programu `dynia-v2`. Jedyne wymagania: `30-projekt/PRD.md` §5–6 (sprzęt: ESP32-C3 SuperMini + PCA9685, 8 małych oczu SG90 lewo–prawo, duże oko 3 × MG90S: lewo–prawo, góra–dół, powieki razem na jednym serwie; PIR HC-SR501; zasilanie z powerbanku). Kalibracja modułów jest już zrobiona osobnym programem `50-elektronika/kalibracja/` z tabelą `50-elektronika/kalibracja-oczu.md`. Do ponownego użycia: `50-elektronika/oczy-ruch/`, `test-powerbank-wifi/`. Dynia stoi w szkole od 28.10.

Sprawdź: czy tabela jest zgodna z kodem (co robi, czy PRD tego wymaga, złożoność); czy etap 1 pokrywa minimum potrzebne, żeby dynia działała w szkole, i nie zawiera nic ponad PRD; czy kolejność etapów nie wymusi przepisywania kodu później; ryzyka techniczne etapu 1 (start bez skoku, prąd przy starcie wielu serw z powerbanku, NVS).

Zasada: NIE dopisuj funkcji. Propozycje poza PRD osobno, najwyżej 3 linie.
Wagi: KRYTYCZNE / WAŻNE / DROBNE z miejscem, scenariuszem, poprawką. Na końcu werdykt jednym zdaniem: czy plan etapu 1 można dać użytkownikowi do zatwierdzenia.

Runda 2: plan poprawiono po review Astry i Opusa (20-analizy/review/2026-10-24-dynia-v2-plan-astra.md i -opus.md). Decyzja PM 24.10: Wi-Fi AP stale od etapu 1 jako obciążenie powerbanku (tymczasowe rozstrzygnięcie E0); strona dopiero w etapie 3. Sprawdź, czy uwagi są zamknięte i czy poprawki nie dodają nic ponad PRD. Krótko.
