senecjusz/Dynia-eyes/20-analizy/review/2026-10-25-podstawka-v2-astra.md

Review P7/P5: **brak uwag „PSUJE DZIAŁANIE ALBO DRUK”.**

1. **Stan wykonany:** model i rysunek cięcia zgodne: dno 6, ścianki 40, płyta 18 mm; całość **254,8 × 222,8 × 64 mm**, otwór Ø60, cztery wkręty 9 mm od boków i 30 mm od przodu/tyłu.
2. **Szufladka:** luz boczny **1,5 mm/stronę**, nad powerbankiem **6 mm**, do kasety **2 mm**, nad czołem **1 mm**. Kontrola siatek przy wysuwaniu 0–120 mm: brak przenikania, tylko zamierzone styki. Powerbank odsłonięty po wysunięciu 98,4 mm; korpus opuszcza podstawkę przy 101,8 mm.
3. **Blokada M4:** oś 9 mm od obu lic sklejki, 19,5 mm nad dnem. Wokół pilota Ø3,3 pozostaje **7,35 mm** materiału do lic; do wkrętu płyty przy y=30 minimum **6,25 mm**. M4×25 przechodzi przez kołnierz 3 mm i wchodzi 22 mm w ściankę. Łeb Ø7 zatrzymuje kołnierz, mieści się z zapasem 5,5 mm do jego prawej krawędzi; bez kolizji.
4. **Kaseta:** dno kasety 2,4 + piasta 4,6 = **7 mm** pod łbem; wkręt 12 mm wchodzi **5 mm** w sklejkę 6 mm. Piasty mają odstęp minimum: ESP **3,28**, PCA9685 **41,67**, ramka zasilania **14,70**, pierścień kondensatora **23,82 mm**. Dostęp do czterech wkrętów od góry przed założeniem płyty jest wolny.
5. **Niezmienność i druk:** lewa połówka identyczna z podanym 3MF — **392 identyczne trójkąty**. X1C: **244,8 × 112,8 × 39**; prawa połówka: **65,9 × 104,8 × 39**; kaseta: **170 × 100 × 25 mm**. Mieszczą się na wskazanych drukarkach, dnem na stole, bez podpór.
6. **Siatki:** wszystkie dziewięć 3MF szczelne, po jednej bryle, bez krawędzi nierozmaitościowych i degeneracji; cztery świeże eksporty szufladek/kasety zgodne geometrycznie z repo.

**BRZEGOWE:** pilot 22 mm daje zerowy zapas długości — wykonać 22 mm pełnej średnicy plus stożek wiertła; chwytu M4 w sklejce nie potwierdza sama geometria.  
**BRZEGOWE:** podgląd drewna rysuje blokadę Ø3,5 z łbem po niewłaściwej stronie; opis i otwór szufladki odpowiadają M4.  
Repo bez zmian, bez git; pliki robocze w katalogu tymczasowym, procesy kontrolne zakończone.

**Szufladkę `Szuflada (X1C).3mf` z blokadą M4 i kasetę można drukować.**
