senecjusz/Dynia-eyes/20-analizy/review/2026-10-25-podstawka-v2-brief.md

Jesteś recenzentem. Review modelu podstawki pod dynię po aktualizacji do stanu wykonanego (P7) i z blokadą szufladki (P5). Tylko pod kątem działania i druku. TYLKO DO ODCZYTU: bez zmian w repo, bez git; eksporty i skrypty tylko do katalogu tymczasowego. Po polsku, zwięźle.

Materiały:
- 20-analizy/2026-10-25-podstawka-model.md, ostatnia sekcja „Model zaktualizowany do stanu wykonanego (P7) i blokada szufladki (P5) – aktualne” (wcześniejsze sekcje to historia);
- 30-projekt/PRD.md §5 (stan wykonany 25.10, blokada szufladki śrubą), §8; AGENTS.md (DFAM, luzy, śruby/wkręty);
- model: 40-cad/openscad/podstawka.scad (zmienne tDno, H_IN, dOtwPl, wkrPlOd, blokL, xBlok, wkrDnoL, wkrDnoZapas, kPiastaD, kPiastaOd, kPiastaH; moduły szuflada(), kaseta(), plyta(), dno(), zlozenie(), rysunekCiecia()); podstawka-drewno.scad; OpenSCAD 2021.01: "C:/Program Files/OpenSCAD/openscad.com";
- siatki: 40-cad/3mf/Podstawka v1/*.3mf (lewa połówka szufladki już wydrukowana – musi zostać bez zmian); narzędzia 40-cad/narzedzia/;
- rysunki: 40-cad/openscad/podglad/podstawka-ciecie.png, podstawka-drewno.png.

Stan wykonany (fakt): dno 6 mm sklejone ze ściankami 40 mm, płyta górna 18 z otworem Ø60 przykręcana na końcu 4 wkrętami w dół; elektronika mocowana do dna.

Sprawdź liczbowo:
1. Zgodność modelu i rysunków ze stanem wykonanym.
2. Szufladka na dnie: luzy, powerbank pod płytą, wysunięcie do przodu, brak kolizji (dno, ścianki, płyta, kaseta).
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
