senecjusz/Dynia-eyes/20-analizy/2026-10-17-mechanizm-oka/img/arduino_eyes_s4_Prepping_and_Mounting_Eyeballs.jpg

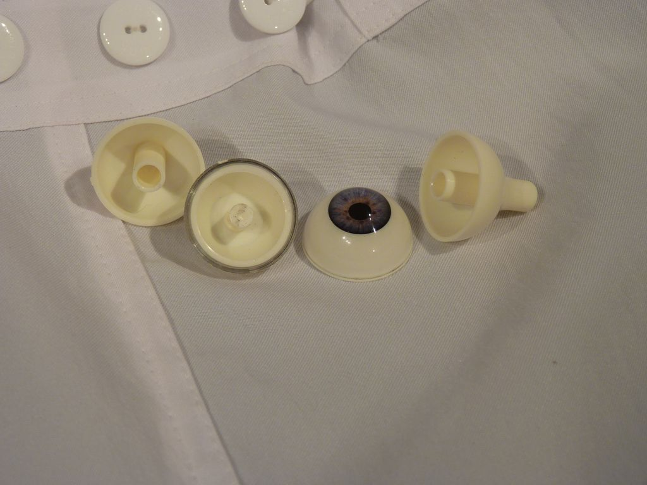
20-analizy/2026-10-17-mechanizm-oka/img/arduino_eyes_s4_Prepping_and_Mounting_Eyeballs.jpg
