senecjusz/Dynia-eyes/20-analizy/2026-10-17-mechanizm-oka/img/cogley_v2_as1.png

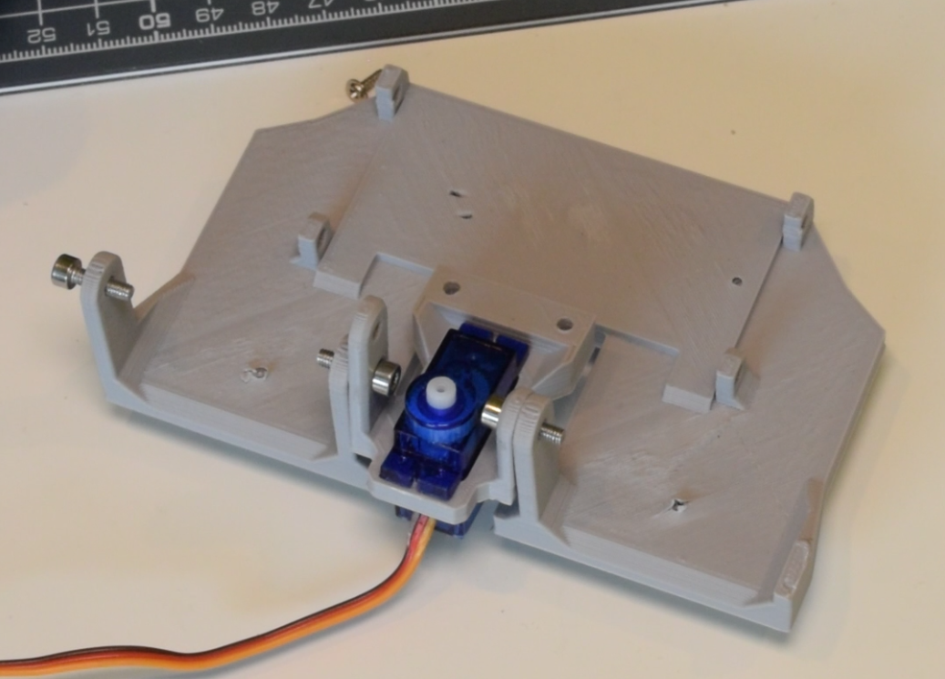
20-analizy/2026-10-17-mechanizm-oka/img/cogley_v2_as1.png
