senecjusz/Dynia-eyes/20-analizy/2026-10-17-mechanizm-oka/img/cogley_v4_vid_044.jpg

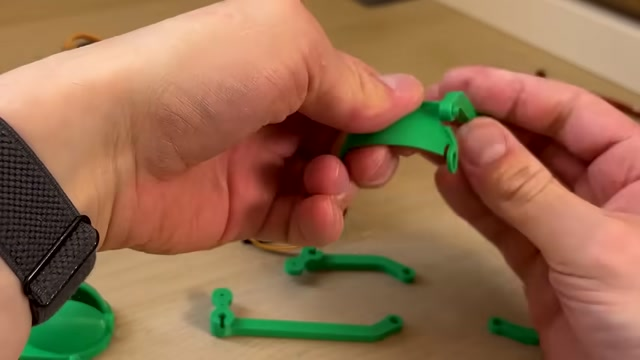
20-analizy/2026-10-17-mechanizm-oka/img/cogley_v4_vid_044.jpg
