senecjusz/Dynia-eyes/20-analizy/2026-10-17-mechanizm-oka/img/grid_cats_menagerie_02.jpg

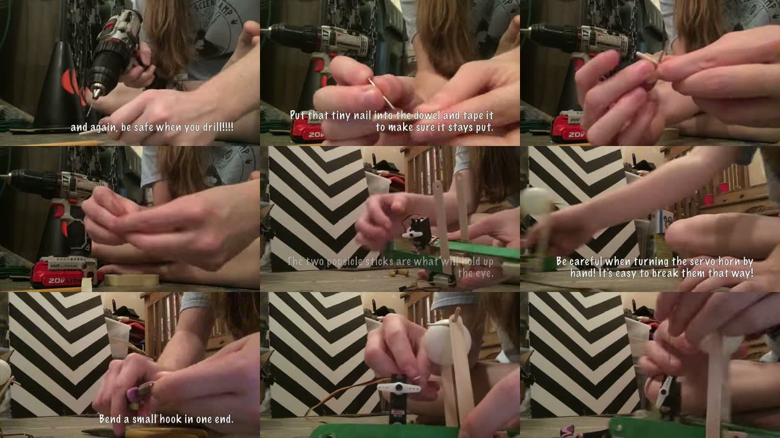
20-analizy/2026-10-17-mechanizm-oka/img/grid_cats_menagerie_02.jpg
