senecjusz/Dynia-eyes/20-analizy/2026-10-17-mechanizm-oka/img/grid_cats_menagerie_03.jpg

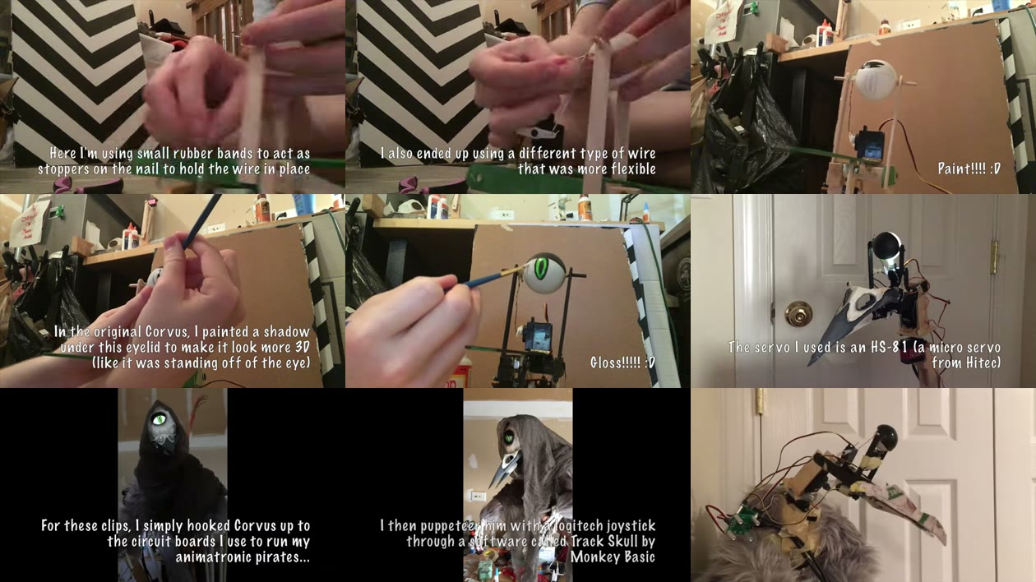
20-analizy/2026-10-17-mechanizm-oka/img/grid_cats_menagerie_03.jpg
