senecjusz/Dynia-eyes/20-analizy/2026-10-17-mechanizm-oka/img/kosmo_flexure_link_top.jpg

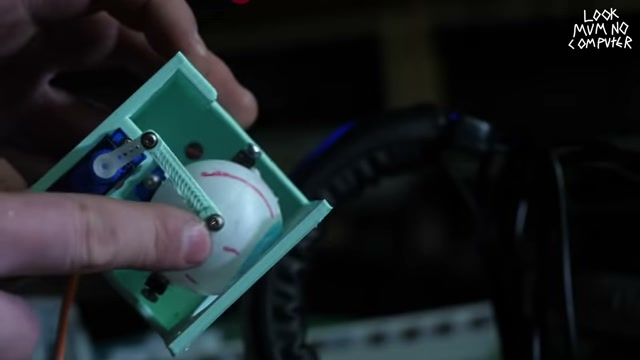
20-analizy/2026-10-17-mechanizm-oka/img/kosmo_flexure_link_top.jpg
