senecjusz/Dynia-eyes/20-analizy/2026-10-17-mechanizm-oka/img/paulsbots_00_08_15.jpg

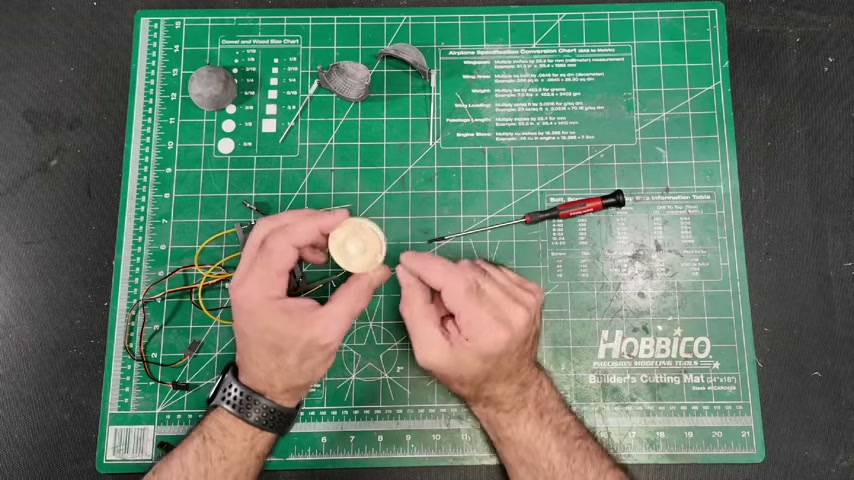
20-analizy/2026-10-17-mechanizm-oka/img/paulsbots_00_08_15.jpg
