senecjusz/Dynia-eyes/20-analizy/2026-10-17-mechanizm-oka/img/polymaker_tut_00_03_15.jpg

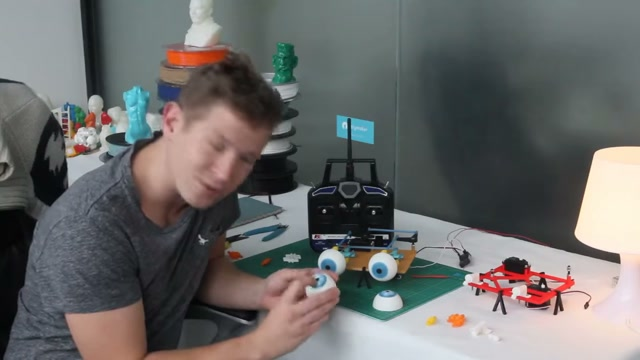
20-analizy/2026-10-17-mechanizm-oka/img/polymaker_tut_00_03_15.jpg
