senecjusz/Dynia-eyes/20-analizy/2026-10-17-mechanizm-oka/img/polymaker_tut_00_08_55.jpg

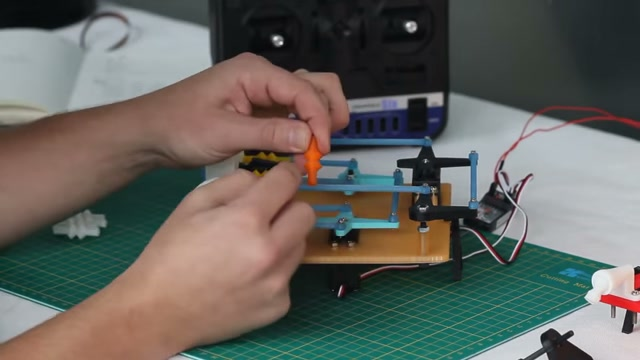
20-analizy/2026-10-17-mechanizm-oka/img/polymaker_tut_00_08_55.jpg
