senecjusz/Dynia-eyes/20-analizy/2026-10-17-mechanizm-oka/img/pyro_img_5_robotic_eyes.jpg

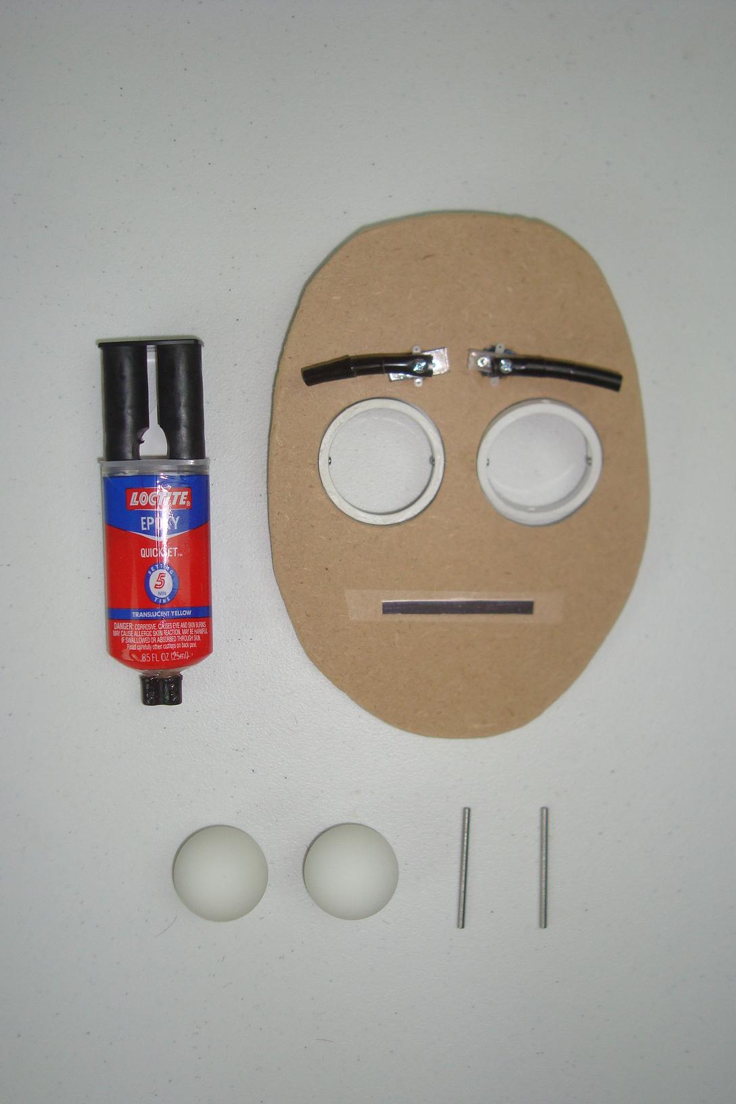
20-analizy/2026-10-17-mechanizm-oka/img/pyro_img_5_robotic_eyes.jpg
