senecjusz/Dynia-eyes/20-analizy/2026-10-17-mechanizm-oka/img/stanwinston_00_03_38.jpg

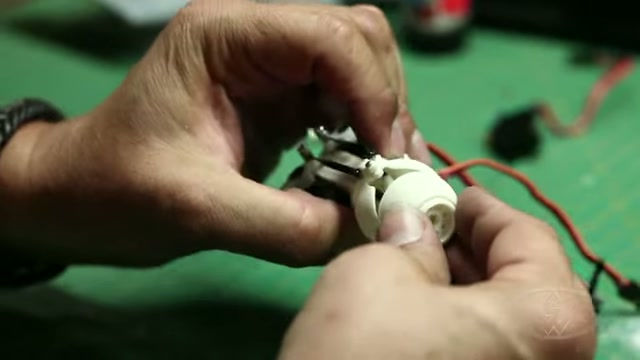
20-analizy/2026-10-17-mechanizm-oka/img/stanwinston_00_03_38.jpg
