senecjusz/Dynia-eyes/20-analizy/2026-10-17-mechanizm-oka/img/yt_fufVeOHFu5Q_f06.jpg

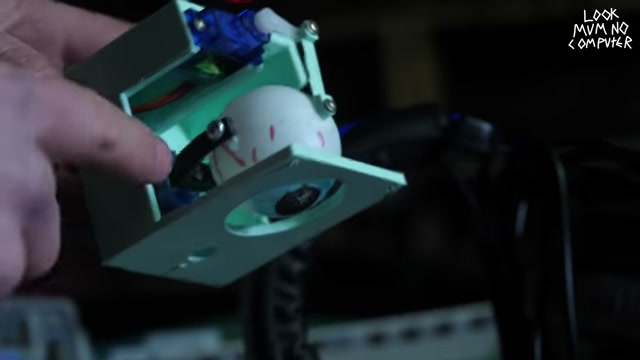
20-analizy/2026-10-17-mechanizm-oka/img/yt_fufVeOHFu5Q_f06.jpg
