senecjusz/Dynia-eyes/20-analizy/2026-10-17-mechanizm-oka/img/yt_gDrjgVRJONA_f13.jpg

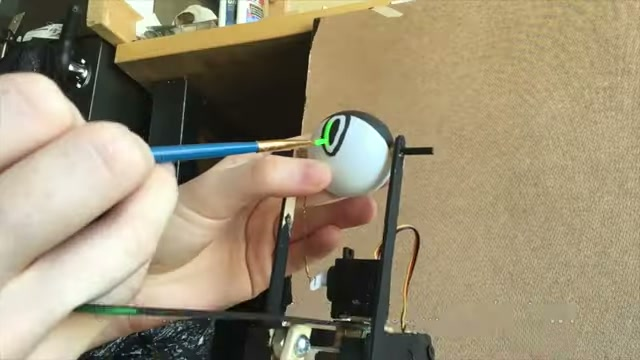
20-analizy/2026-10-17-mechanizm-oka/img/yt_gDrjgVRJONA_f13.jpg
