senecjusz/Dynia-eyes/20-analizy/2026-10-25-podstawka-render/1-wymiana-powerbanku.png

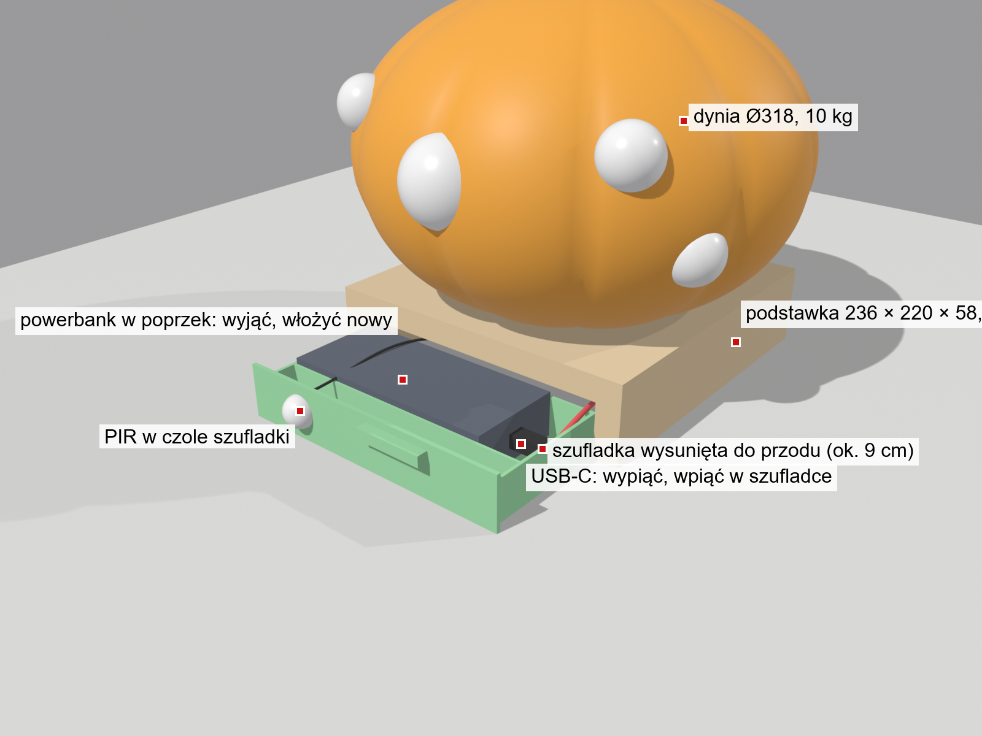
20-analizy/2026-10-25-podstawka-render/1-wymiana-powerbanku.png
