senecjusz/Dynia-eyes/20-analizy/2026-10-25-podstawka-render/2-przeswietlenie.png

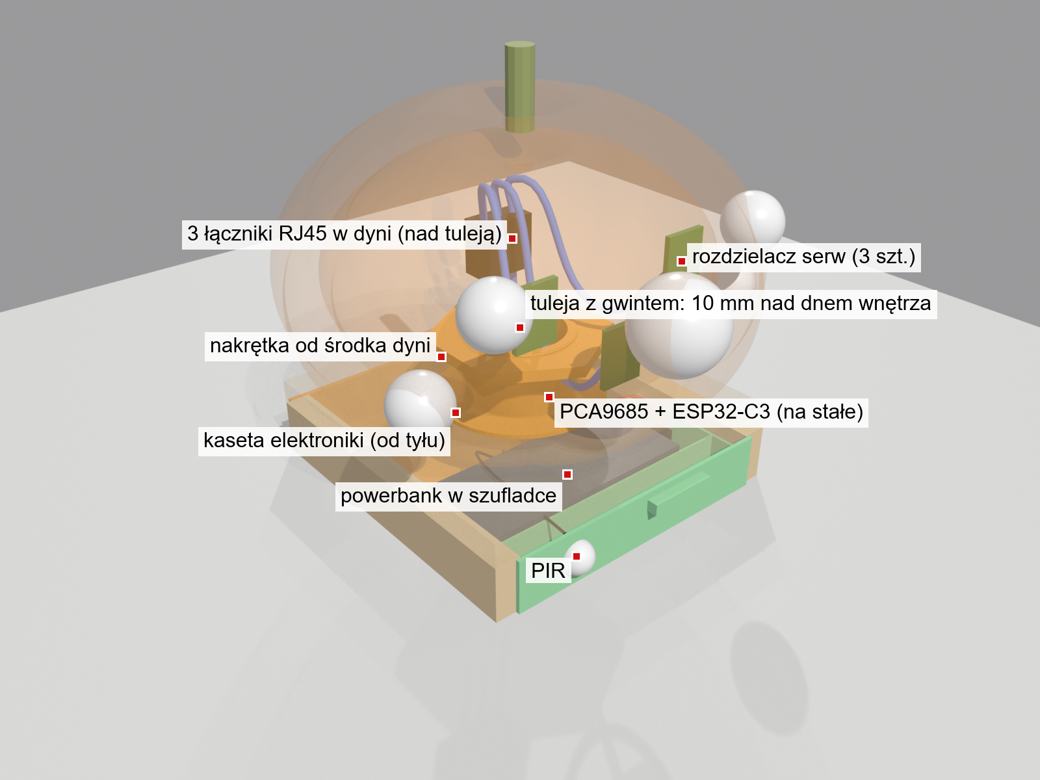
20-analizy/2026-10-25-podstawka-render/2-przeswietlenie.png
