senecjusz/Dynia-eyes/20-analizy/2026-10-25-podstawka-render/4-przod.png

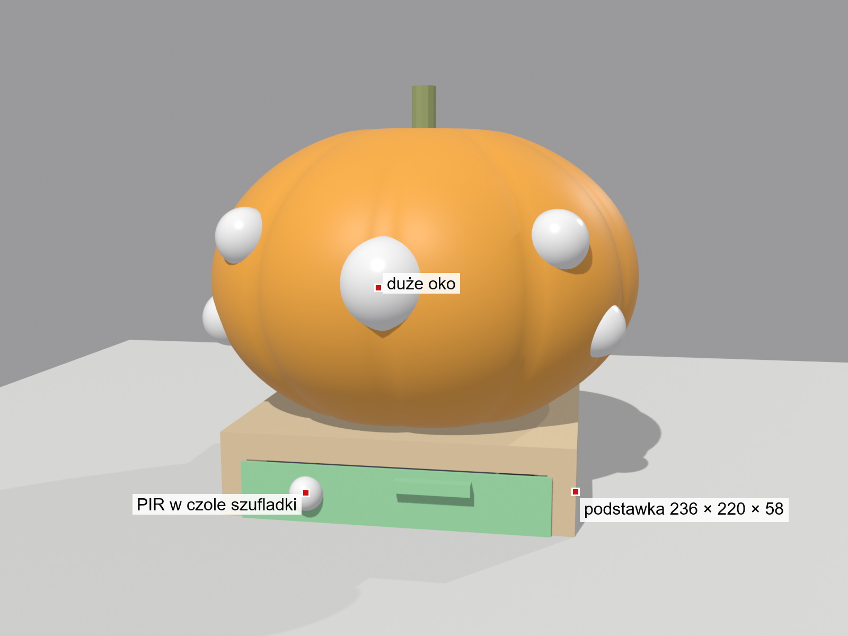
20-analizy/2026-10-25-podstawka-render/4-przod.png
