senecjusz/Dynia-eyes/40-cad/druty/powieki-v3-wariant-A.png

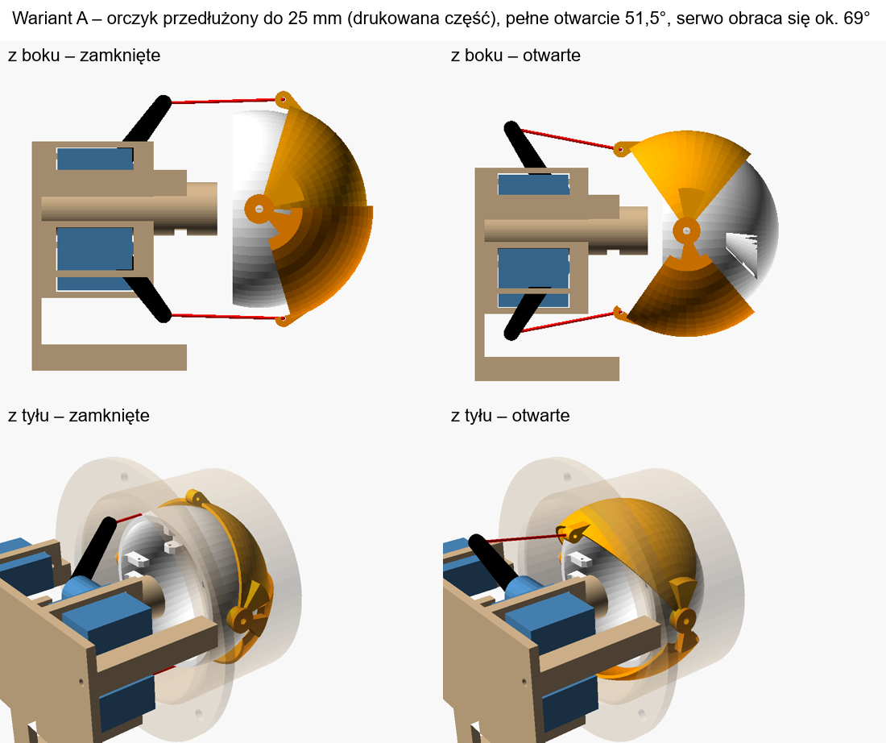
40-cad/druty/powieki-v3-wariant-A.png
