senecjusz/Dynia-eyes/40-cad/druty/powieki-v3-wariant-B.png

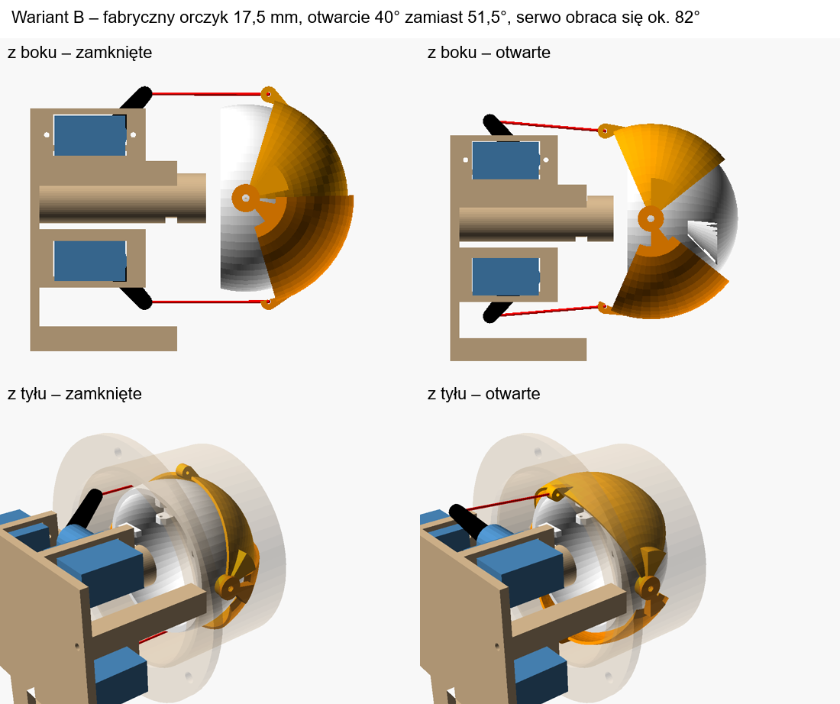
40-cad/druty/powieki-v3-wariant-B.png
