senecjusz/Dynia-eyes/40-cad/onshape/e6.2-zrzuty/e6.3-plyta-od-spodu.jpg

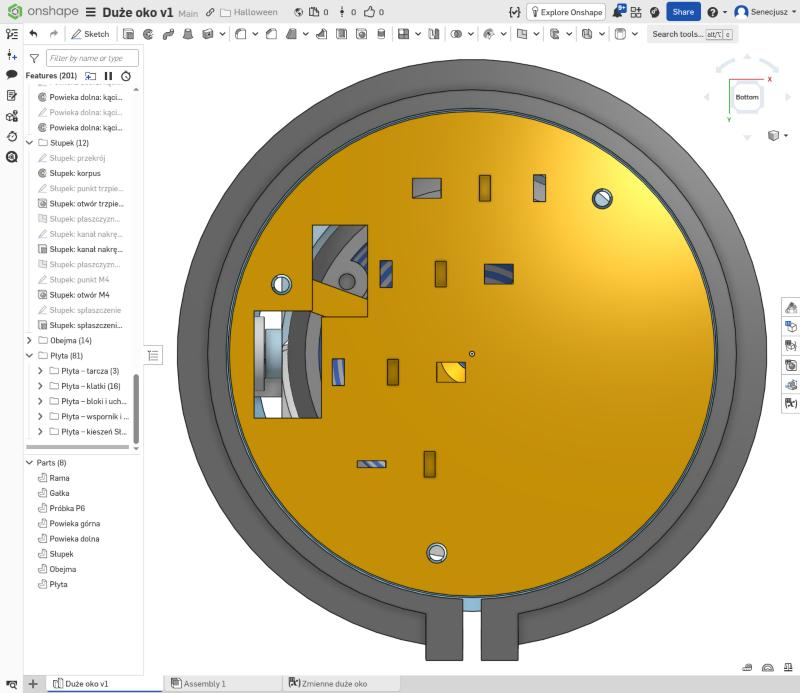
40-cad/onshape/e6.2-zrzuty/e6.3-plyta-od-spodu.jpg
