senecjusz/Dynia-eyes/40-cad/onshape/e6.2-zrzuty/e6.3-rama-galka-od-tylu.jpg

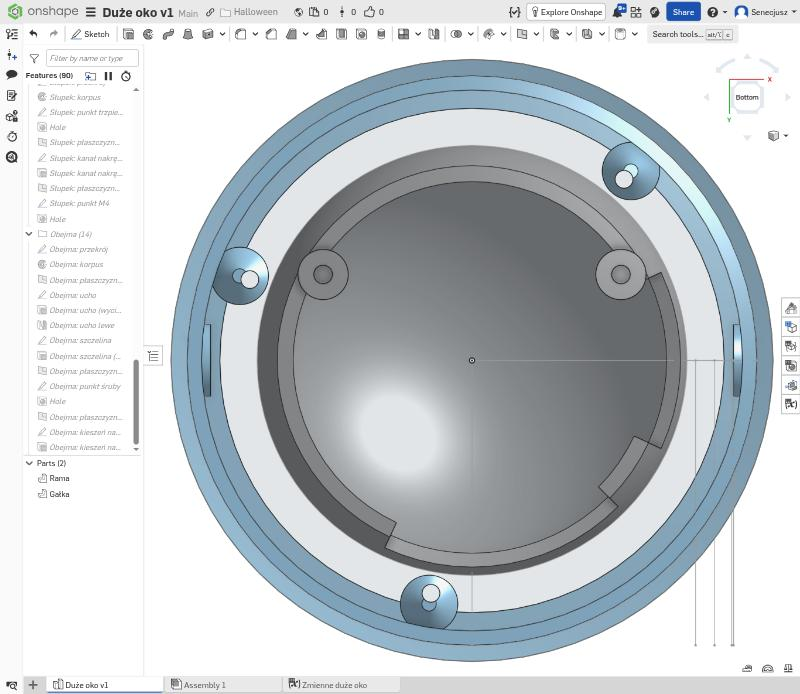
40-cad/onshape/e6.2-zrzuty/e6.3-rama-galka-od-tylu.jpg
