senecjusz/Dynia-eyes/40-cad/onshape/e6.2-zrzuty/galka-p6.jpg

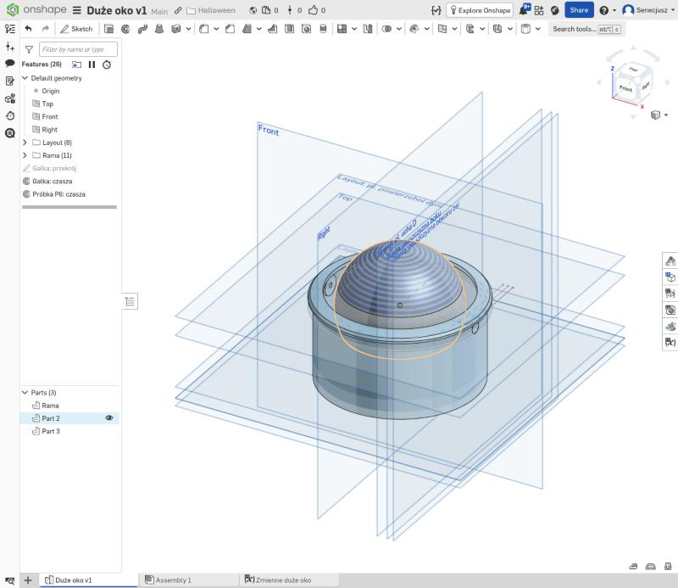
40-cad/onshape/e6.2-zrzuty/galka-p6.jpg
