senecjusz/Dynia-eyes/40-cad/onshape/e6.2-zrzuty/obejma.jpg

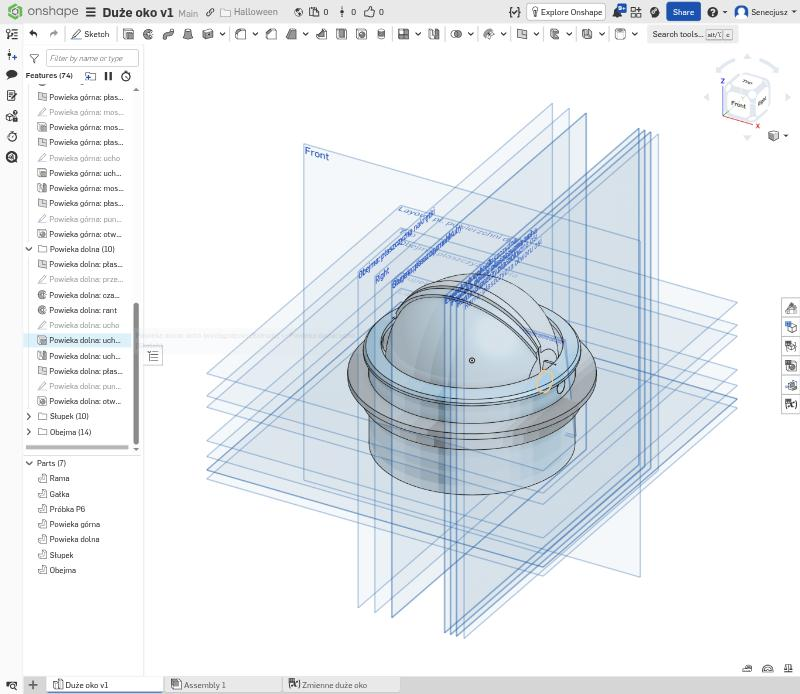
40-cad/onshape/e6.2-zrzuty/obejma.jpg
