senecjusz/Dynia-eyes/40-cad/onshape/e6.6-zrzuty/p4-po-budowie.jpg

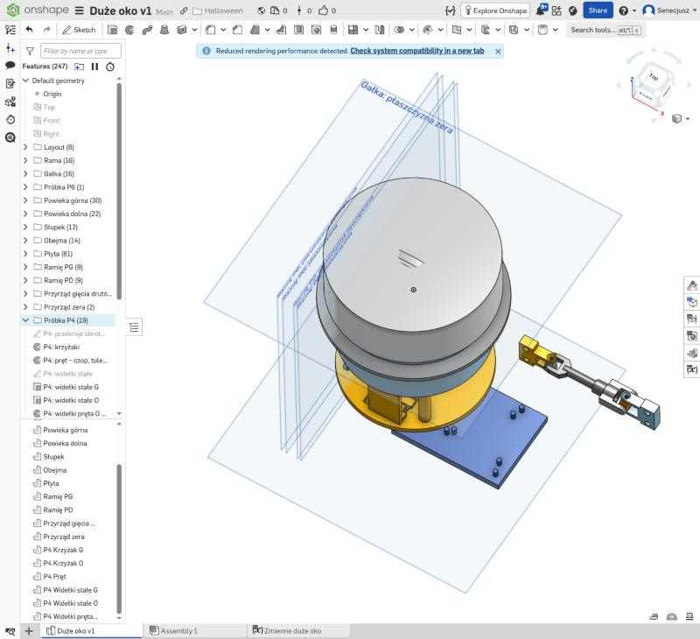
40-cad/onshape/e6.6-zrzuty/p4-po-budowie.jpg
