senecjusz/Dynia-eyes/40-cad/openscad/podglad/bok.png

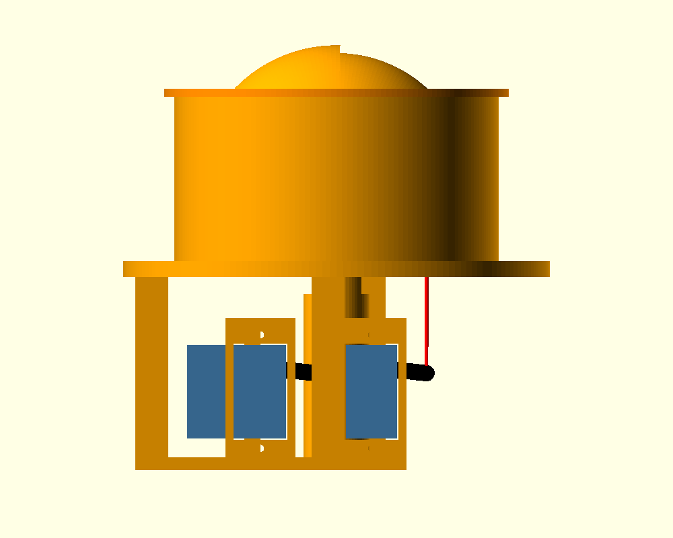
40-cad/openscad/podglad/bok.png
