senecjusz/Dynia-eyes/40-cad/openscad/podglad/druk_Galka.png

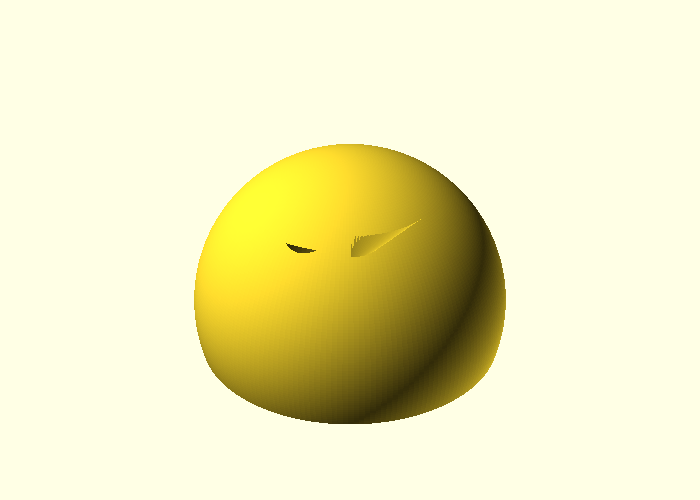
40-cad/openscad/podglad/druk_Galka.png
