senecjusz/Dynia-eyes/40-cad/openscad/podglad/druk_Pierscien.png

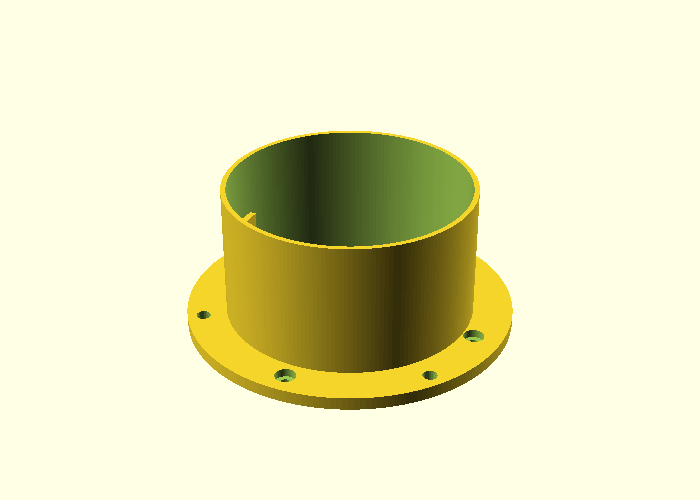
40-cad/openscad/podglad/druk_Pierscien.png
