senecjusz/Dynia-eyes/40-cad/openscad/podglad/druk_PowiekaDolna.png

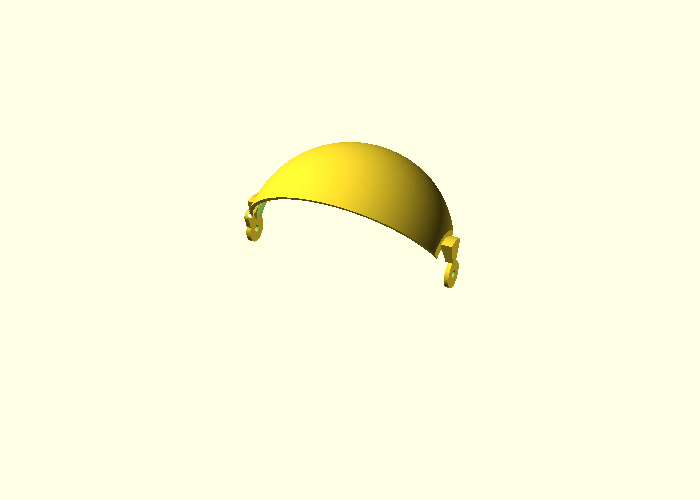
40-cad/openscad/podglad/druk_PowiekaDolna.png
