senecjusz/Dynia-eyes/40-cad/openscad/podglad/druk_PowiekaGorna.png

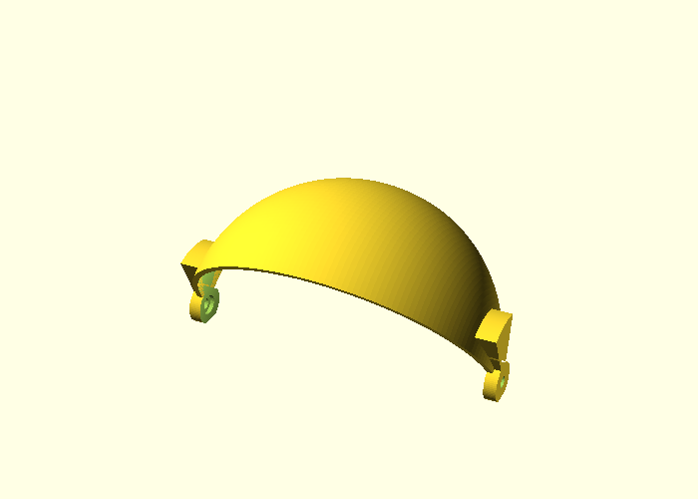
40-cad/openscad/podglad/druk_PowiekaGorna.png
