senecjusz/Dynia-eyes/40-cad/openscad/podglad/druk_ProbkaDrutu.png

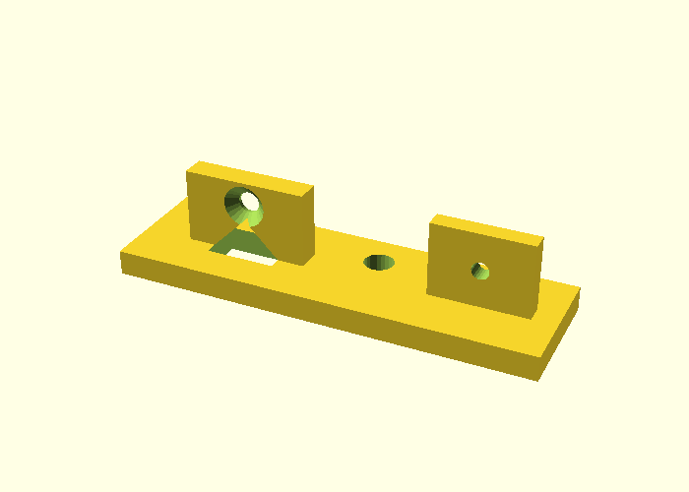
40-cad/openscad/podglad/druk_ProbkaDrutu.png
