senecjusz/Dynia-eyes/40-cad/openscad/podglad/druk_UchwytSerw.png

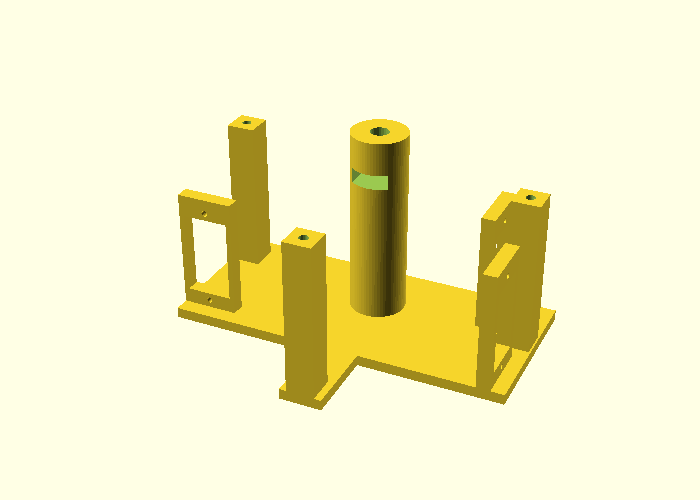
40-cad/openscad/podglad/druk_UchwytSerw.png
