senecjusz/Dynia-eyes/40-cad/openscad/podglad/duze-oko-v3/kardan-gora-dol.png

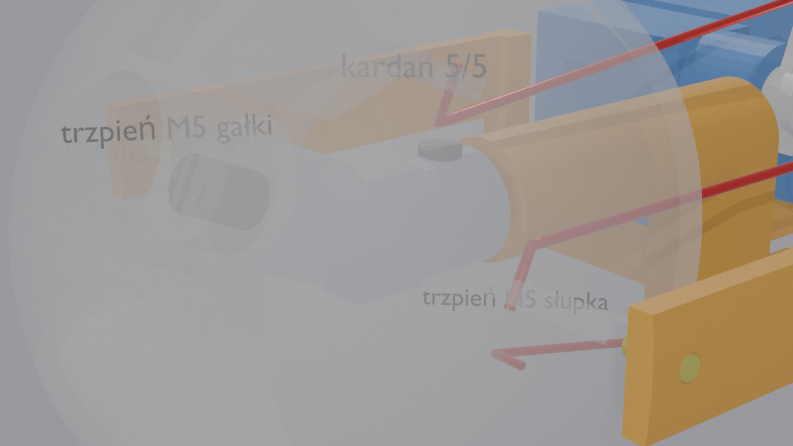
40-cad/openscad/podglad/duze-oko-v3/kardan-gora-dol.png
