senecjusz/Dynia-eyes/40-cad/openscad/podglad/duze-oko-v3/kardan-lewo-prawo.png

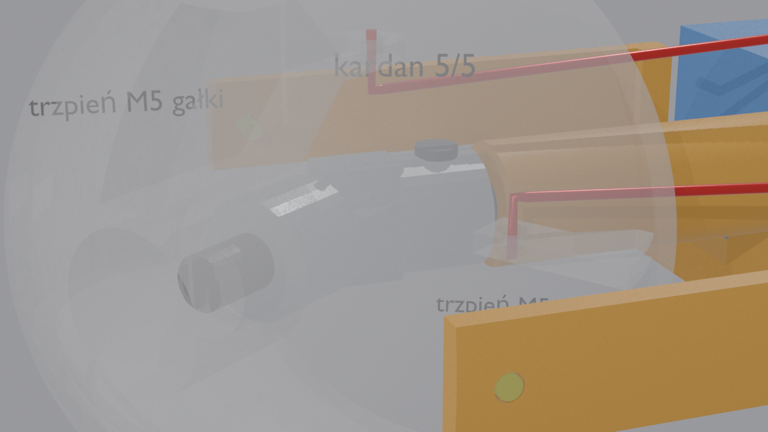
40-cad/openscad/podglad/duze-oko-v3/kardan-lewo-prawo.png
