senecjusz/Dynia-eyes/40-cad/openscad/podglad/duze-oko-v3/montaz/krok1.jpg

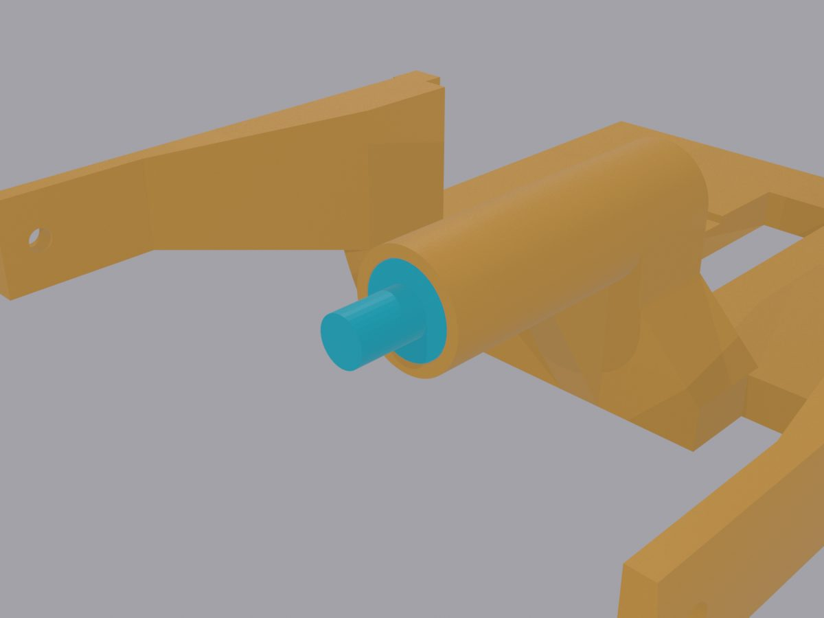
40-cad/openscad/podglad/duze-oko-v3/montaz/krok1.jpg
