senecjusz/Dynia-eyes/40-cad/openscad/podglad/duze-oko-v3/montaz/krok3.jpg

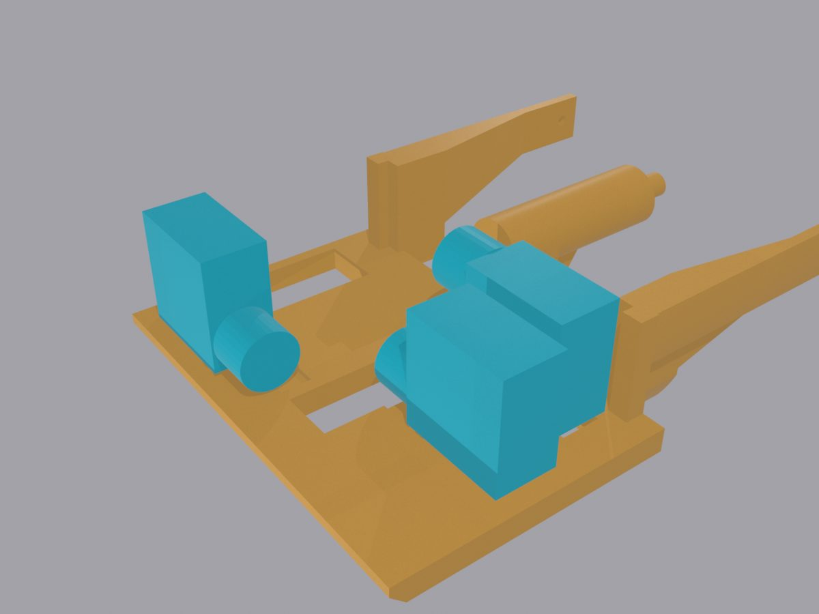
40-cad/openscad/podglad/duze-oko-v3/montaz/krok3.jpg
