senecjusz/Dynia-eyes/40-cad/openscad/podglad/duze-oko-v3/montaz/krok5.jpg

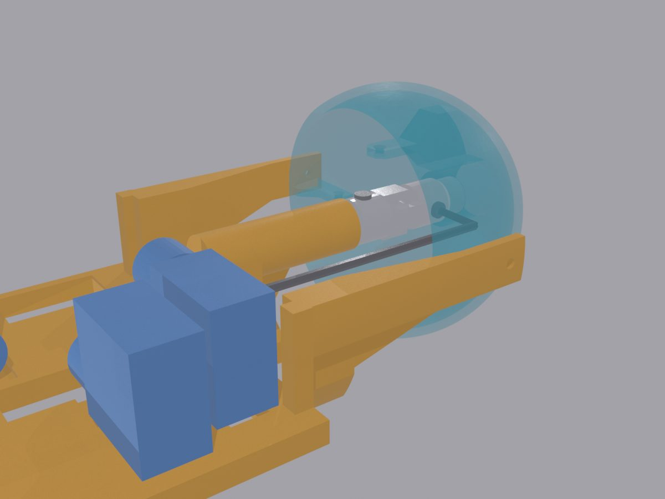
40-cad/openscad/podglad/duze-oko-v3/montaz/krok5.jpg
