senecjusz/Dynia-eyes/40-cad/openscad/podglad/duze-oko-v3/montaz/krok7.jpg

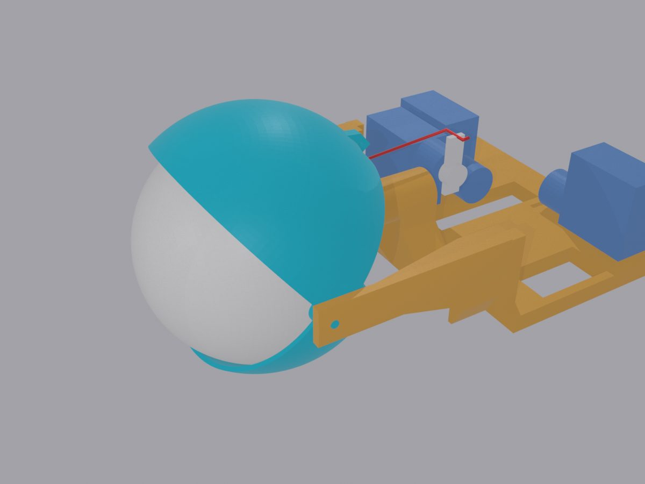
40-cad/openscad/podglad/duze-oko-v3/montaz/krok7.jpg
