senecjusz/Dynia-eyes/40-cad/openscad/podglad/duze-oko-v3/montaz/krok8-uszko.jpg

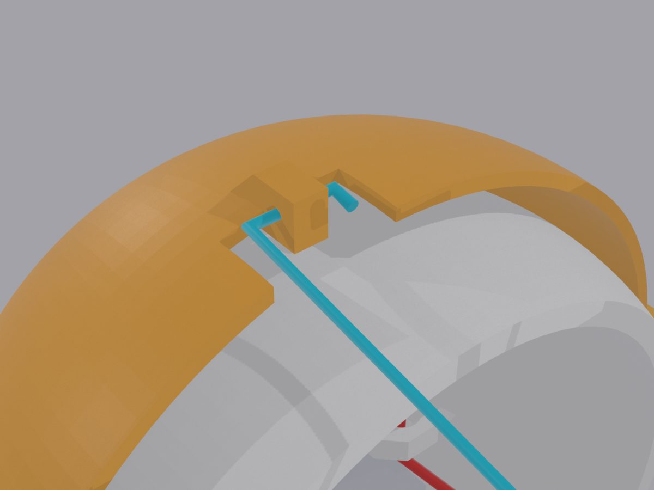
40-cad/openscad/podglad/duze-oko-v3/montaz/krok8-uszko.jpg
