senecjusz/Dynia-eyes/40-cad/openscad/podglad/duze-oko-v3/montaz/krok9.jpg

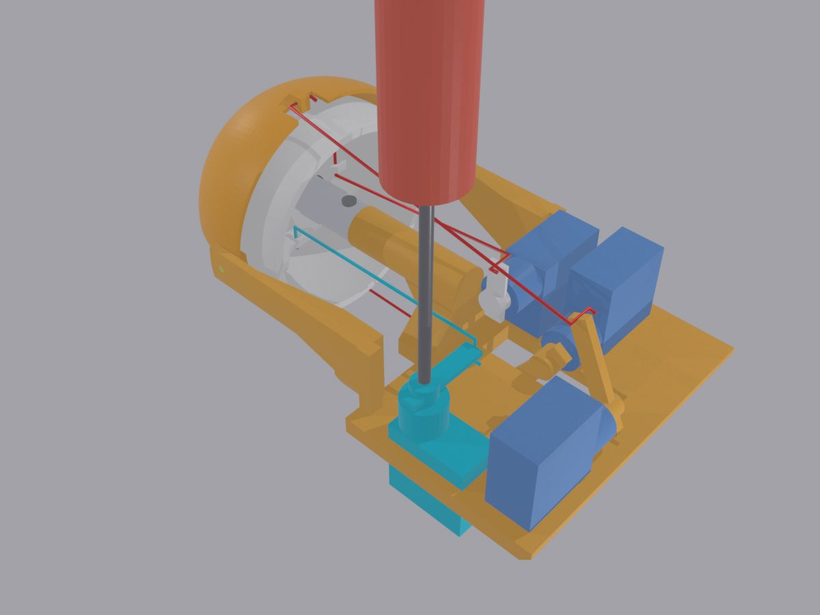
40-cad/openscad/podglad/duze-oko-v3/montaz/krok9.jpg
