senecjusz/Dynia-eyes/40-cad/openscad/podglad/duze-oko-v3/montaz/plyta-wneki-kabli.png

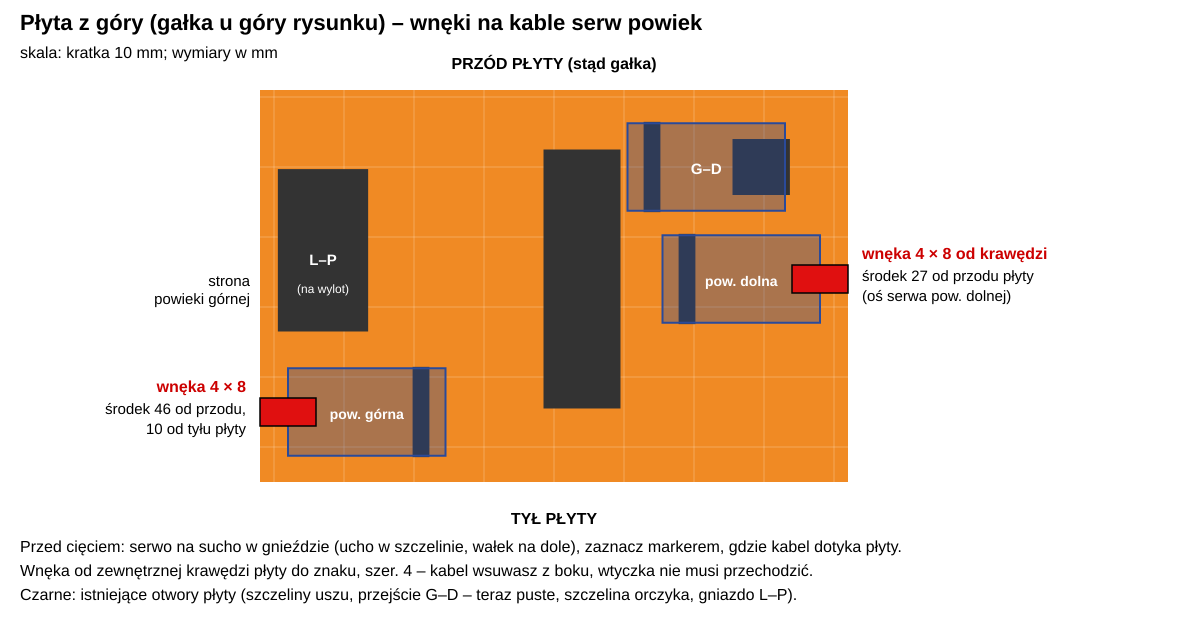
40-cad/openscad/podglad/duze-oko-v3/montaz/plyta-wneki-kabli.png
