senecjusz/Dynia-eyes/40-cad/openscad/podglad/duze-oko-v3/montaz/podparcie-od-srodka-dyni.jpg

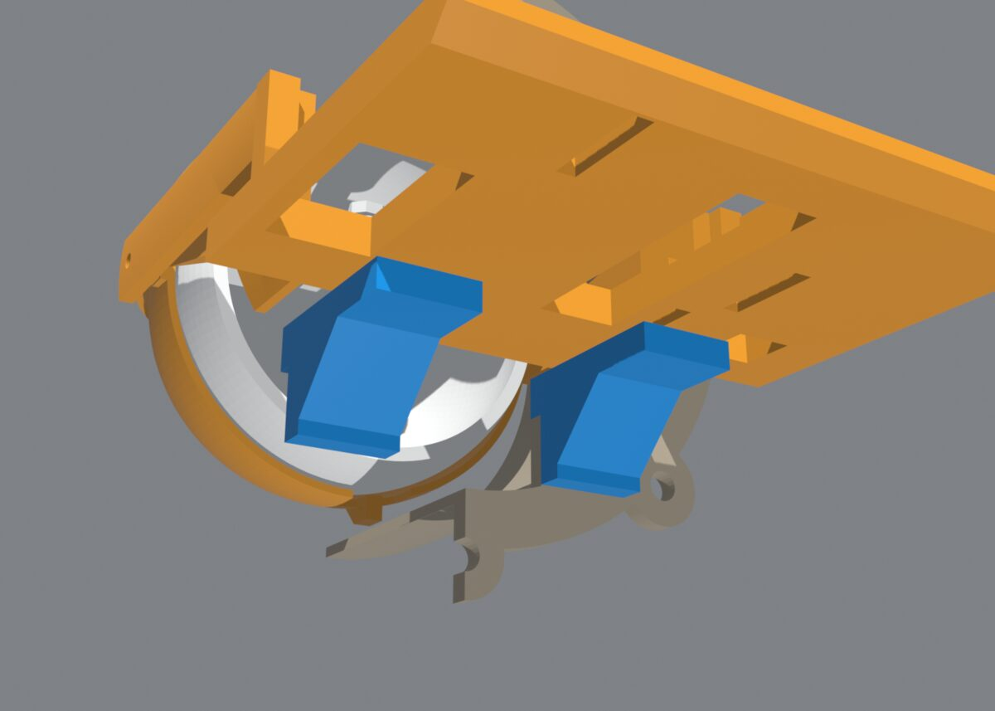
40-cad/openscad/podglad/duze-oko-v3/montaz/podparcie-od-srodka-dyni.jpg
