senecjusz/Dynia-eyes/40-cad/openscad/podglad/duze-oko-v3/montaz/podparcie-z-boku.jpg

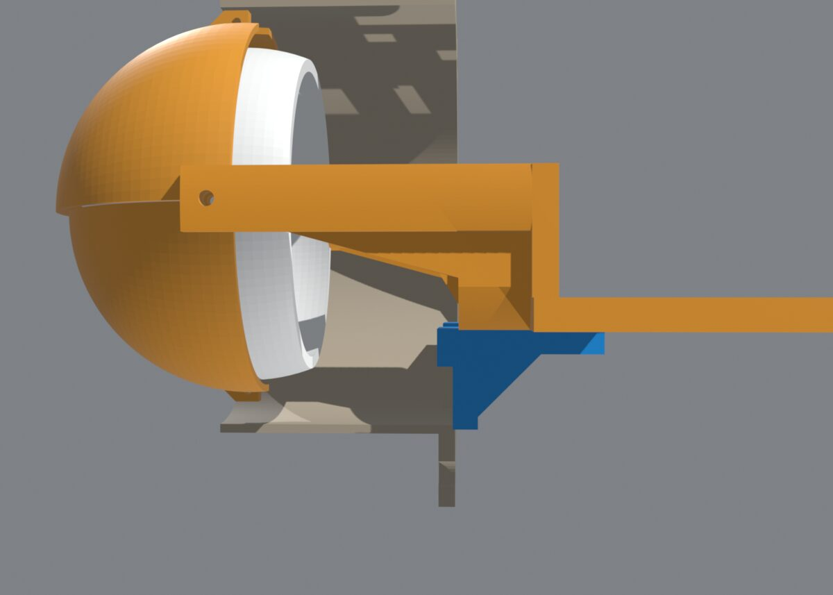
40-cad/openscad/podglad/duze-oko-v3/montaz/podparcie-z-boku.jpg
