senecjusz/Dynia-eyes/40-cad/openscad/podglad/duze-oko-v3/montaz/podparcie-z-dolu.jpg

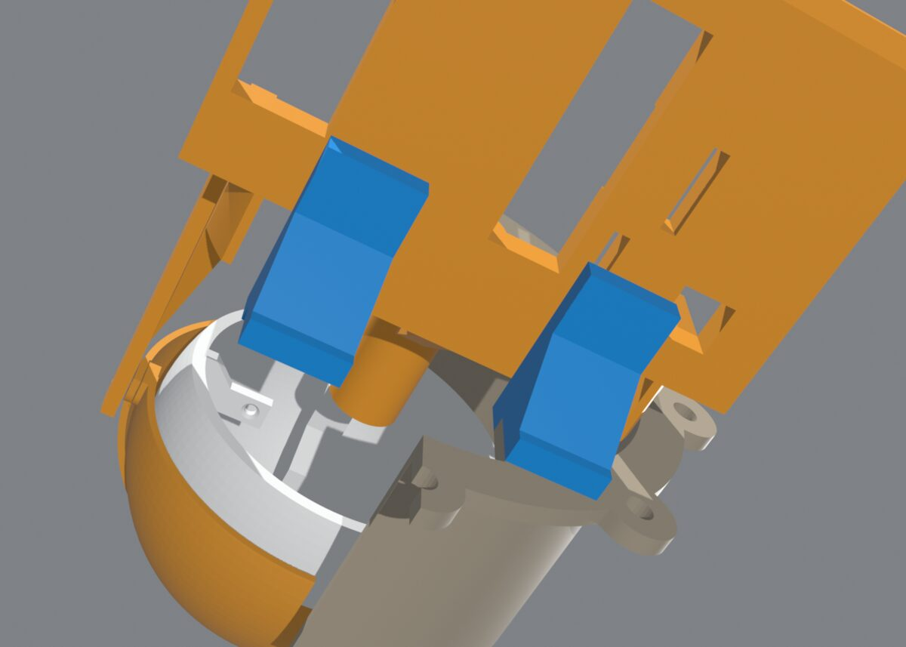
40-cad/openscad/podglad/duze-oko-v3/montaz/podparcie-z-dolu.jpg
