senecjusz/Dynia-eyes/40-cad/openscad/podglad/duze-oko-v3/montaz/trzpien-kardana.png

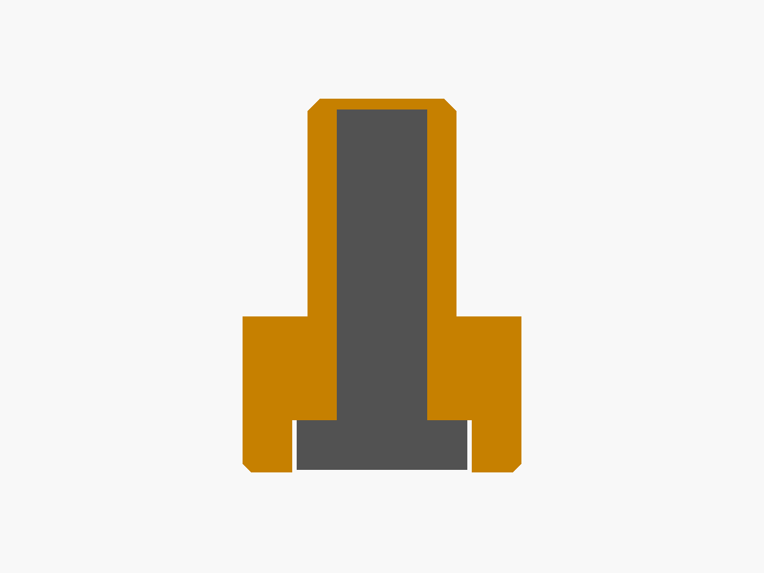
40-cad/openscad/podglad/duze-oko-v3/montaz/trzpien-kardana.png
