senecjusz/Dynia-eyes/40-cad/openscad/podglad/duze-oko-v3/montaz/zawias-przekroj.png

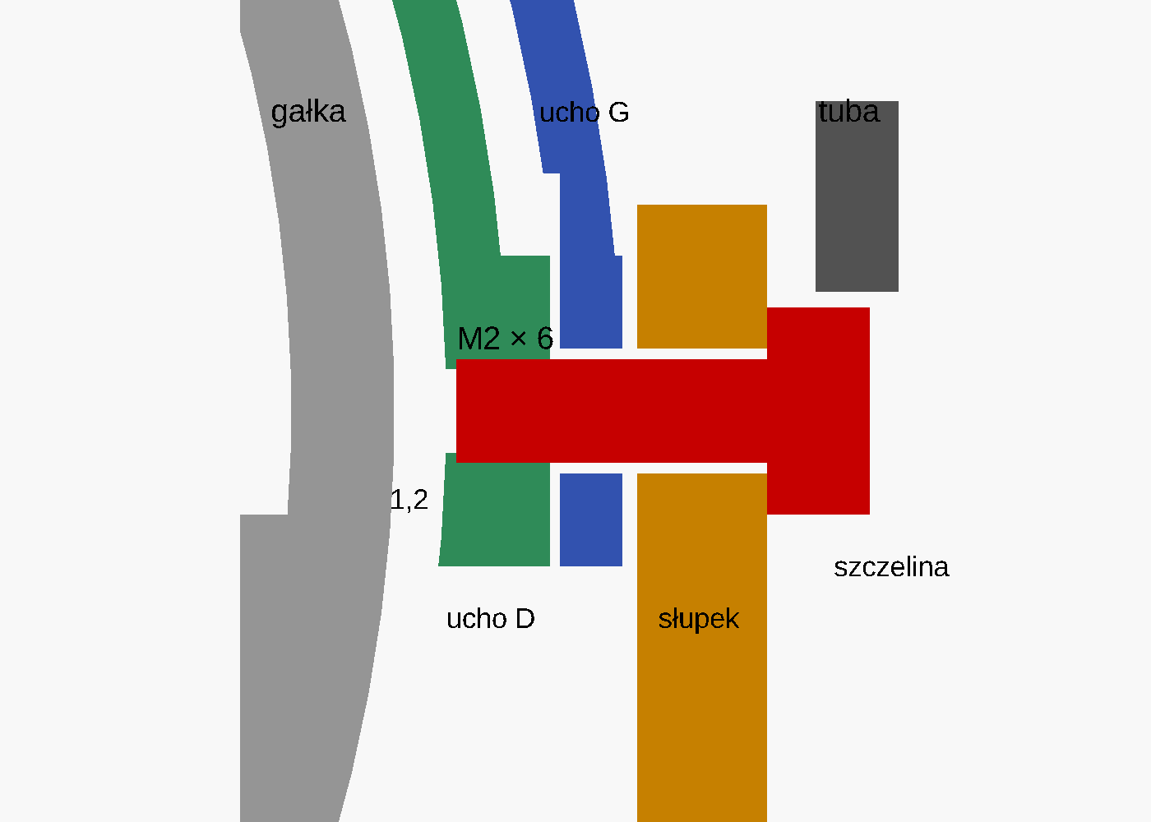
40-cad/openscad/podglad/duze-oko-v3/montaz/zawias-przekroj.png
