senecjusz/Dynia-eyes/40-cad/openscad/podglad/duze-oko-v3/ogolny-gora.png

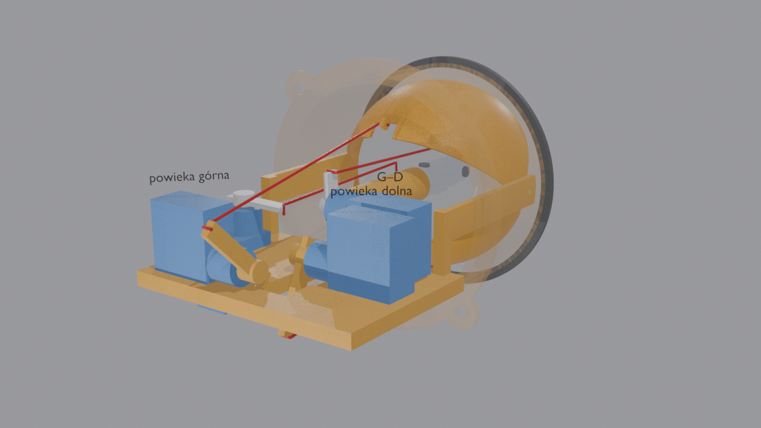
40-cad/openscad/podglad/duze-oko-v3/ogolny-gora.png
