senecjusz/Dynia-eyes/40-cad/openscad/podglad/duze-oko-v3/ogolny-zamkniete.png

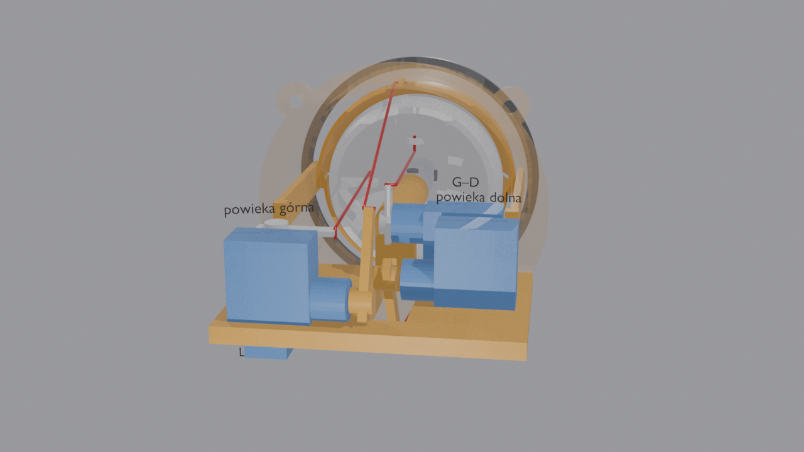
40-cad/openscad/podglad/duze-oko-v3/ogolny-zamkniete.png
