senecjusz/Dynia-eyes/40-cad/openscad/podglad/duze-oko-v3/prety-gora-dol.png

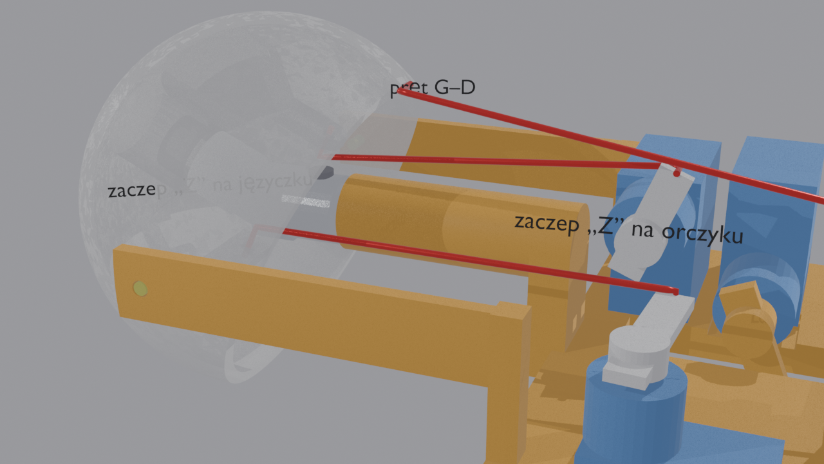
40-cad/openscad/podglad/duze-oko-v3/prety-gora-dol.png
