senecjusz/Dynia-eyes/40-cad/openscad/podglad/duze-oko-v3/prety-lewo-prawo.png

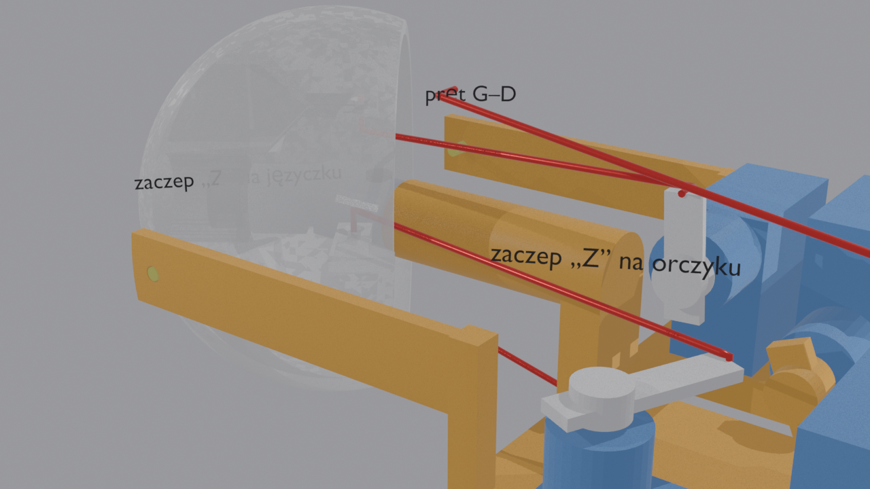
40-cad/openscad/podglad/duze-oko-v3/prety-lewo-prawo.png
