senecjusz/Dynia-eyes/40-cad/openscad/podglad/duze-oko-v3/uszko-powieki-gornej.png

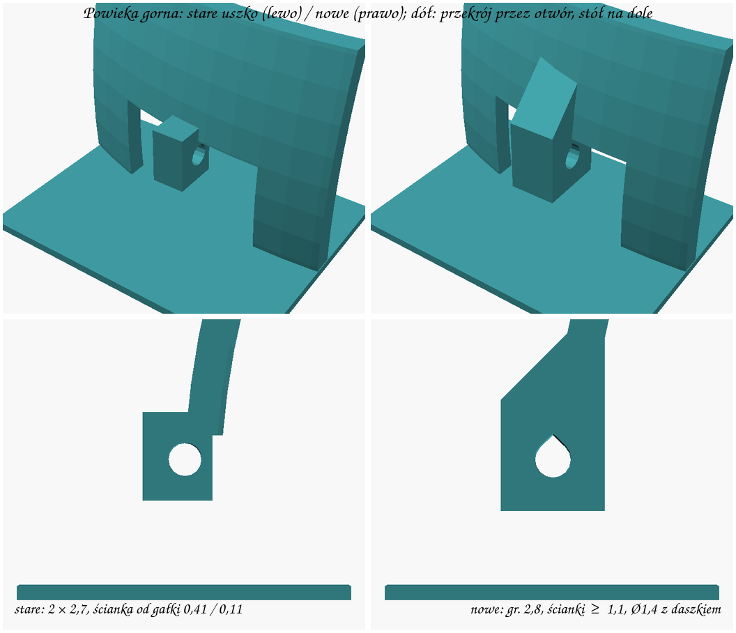
40-cad/openscad/podglad/duze-oko-v3/uszko-powieki-gornej.png
