senecjusz/Dynia-eyes/40-cad/openscad/podglad/duze-oko-v3/zawiasy-dolna-zamknieta.png

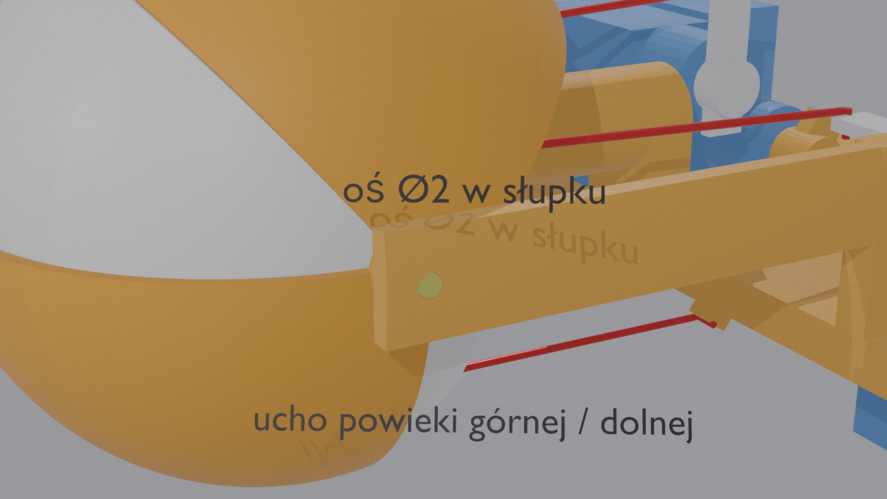
40-cad/openscad/podglad/duze-oko-v3/zawiasy-dolna-zamknieta.png
