senecjusz/Dynia-eyes/40-cad/openscad/podglad/duze-oko-v3/zawiasy-gorna-zamknieta.png

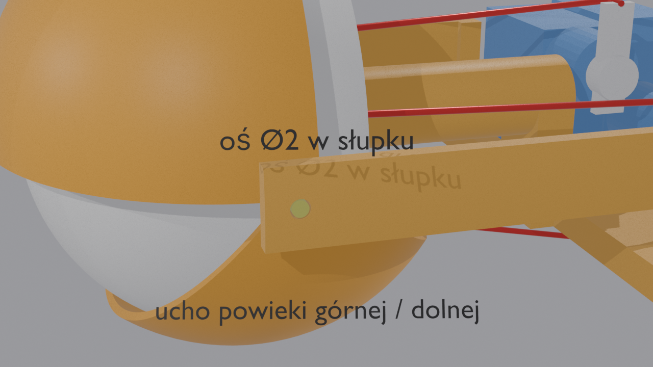
40-cad/openscad/podglad/duze-oko-v3/zawiasy-gorna-zamknieta.png
