senecjusz/Dynia-eyes/40-cad/openscad/podglad/galka_ucha.png

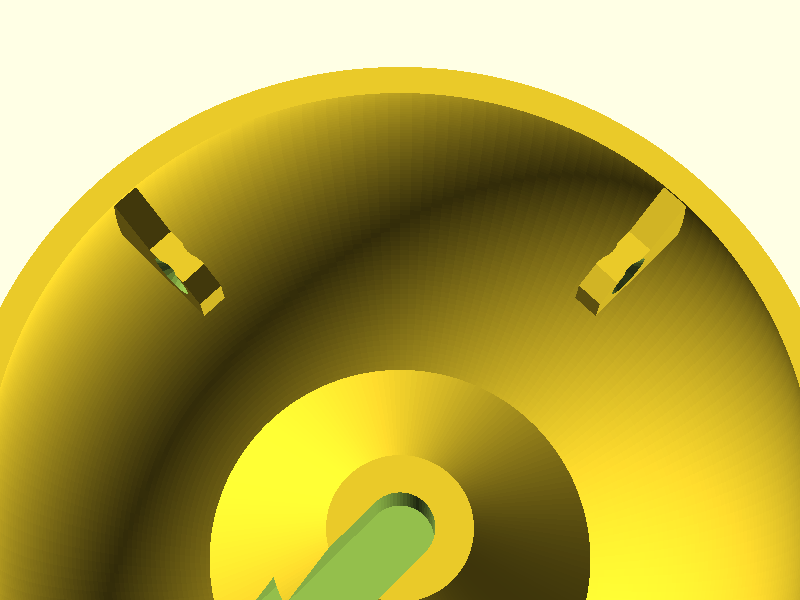
40-cad/openscad/podglad/galka_ucha.png
