senecjusz/Dynia-eyes/40-cad/openscad/podglad/podstawka-ciecie.png

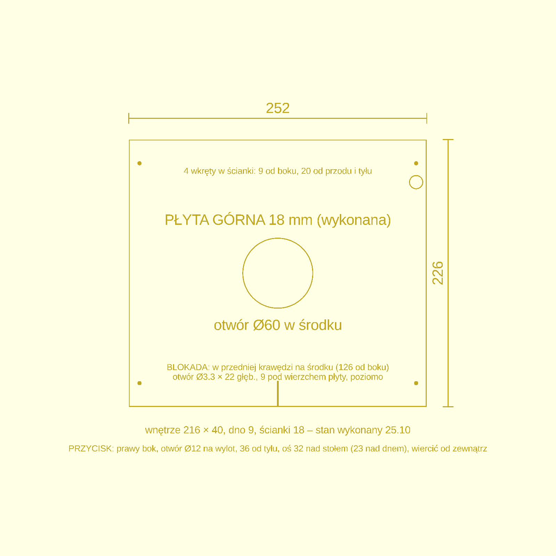
40-cad/openscad/podglad/podstawka-ciecie.png
