senecjusz/Dynia-eyes/40-cad/openscad/podglad/podstawka-drewno.png

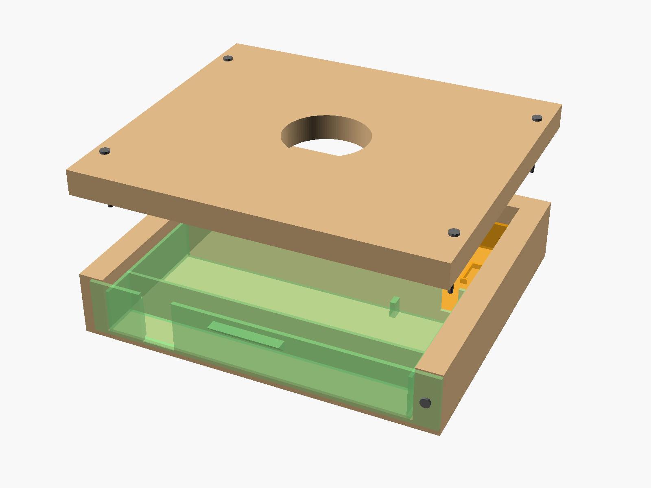
40-cad/openscad/podglad/podstawka-drewno.png
