senecjusz/Dynia-eyes/40-cad/openscad/podglad/podstawka-Kaseta.png

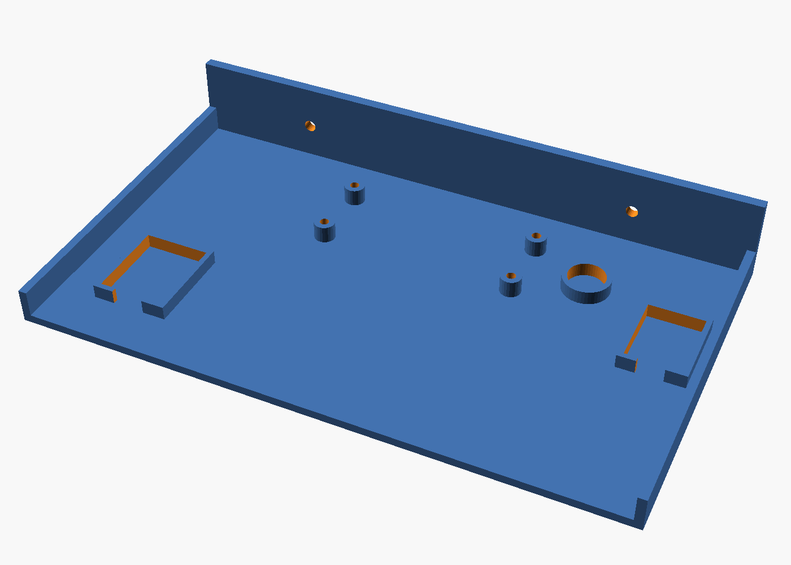
40-cad/openscad/podglad/podstawka-Kaseta.png
