senecjusz/Dynia-eyes/40-cad/openscad/podglad/podstawka-Nakretka.png

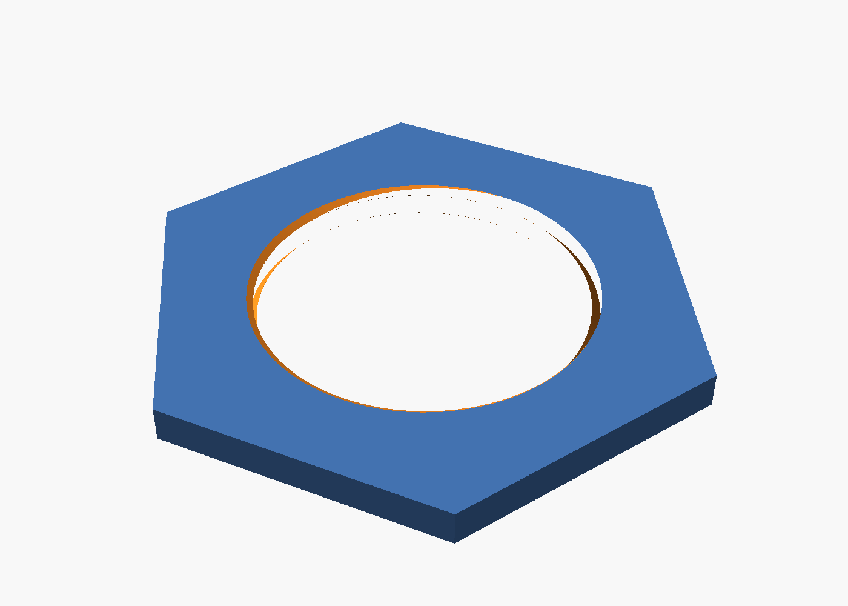
40-cad/openscad/podglad/podstawka-Nakretka.png
