senecjusz/Dynia-eyes/40-cad/openscad/podglad/podstawka-Szuflada.png

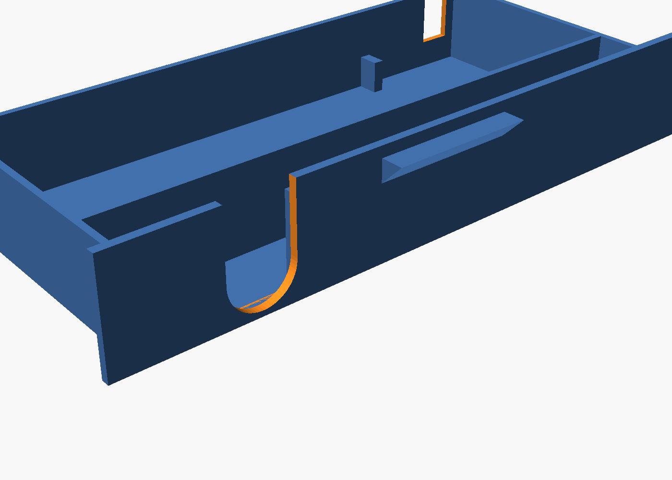
40-cad/openscad/podglad/podstawka-Szuflada.png
