senecjusz/Dynia-eyes/40-cad/openscad/podglad/podstawka-Tuleja.png

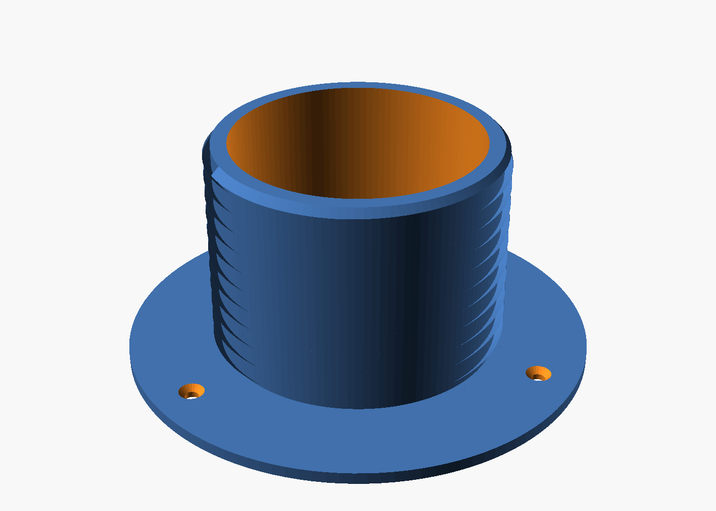
40-cad/openscad/podglad/podstawka-Tuleja.png
