senecjusz/Dynia-eyes/40-cad/openscad/podglad/podstawka-v2-front-tyl.png

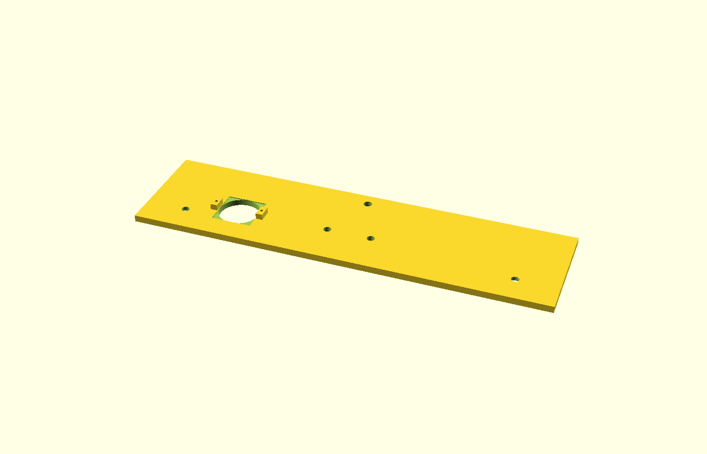
40-cad/openscad/podglad/podstawka-v2-front-tyl.png
