senecjusz/Dynia-eyes/40-cad/openscad/podglad/podstawka-v2-kaseta-gniazdo.png

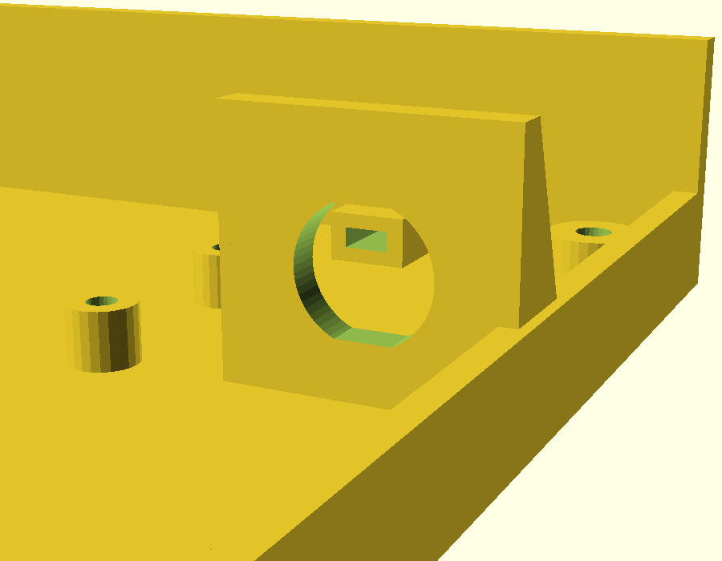
40-cad/openscad/podglad/podstawka-v2-kaseta-gniazdo.png
