senecjusz/Dynia-eyes/40-cad/openscad/podglad/podstawka-v2-kaseta-uklad.png

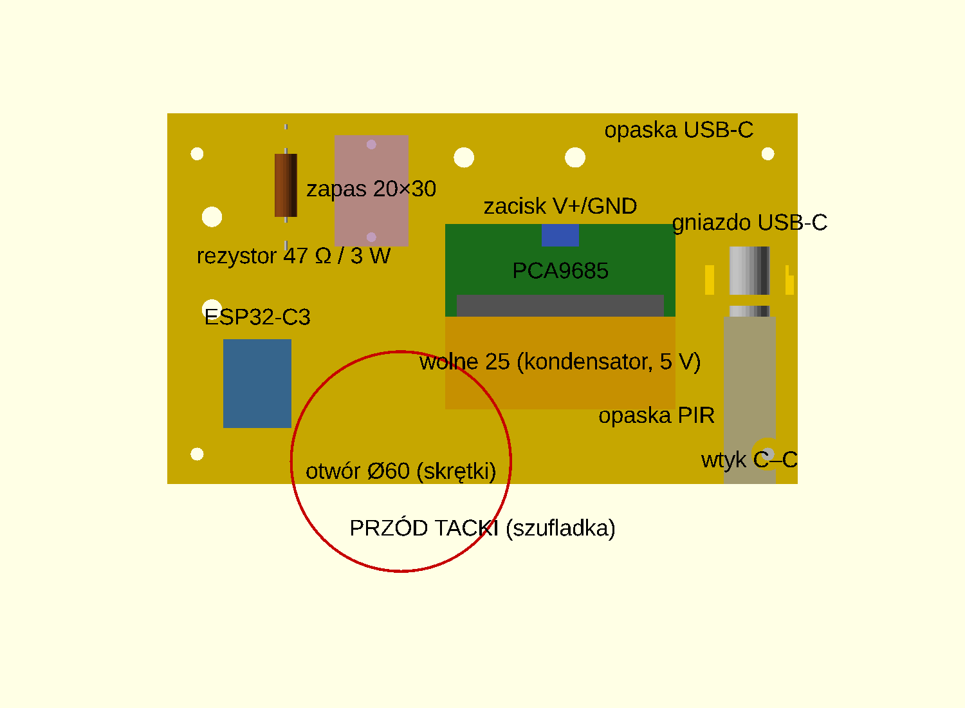
40-cad/openscad/podglad/podstawka-v2-kaseta-uklad.png
