senecjusz/Dynia-eyes/40-cad/openscad/podglad/podstawka-v2-korpus.png

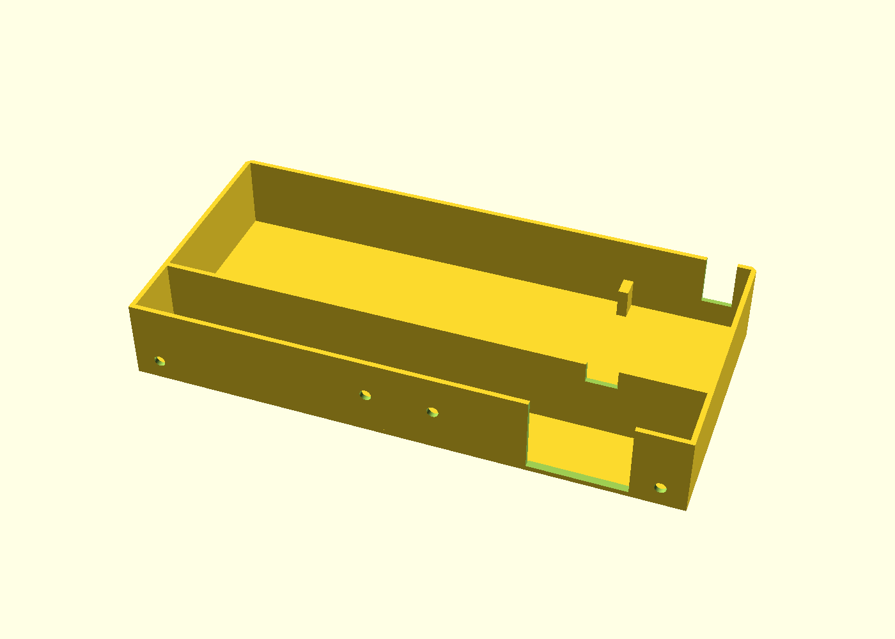
40-cad/openscad/podglad/podstawka-v2-korpus.png
