senecjusz/Dynia-eyes/40-cad/openscad/podglad/podstawka-v2-pir-montaz.png

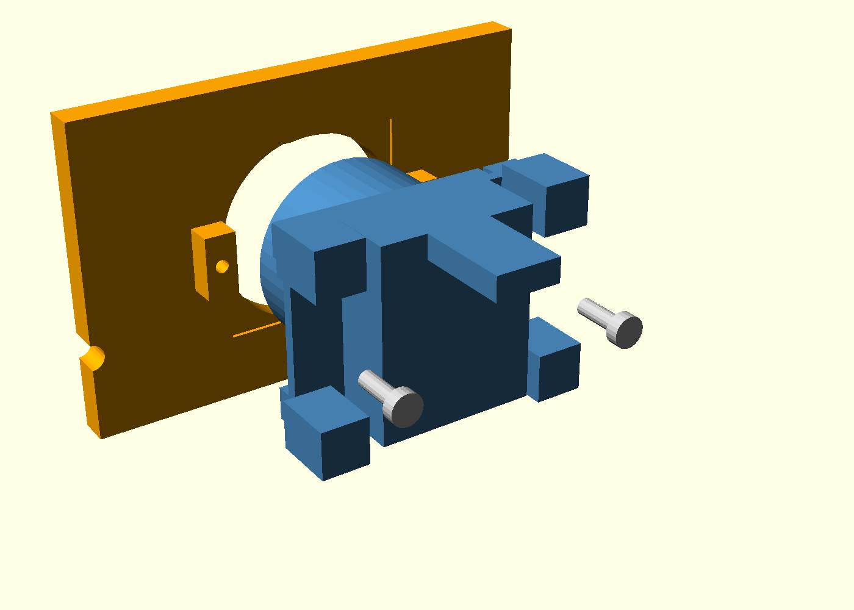
40-cad/openscad/podglad/podstawka-v2-pir-montaz.png
