senecjusz/Dynia-eyes/40-cad/openscad/podglad/podstawka-v2-pir-przekroj.png

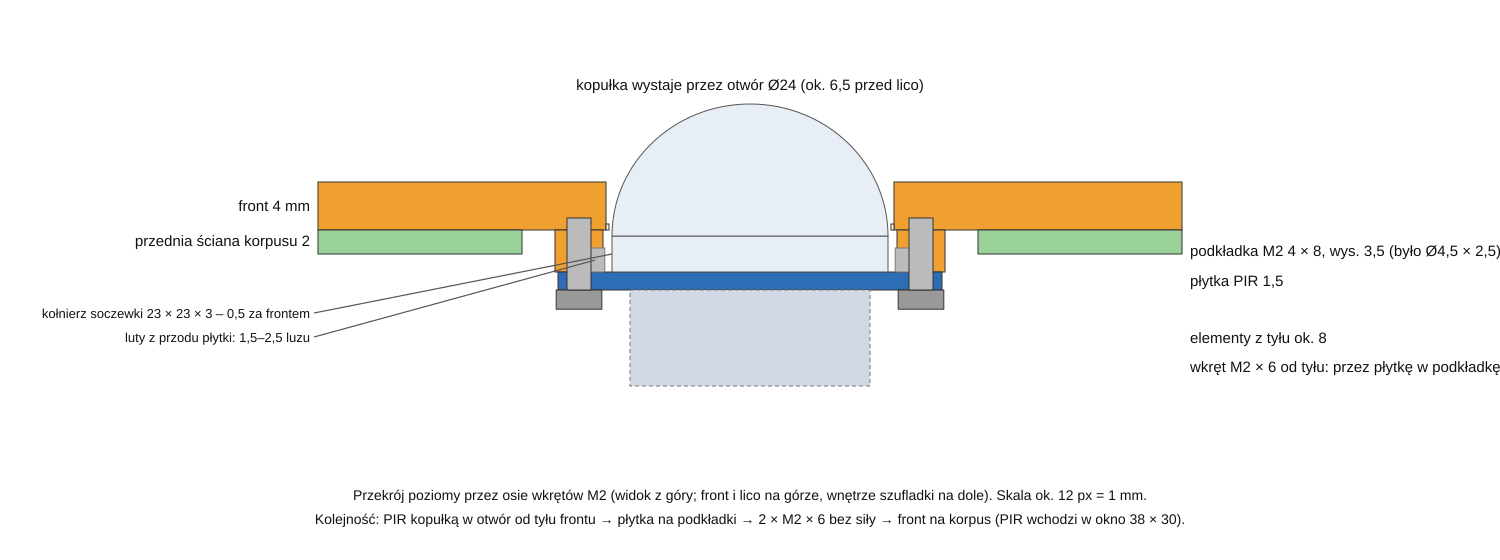
40-cad/openscad/podglad/podstawka-v2-pir-przekroj.png
