senecjusz/Dynia-eyes/40-cad/openscad/podglad/podstawka-v2-podkladka-esp.png

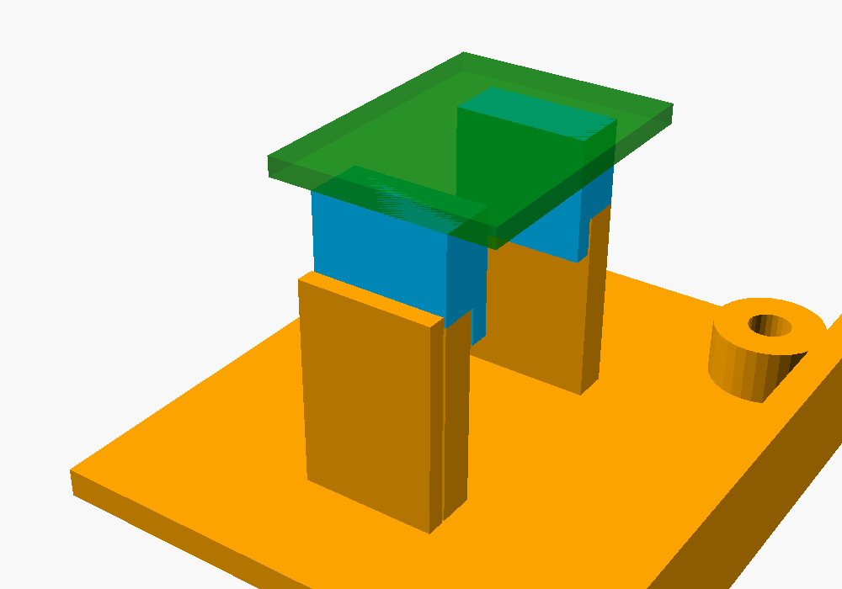
40-cad/openscad/podglad/podstawka-v2-podkladka-esp.png
