senecjusz/Dynia-eyes/40-cad/openscad/podglad/podstawka-v2-przycisk.png

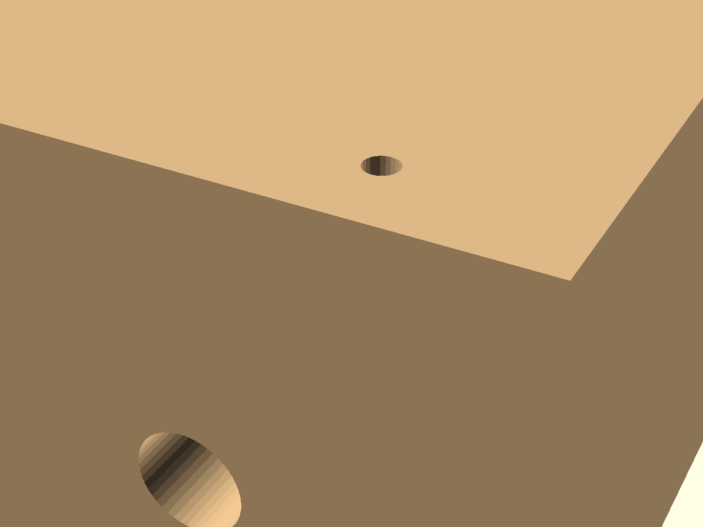
40-cad/openscad/podglad/podstawka-v2-przycisk.png
