senecjusz/Dynia-eyes/40-cad/openscad/podglad/podstawka-v2-raczka.png

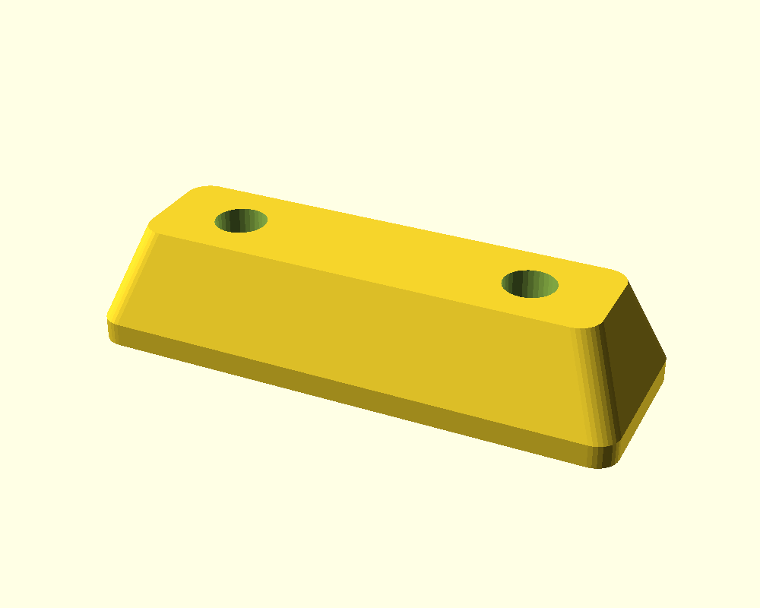
40-cad/openscad/podglad/podstawka-v2-raczka.png
