senecjusz/Dynia-eyes/40-cad/openscad/podglad/podstawka-v2-zlozenie.png

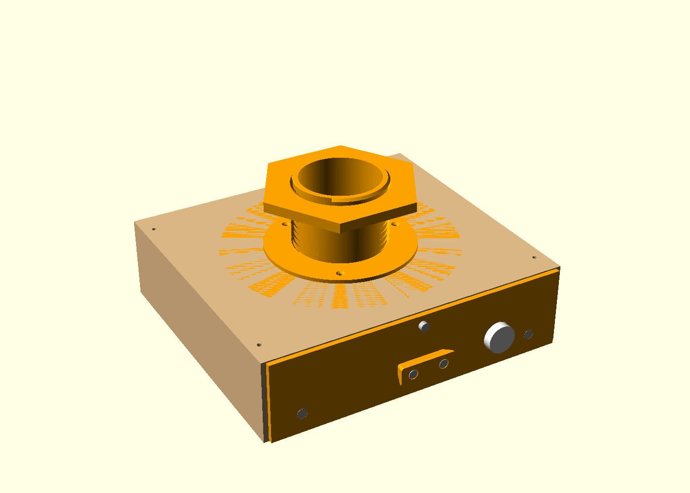
40-cad/openscad/podglad/podstawka-v2-zlozenie.png
