senecjusz/Dynia-eyes/40-cad/openscad/podglad/podstawka-zlozenie.png

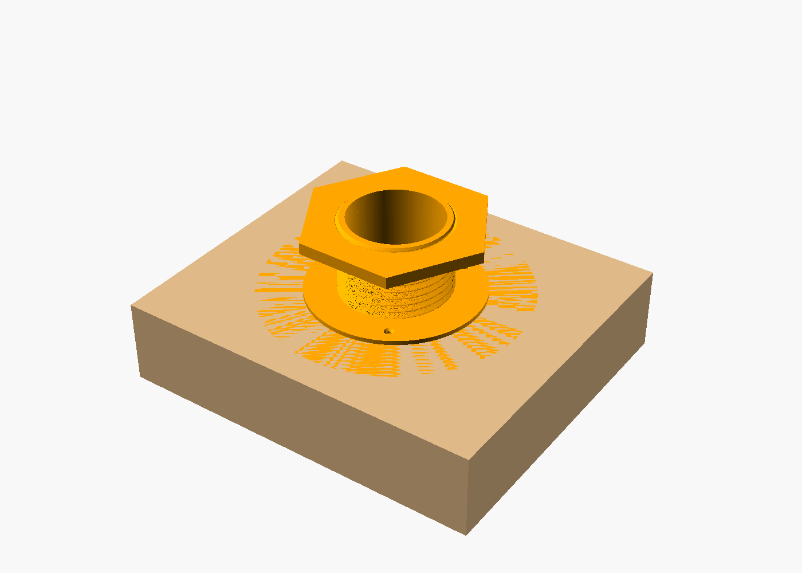
40-cad/openscad/podglad/podstawka-zlozenie.png
