senecjusz/Dynia-eyes/40-cad/openscad/podglad/przod.png

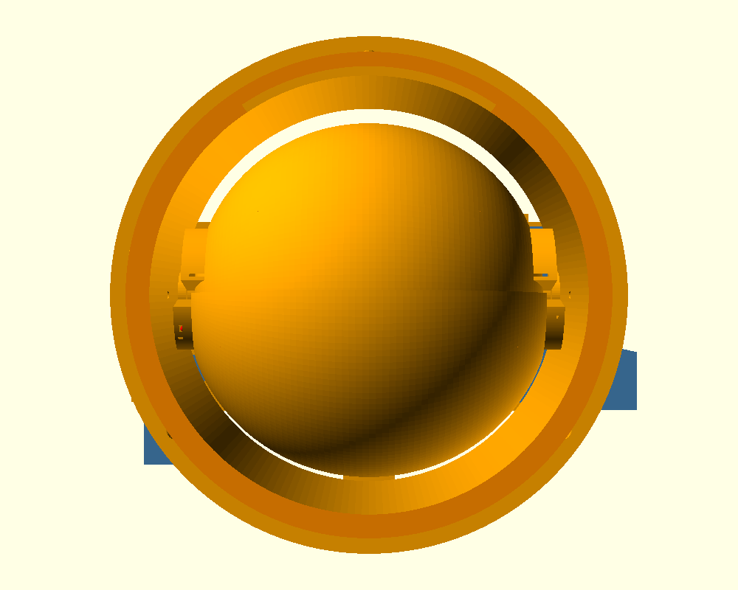
40-cad/openscad/podglad/przod.png
