senecjusz/Dynia-eyes/40-cad/openscad/podglad/tyl_iso.png

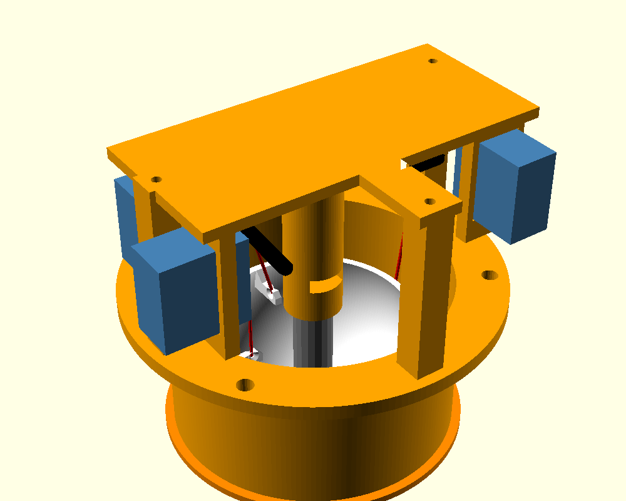
40-cad/openscad/podglad/tyl_iso.png
