senecjusz/Dynia-eyes/40-cad/solidcraft/png/oko-f-v2.3-iso.png

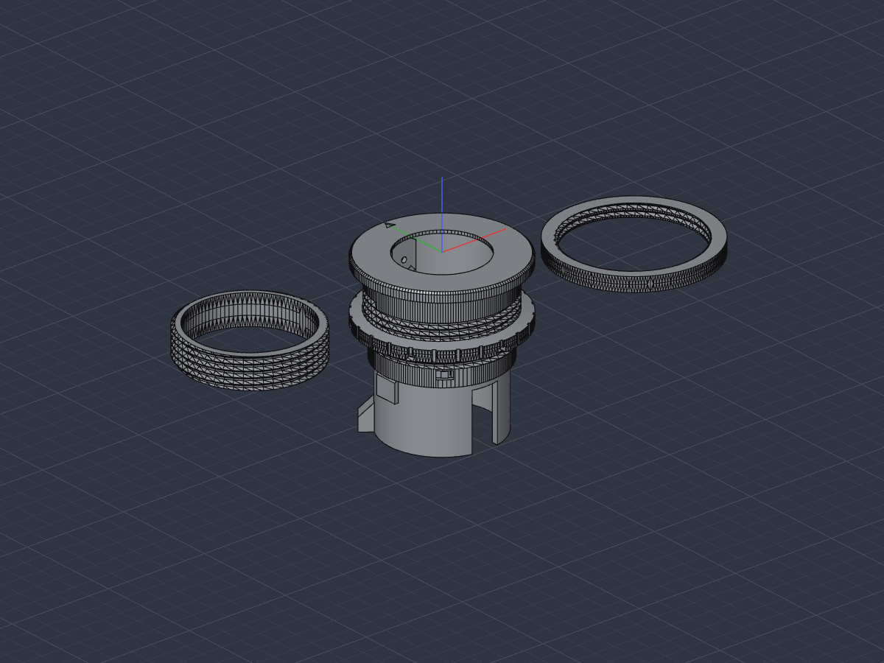
40-cad/solidcraft/png/oko-f-v2.3-iso.png
