senecjusz/Dynia-eyes/40-cad/solidcraft/png/oko-f-v2.3-naped-plus33.png

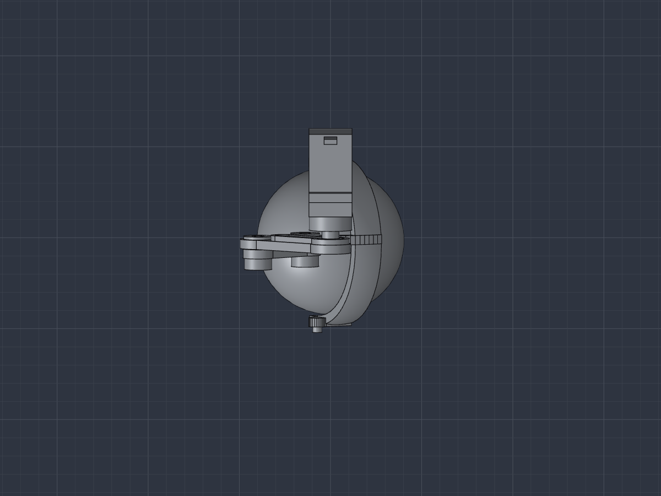
40-cad/solidcraft/png/oko-f-v2.3-naped-plus33.png
