senecjusz/Dynia-eyes/40-cad/solidcraft/png/oko-f-v2.3-tyl.png

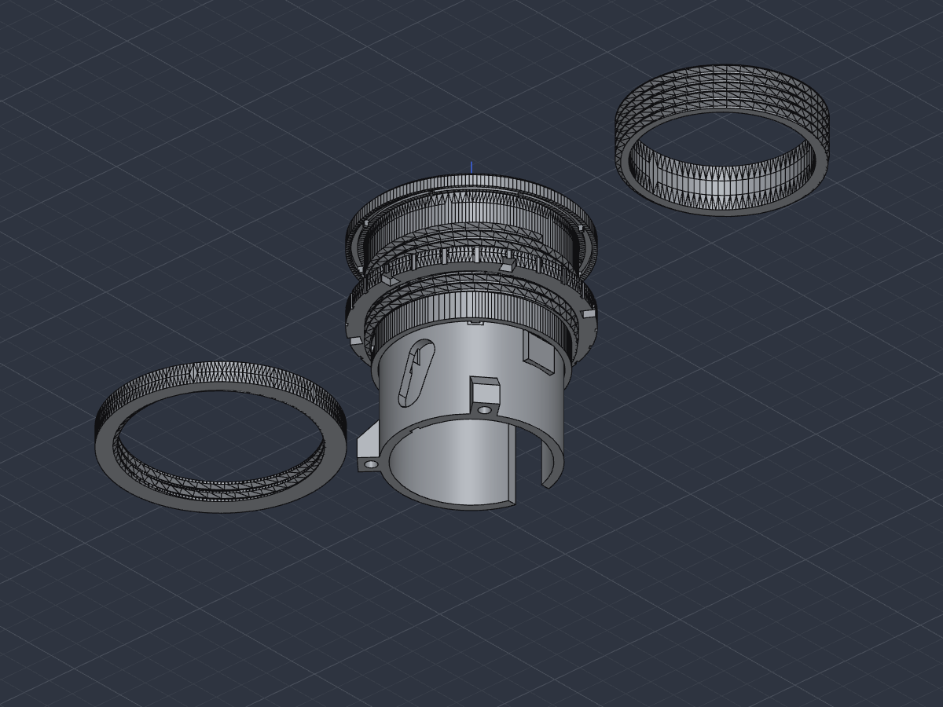
40-cad/solidcraft/png/oko-f-v2.3-tyl.png
