senecjusz/Dynia-eyes/40-cad/solidcraft/png/oko-f-v2.4-kaseta-gora.png

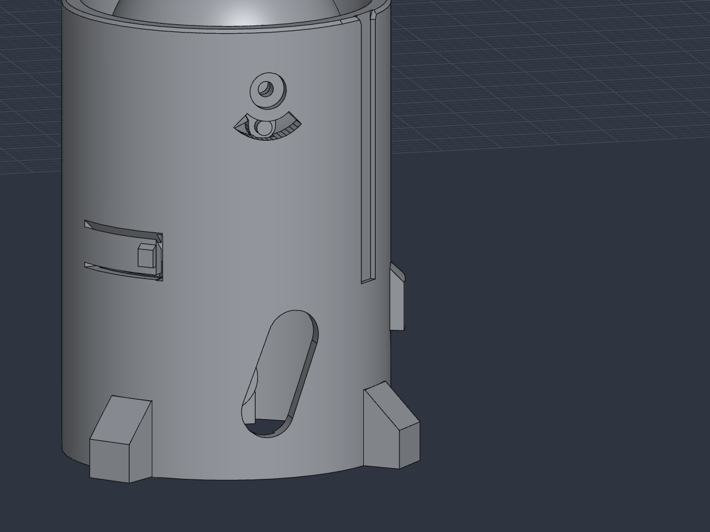
40-cad/solidcraft/png/oko-f-v2.4-kaseta-gora.png
