senecjusz/Dynia-eyes/70-budowa/montaz-v2.8/oko-dwa-zlozenia.png

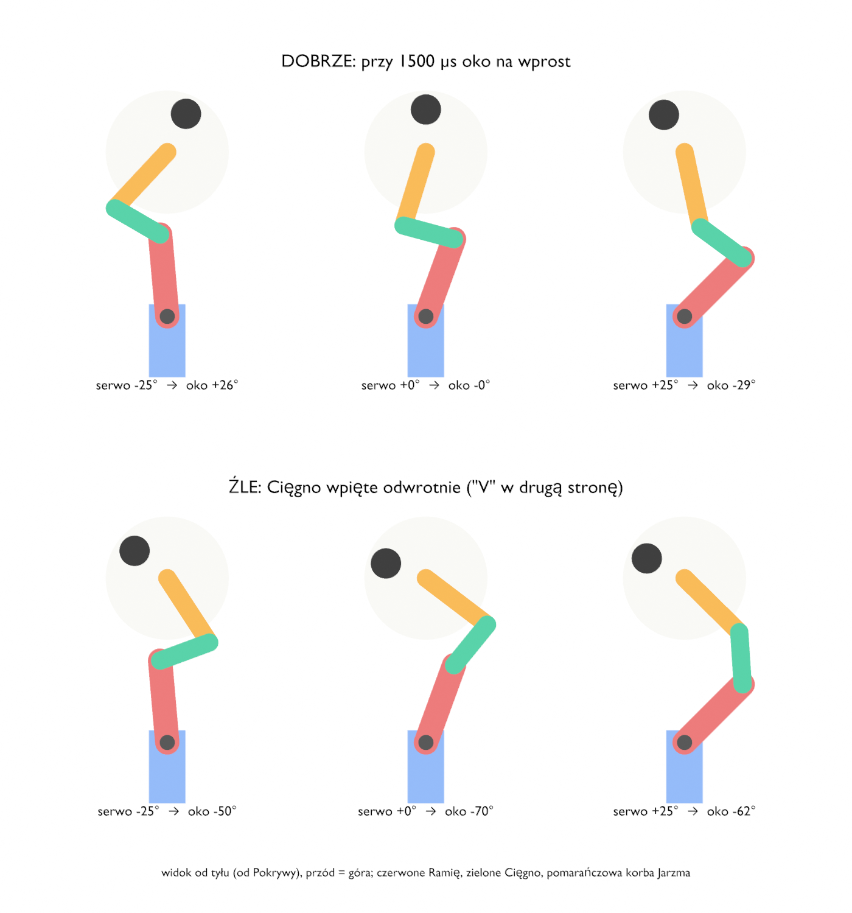
70-budowa/montaz-v2.8/oko-dwa-zlozenia.png
