senecjusz/Dynia-eyes/70-budowa/zdjecia/2026-10-25-kardan-5-5/kardan-01.png

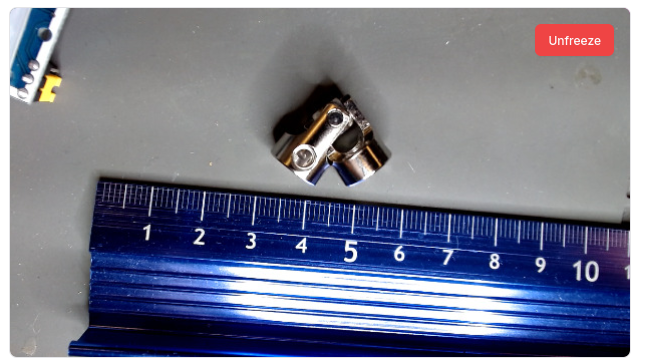
70-budowa/zdjecia/2026-10-25-kardan-5-5/kardan-01.png
