senecjusz/Dynia-eyes/70-budowa/zdjecia/2026-10-25-pir/pir-02.png

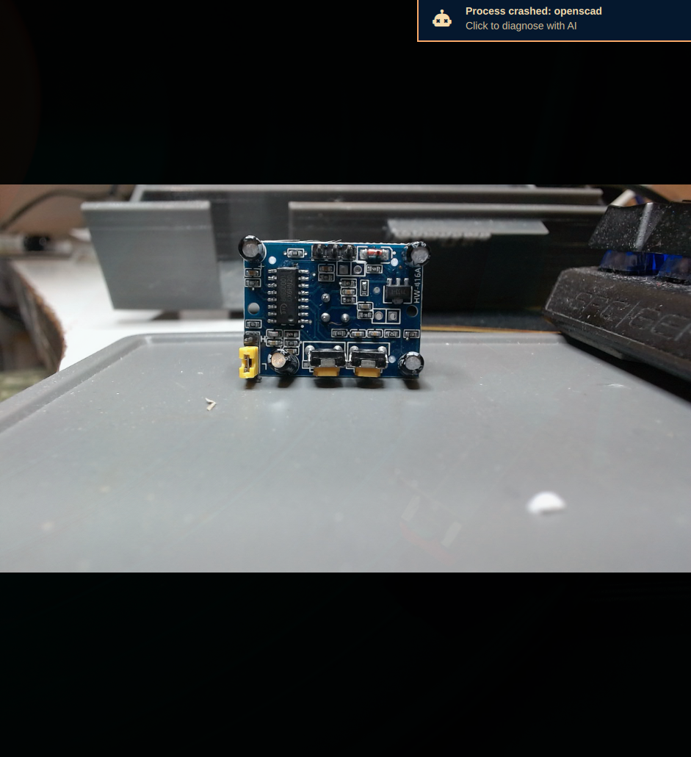
70-budowa/zdjecia/2026-10-25-pir/pir-02.png
