senecjusz/Dynia-eyes/70-budowa/zdjecia/2026-10-26-drut-z/drut-z-01.jpg

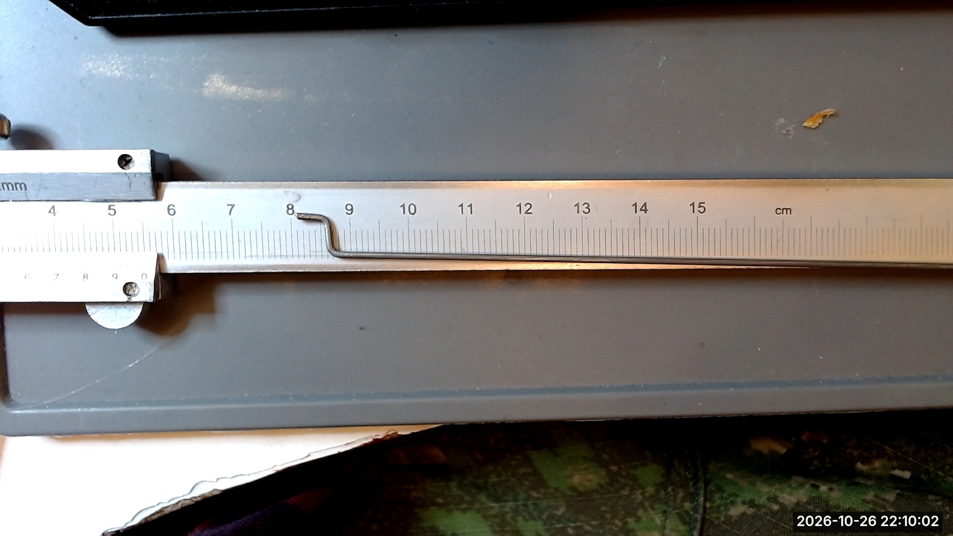
70-budowa/zdjecia/2026-10-26-drut-z/drut-z-01.jpg
