senecjusz/Dynia-eyes/70-budowa/zdjecia/2026-10-26-probka-pir/probka-pir-01.jpg

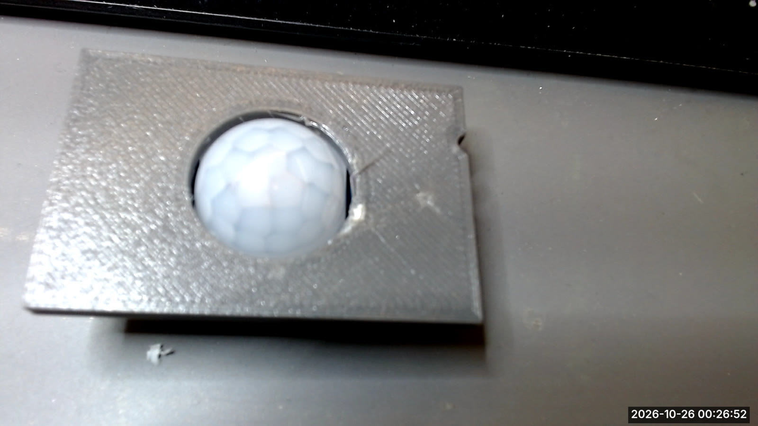
70-budowa/zdjecia/2026-10-26-probka-pir/probka-pir-01.jpg
