senecjusz/Dynia-eyes/70-budowa/zdjecia/2026-10-28-serwa-plyta/serwa-01-przed.jpg

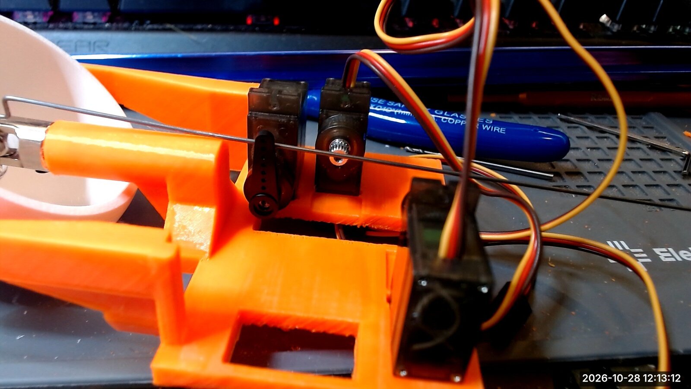
70-budowa/zdjecia/2026-10-28-serwa-plyta/serwa-01-przed.jpg
