senecjusz/Dynia-eyes/70-budowa/zdjecia/2026-10-28-serwa-plyta/serwa-03-pret-gd.jpg

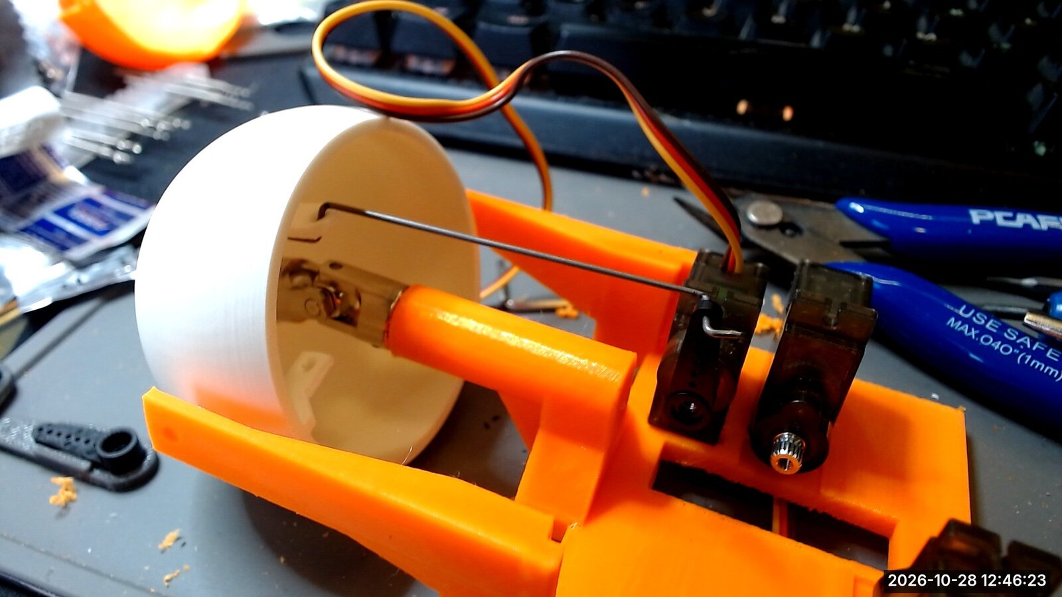
70-budowa/zdjecia/2026-10-28-serwa-plyta/serwa-03-pret-gd.jpg
