senecjusz/Dynia-eyes/40-cad/3mf/Oko F v2.8/Oko F v2.8 - FullProject.3mf

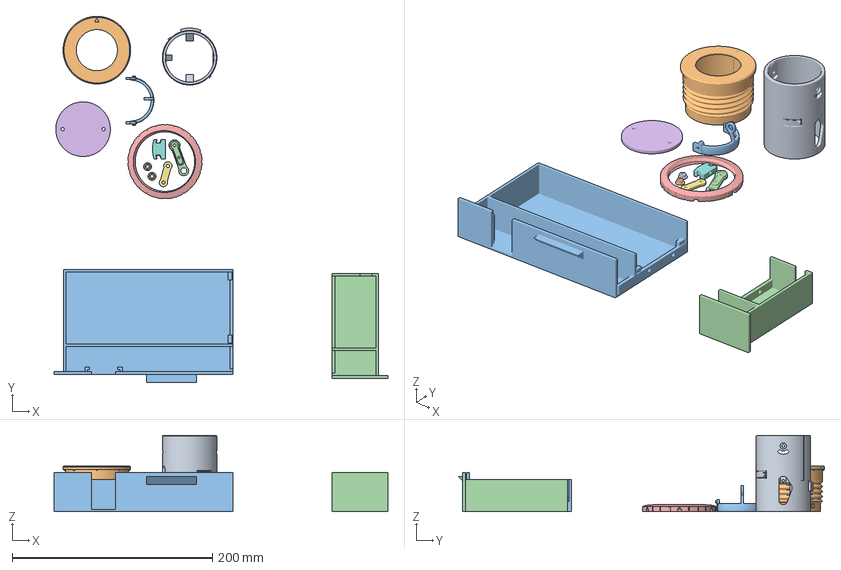
[picture p135: CAD file, 2026-10-25]
40-cad/3mf/Oko F v2.8/Oko F v2.8 - FullProject.3mf
333.4 x 365.6 x 76.0 mm
Kaseta
Gniazdo
Jarzmo z miską
Ramię orczyka
Nakrętka
Pokrywa tylna
Cięgno
Klamra H
Tulejka przegubu korby
Tulejka przegubu ramienia
