senecjusz/Dynia-eyes/40-cad/3mf/Duze oko v3/Duze oko v3 - wszystkie czesci.3mf

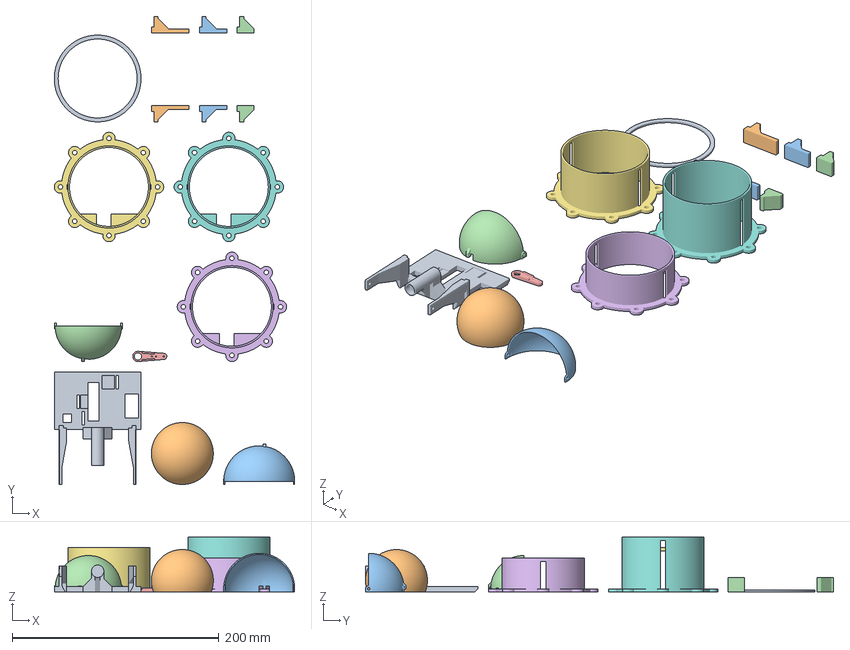
[picture p136: CAD file, 2026-10-28]
40-cad/3mf/Duze oko v3/Duze oko v3 - wszystkie czesci.3mf
232.8 x 453.0 x 53.0 mm
Plyta
Galka
Powieka gorna
Powieka dolna
Przedluzenie orczyka (druk x2)
Tuba 30
Tuba 40
Tuba 50
Maskownica
Wspornik plyty 30 (druk x2)
Wspornik plyty 40 (druk x2)
Wspornik plyty 50 (druk x2)
