senecjusz/Dynia-eyes/40-cad/3mf/Final-Print.3mf

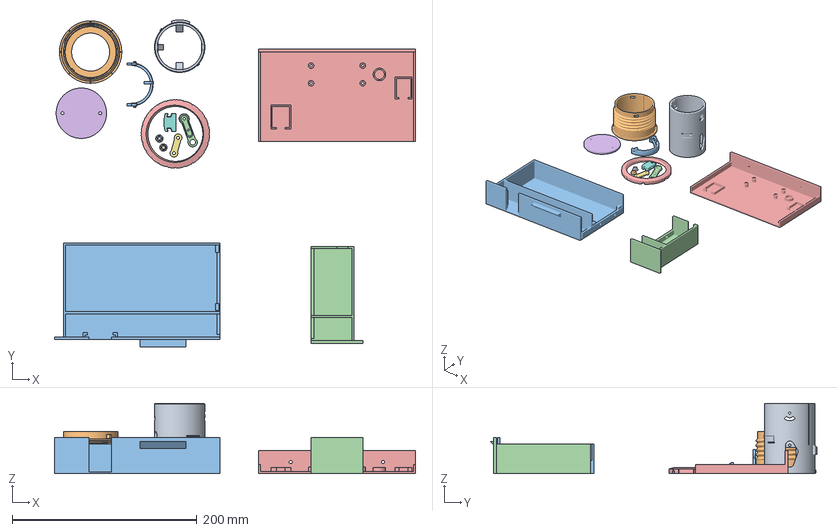
[picture p137: CAD file, 2026-10-25]
40-cad/3mf/Final-Print.3mf
390.4 x 353.9 x 76.0 mm
Kaseta
Gniazdo
Jarzmo z miską
Ramię orczyka
Nakrętka
Pokrywa tylna
Cięgno
Klamra H
Tulejka przegubu korby
Tulejka przegubu ramienia
