senecjusz/Dynia-eyes/40-cad/3mf/Podstawka v2/Probka gwintu - nakretka.3mf

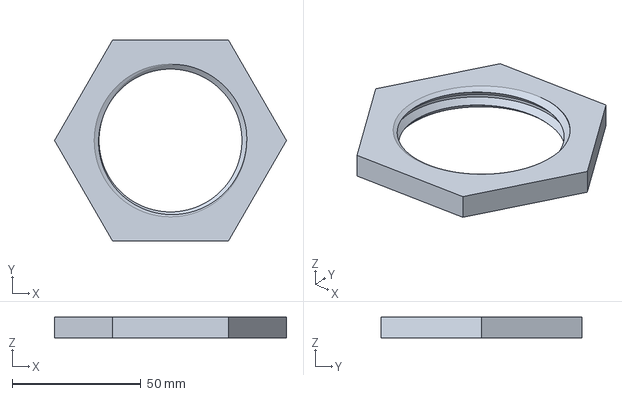
[picture p138: CAD file, 2026-10-28]
40-cad/3mf/Podstawka v2/Probka gwintu - nakretka.3mf
90.0 x 77.9 x 8.00 mm
