senecjusz/Dynia-eyes/40-cad/archiwum/v1/modul-czop-v1.stl

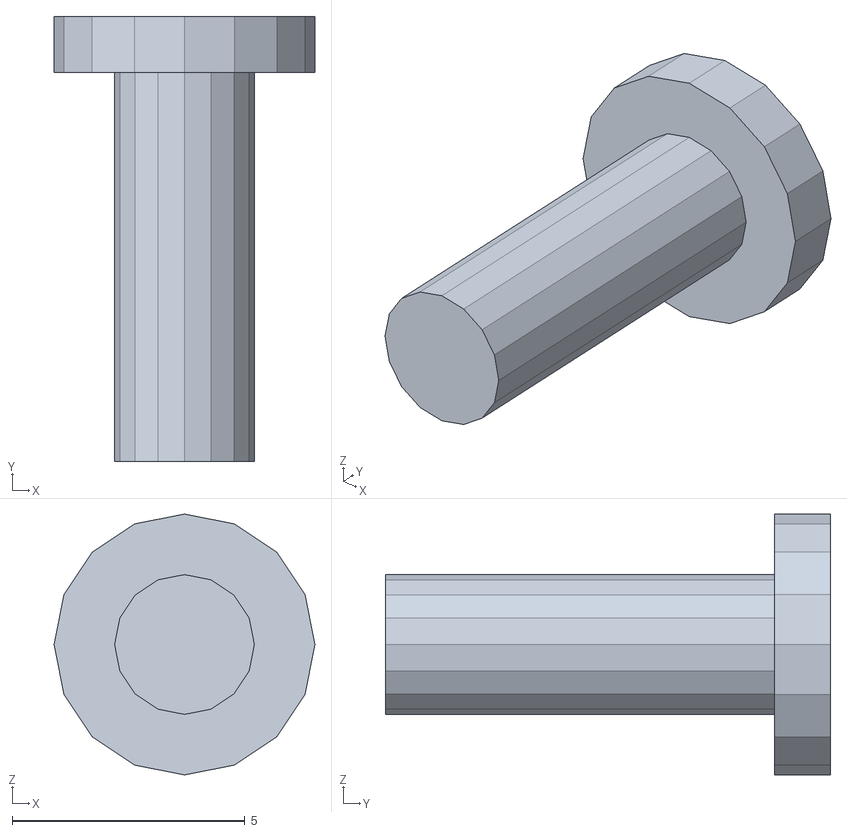
[picture p139: CAD file, 2026-10-17]
40-cad/archiwum/v1/modul-czop-v1.stl
5.60 x 9.55 x 5.60
