senecjusz/Dynia-eyes/40-cad/stl/nakretka-v1.1.stl

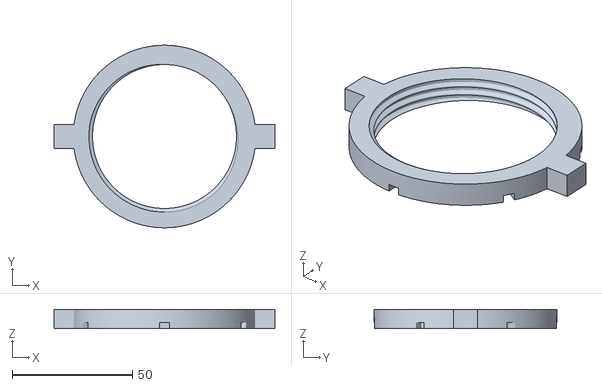
[picture p140: CAD file, 2026-10-17]
40-cad/stl/nakretka-v1.1.stl
92.0 x 76.0 x 8.00
