senecjusz/Dynia-eyes/40-cad/3mf/oko-f-v1.1.3mf

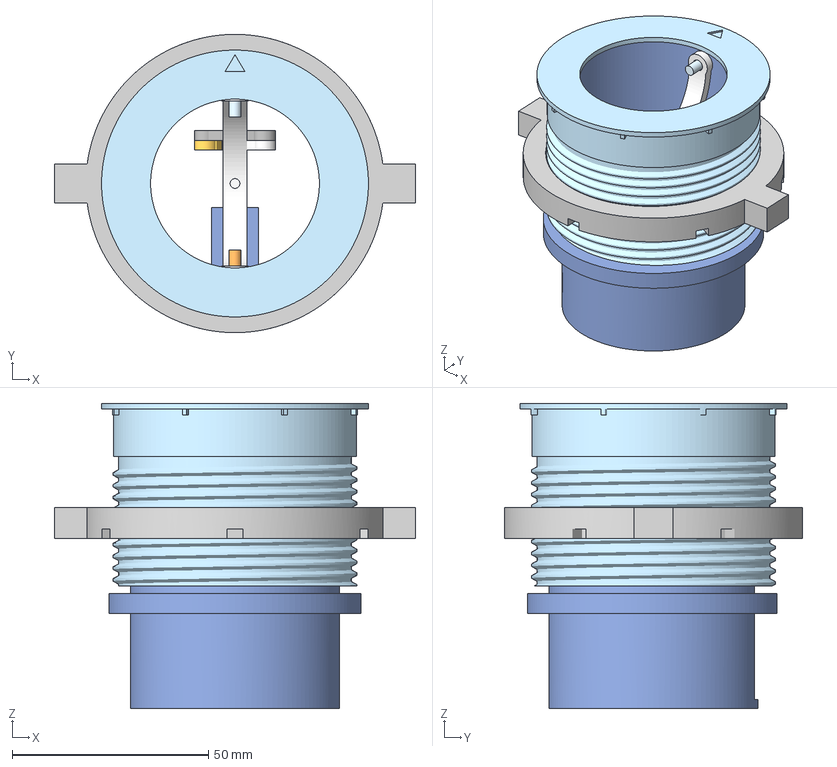
[picture p142: CAD file, 2026-10-17]
40-cad/3mf/oko-f-v1.1.3mf
92.0 x 76.0 x 77.8 mm
Gniazdo
Nakretka
Tuleja modulu
Jarzmo
Czop gora
Czop dol
Ciegno
Ramie orczyka
