senecjusz/Dynia-eyes/40-cad/3mf/Podstawka v2/Tuleja z gwintem.3mf

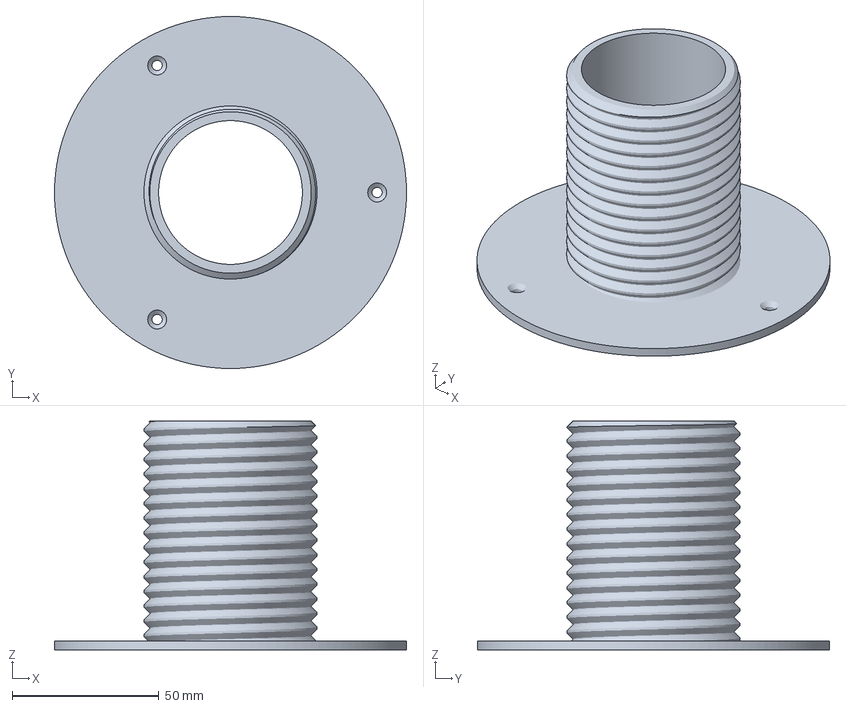
[picture p143: CAD file, 2026-10-28]
40-cad/3mf/Podstawka v2/Tuleja z gwintem.3mf
120.0 x 120.0 x 78.0 mm
