senecjusz/Dynia-eyes/40-cad/archiwum/v1/modul-jarzmo-v1.stl

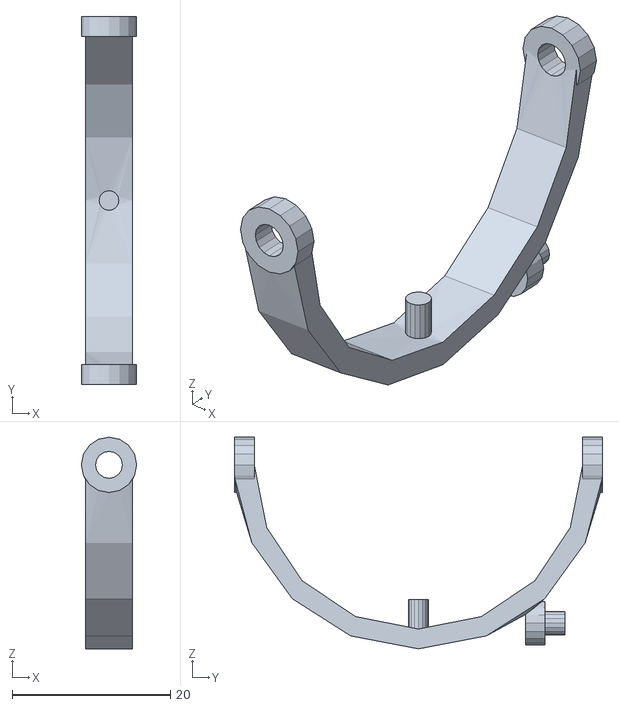
[picture p144: CAD file, 2026-10-17]
40-cad/archiwum/v1/modul-jarzmo-v1.stl
7.00 x 46.5 x 26.8
