senecjusz/Dynia-eyes/40-cad/stl/modul-tuleja-v1.1.stl

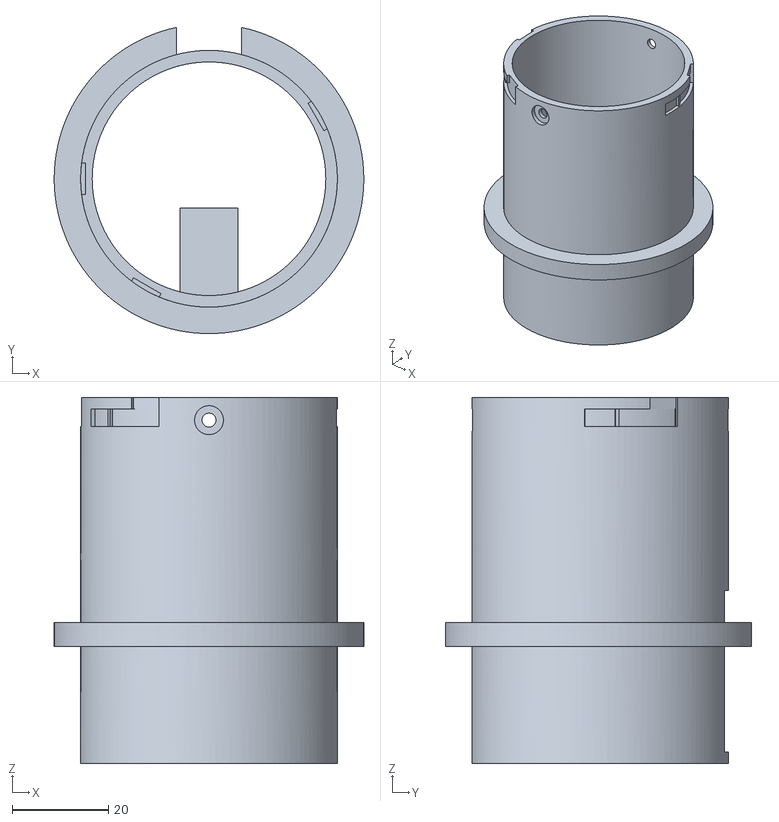
[picture p145: CAD file, 2026-10-17]
40-cad/stl/modul-tuleja-v1.1.stl
64.3 x 63.6 x 76.0
