senecjusz/Dynia-eyes/40-cad/3mf/Duze oko v3/Wspornik plyty 30 (druk x2).3mf

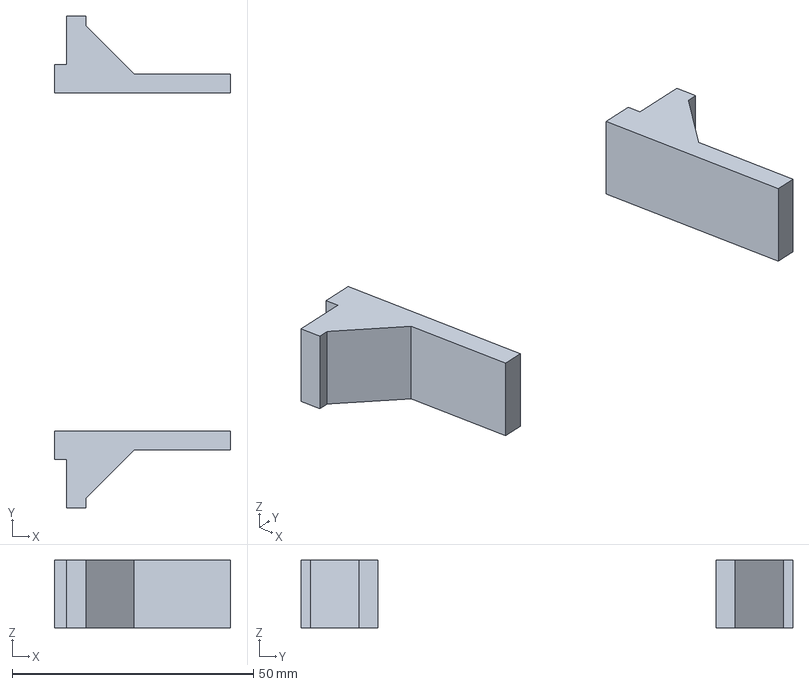
[picture p146: CAD file, 2026-10-28]
40-cad/3mf/Duze oko v3/Wspornik plyty 30 (druk x2).3mf
36.5 x 102.0 x 14.0 mm
