senecjusz/Dynia-eyes/40-cad/archiwum/v1/modul-ciegno-v1.stl

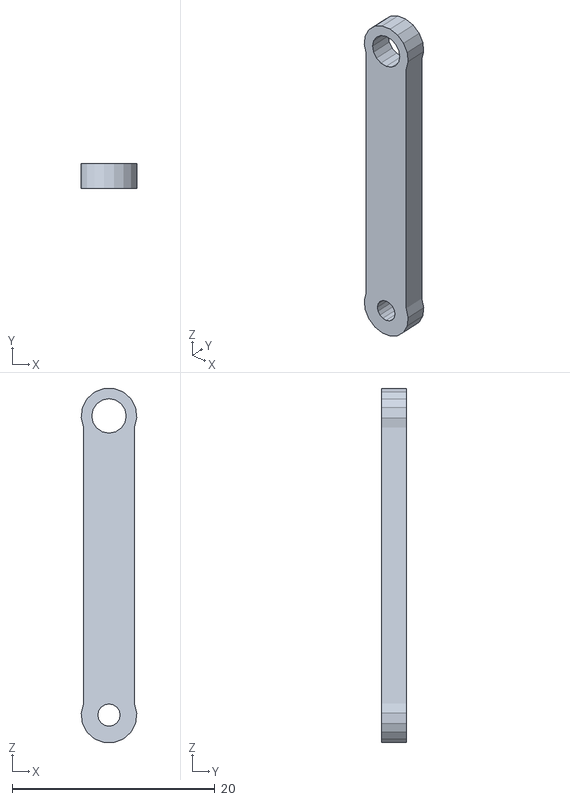
[picture p147: CAD file, 2026-10-17]
40-cad/archiwum/v1/modul-ciegno-v1.stl
5.49 x 2.50 x 34.9
