senecjusz/Dynia-eyes/40-cad/stl/modul-ciegno-v1.1.stl

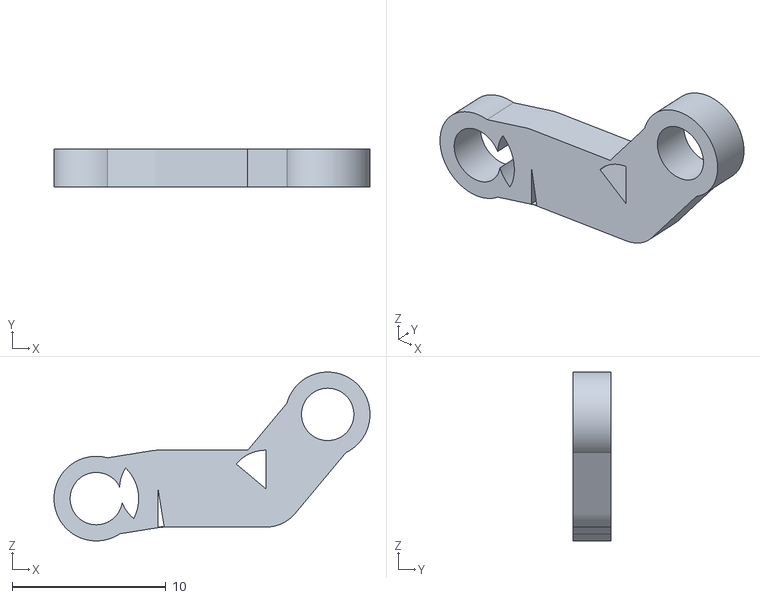
[picture p148: CAD file, 2026-10-17]
40-cad/stl/modul-ciegno-v1.1.stl
20.5 x 2.50 x 11.0
