senecjusz/Dynia-eyes/40-cad/3mf/Duze oko v3/Wspornik plyty 40 (druk x2).3mf

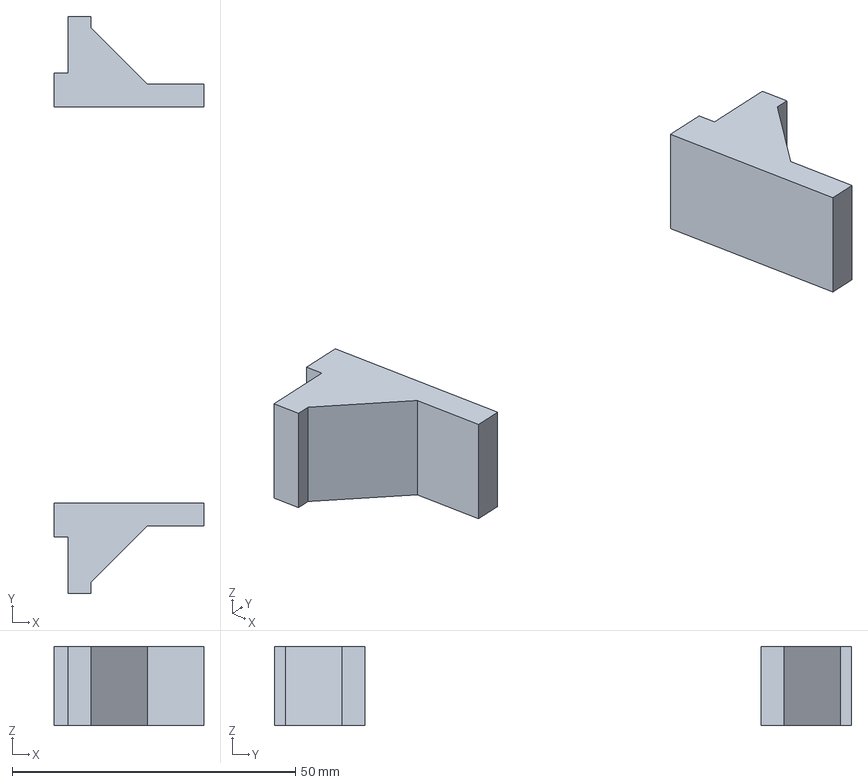
[picture p149: CAD file, 2026-10-28]
40-cad/3mf/Duze oko v3/Wspornik plyty 40 (druk x2).3mf
26.5 x 102.0 x 14.0 mm
