senecjusz/Dynia-eyes/40-cad/3mf/Podstawka v2/Probka gwintu - tuleja.3mf

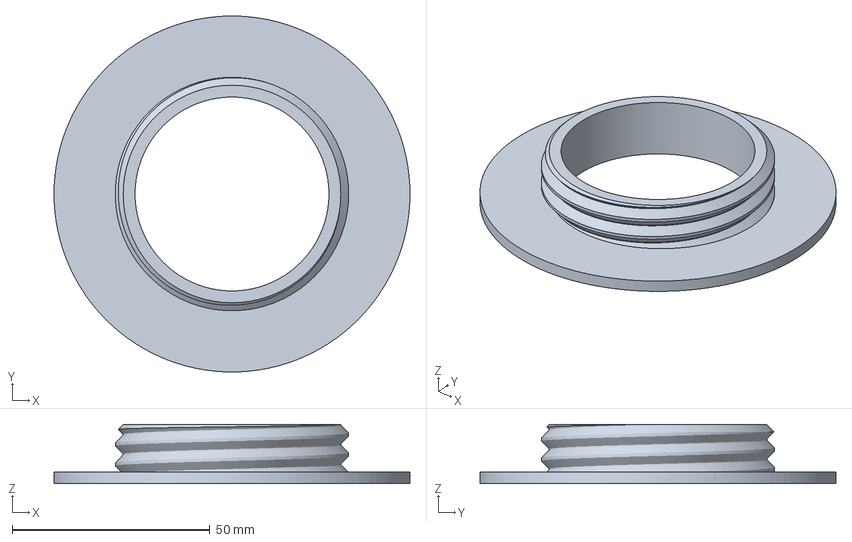
[picture p150: CAD file, 2026-10-28]
40-cad/3mf/Podstawka v2/Probka gwintu - tuleja.3mf
90.0 x 90.0 x 15.0 mm
