senecjusz/Dynia-eyes/40-cad/archiwum/v1/gniazdo-v1.stl

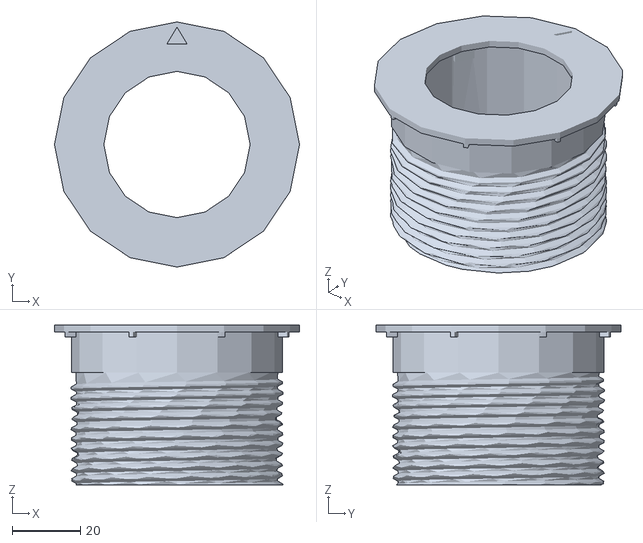
[picture p151: CAD file, 2026-10-17]
40-cad/archiwum/v1/gniazdo-v1.stl
72.0 x 72.0 x 47.0
