senecjusz/Dynia-eyes/40-cad/stl/modul-ramie-orczyka-v1.1.stl

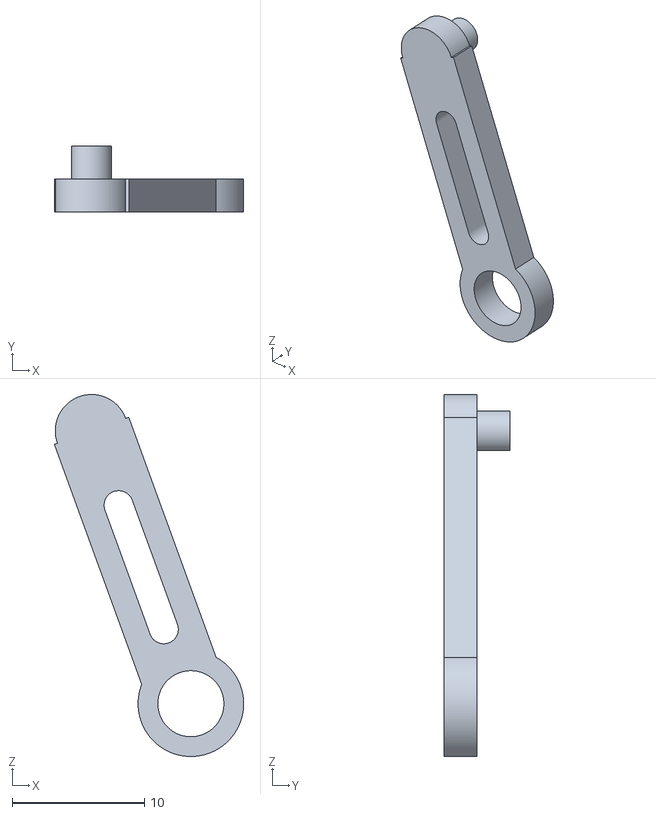
[picture p152: CAD file, 2026-10-17]
40-cad/stl/modul-ramie-orczyka-v1.1.stl
14.3 x 5.00 x 27.4
