senecjusz/Dynia-eyes/40-cad/3mf/Podstawka v2/Tacka - podkladki ESP (2 szt).3mf

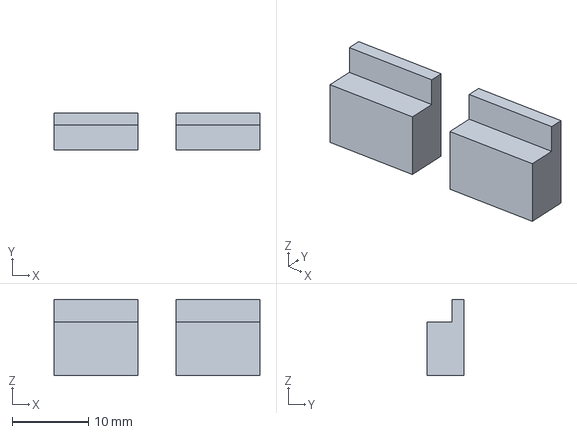
[picture p154: CAD file, 2026-10-28]
40-cad/3mf/Podstawka v2/Tacka - podkladki ESP (2 szt).3mf
27.0 x 4.90 x 10.0 mm
