senecjusz/Dynia-eyes/40-cad/archiwum/v1/modul-tuleja-v1.stl

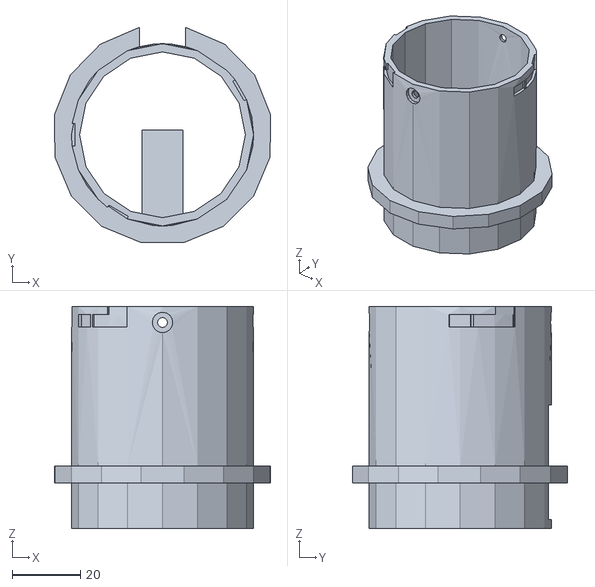
[picture p155: CAD file, 2026-10-17]
40-cad/archiwum/v1/modul-tuleja-v1.stl
63.2 x 63.0 x 65.0
