senecjusz/Dynia-eyes/40-cad/stl/modul-czop-v1.1.stl

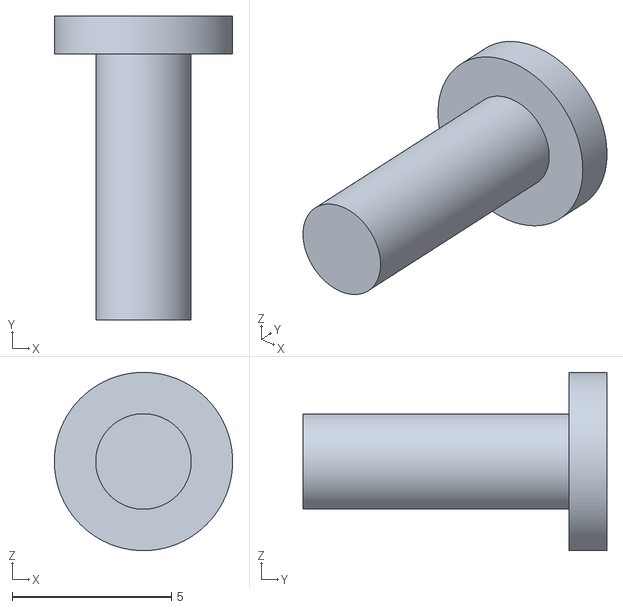
[picture p156: CAD file, 2026-10-17]
40-cad/stl/modul-czop-v1.1.stl
5.60 x 9.55 x 5.60
