senecjusz/Dynia-eyes/40-cad/3mf/Duze oko v3/Tuba 30.3mf

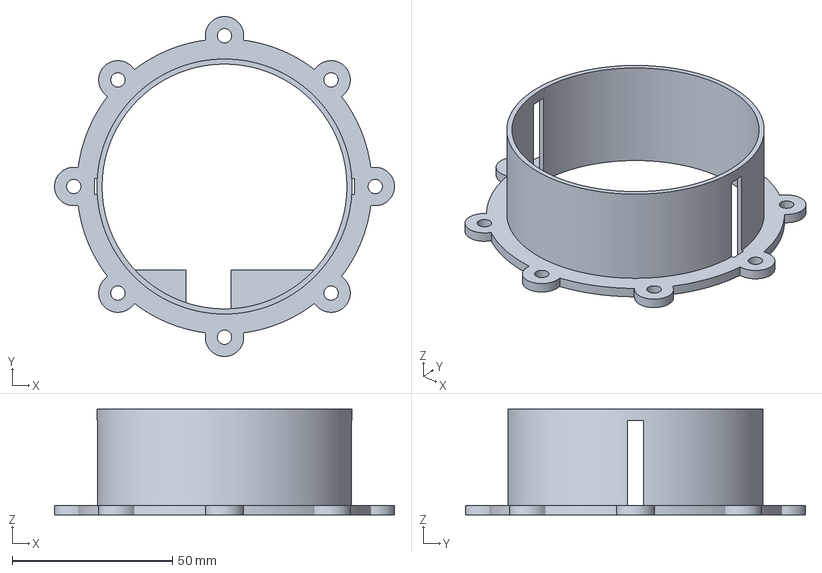
[picture p157: CAD file, 2026-10-28]
40-cad/3mf/Duze oko v3/Tuba 30.3mf
106.0 x 106.0 x 33.0 mm
