senecjusz/Dynia-eyes/40-cad/3mf/Podstawka v2/Kaseta elektroniki.3mf

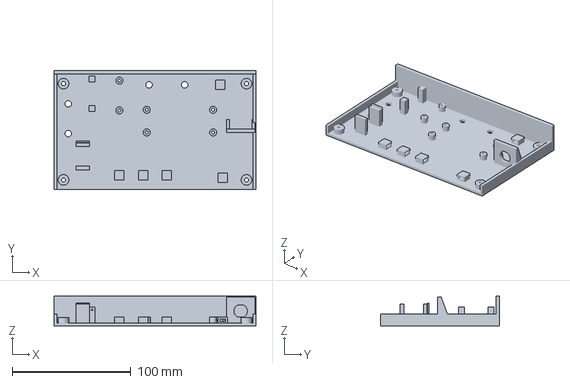
[picture p158: CAD file, 2026-10-26]
40-cad/3mf/Podstawka v2/Kaseta elektroniki.3mf
170.0 x 100.0 x 25.0 mm
