senecjusz/Dynia-eyes/40-cad/stl/gniazdo-v1.1.stl

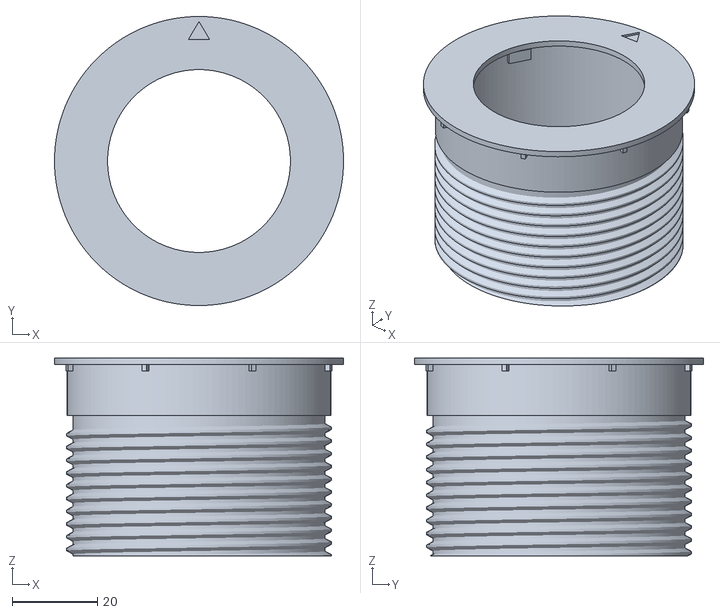
[picture p159: CAD file, 2026-10-17]
40-cad/stl/gniazdo-v1.1.stl
68.0 x 68.0 x 46.5
