senecjusz/Dynia-eyes/40-cad/3mf/Podstawka v2/Szuflada v2 - front (X1C).3mf

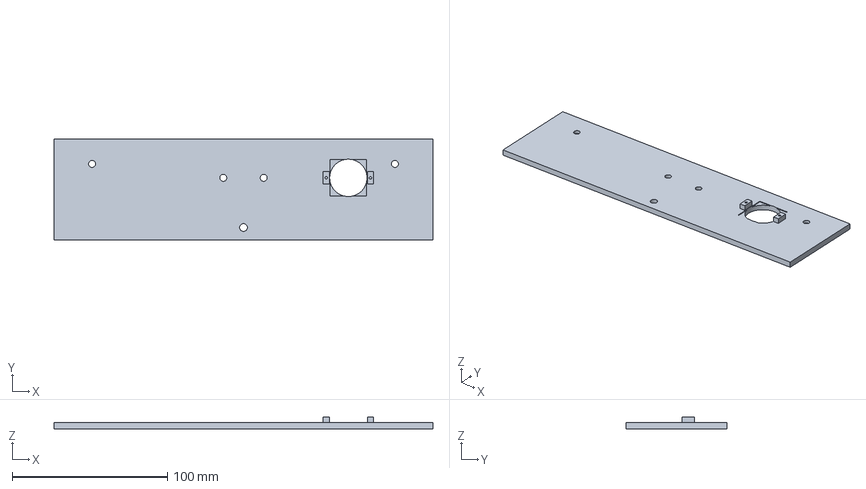
[picture p161: CAD file, 2026-10-25]
40-cad/3mf/Podstawka v2/Szuflada v2 - front (X1C).3mf
244.0 x 65.0 x 7.50 mm
