senecjusz/Dynia-eyes/40-cad/stl/modul-jarzmo-v1.1.stl

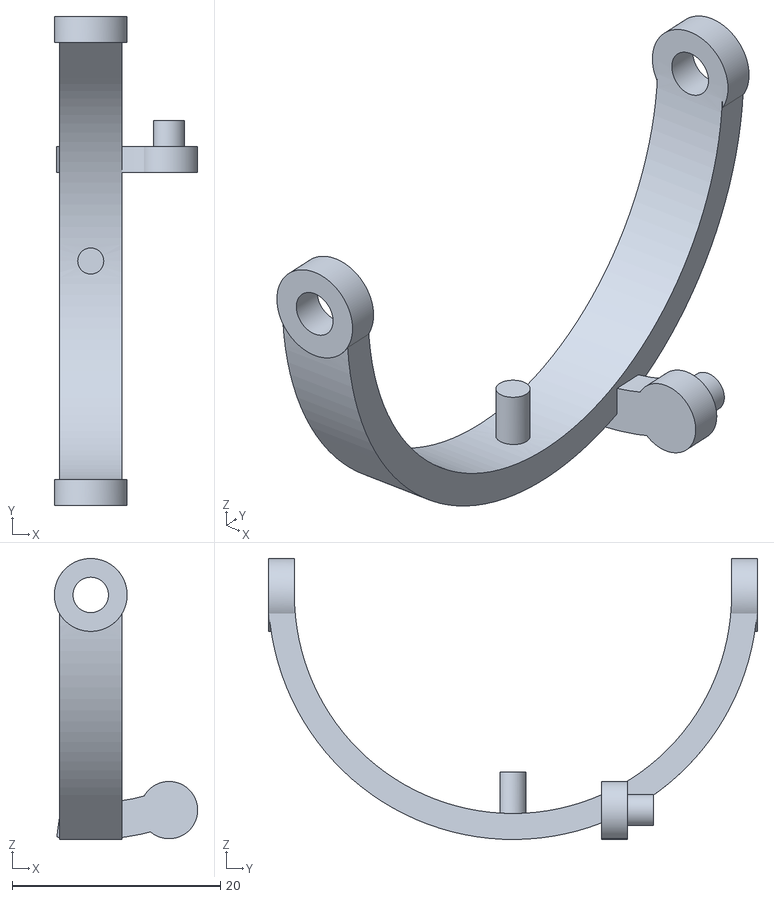
[picture p162: CAD file, 2026-10-17]
40-cad/stl/modul-jarzmo-v1.1.stl
13.8 x 47.0 x 27.0
