senecjusz/Dynia-eyes/40-cad/3mf/Duze oko v3/Przedluzenie orczyka (druk x2).3mf

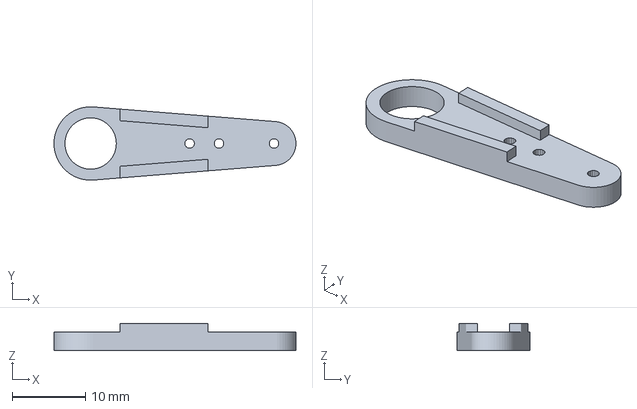
[picture p163: CAD file, 2026-10-28]
40-cad/3mf/Duze oko v3/Przedluzenie orczyka (druk x2).3mf
33.0 x 10.00 x 3.70 mm
