senecjusz/Dynia-eyes/40-cad/3mf/Podstawka v2/Szuflada v2 - korpus (X1C).3mf

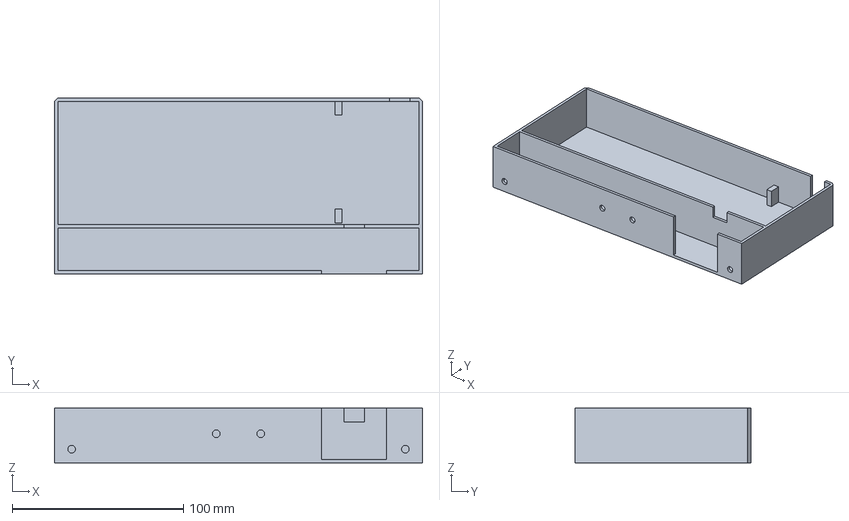
[picture p164: CAD file, 2026-10-25]
40-cad/3mf/Podstawka v2/Szuflada v2 - korpus (X1C).3mf
215.0 x 103.0 x 32.0 mm
