senecjusz/Dynia-eyes/40-cad/3mf/Duze oko v3/Powieka dolna.3mf

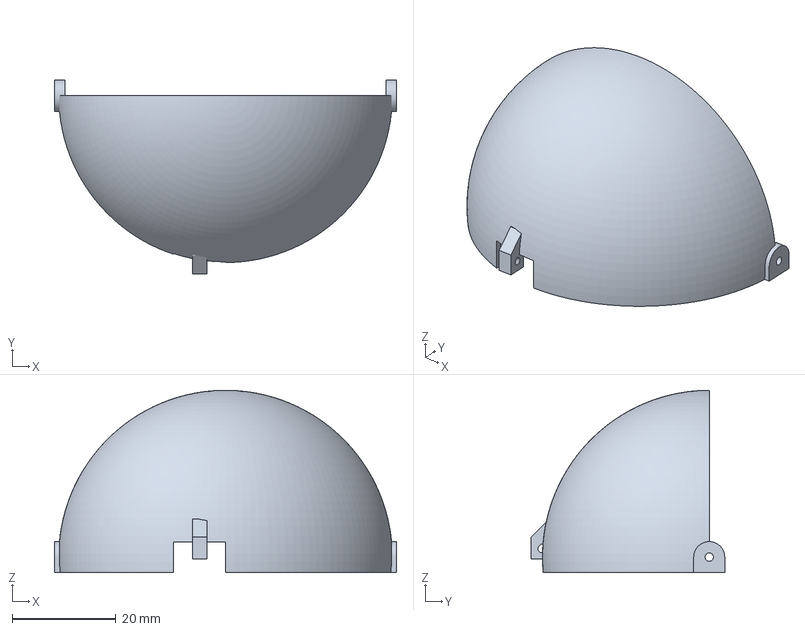
[picture p165: CAD file, 2026-10-28]
40-cad/3mf/Duze oko v3/Powieka dolna.3mf
66.0 x 37.4 x 35.2 mm
