senecjusz/Dynia-eyes/40-cad/3mf/Podstawka v2/Szuflada v2 - raczka.3mf

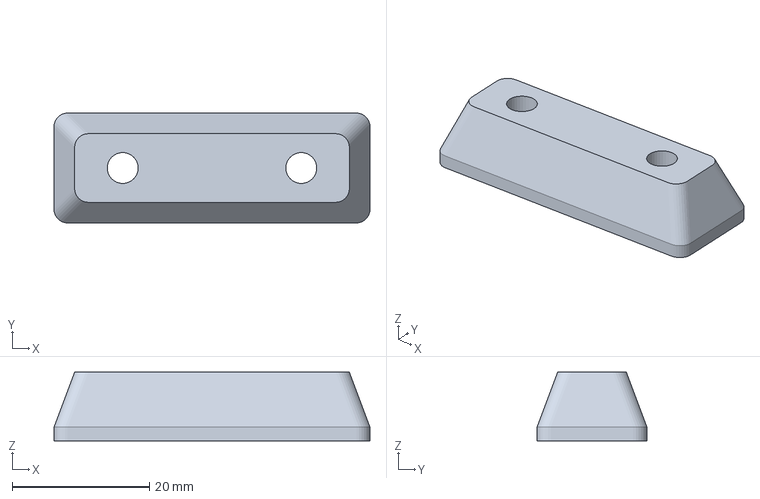
[picture p166: CAD file, 2026-10-25]
40-cad/3mf/Podstawka v2/Szuflada v2 - raczka.3mf
46.0 x 16.0 x 10.0 mm
