senecjusz/Dynia-eyes/40-cad/3mf/Duze oko v3/Trzpien kardana M3 (2 + 2 zapas + warianty).3mf

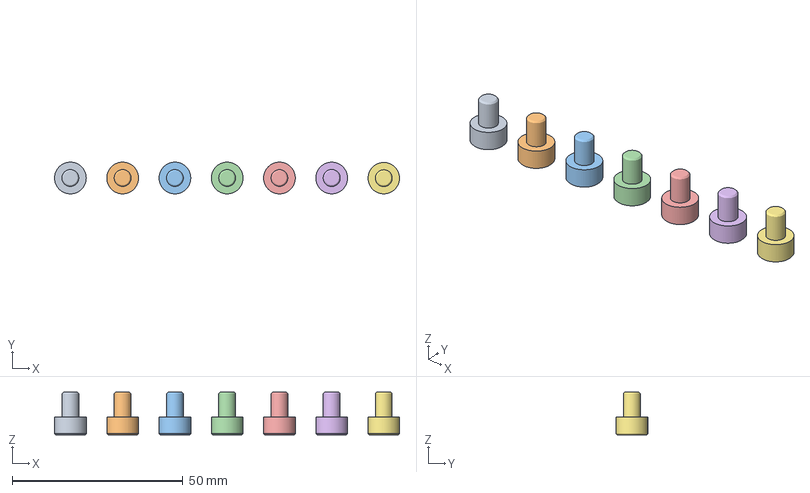
[picture p167: CAD file, 2026-10-28]
40-cad/3mf/Duze oko v3/Trzpien kardana M3 (2 + 2 zapas + warianty).3mf
101.0 x 9.30 x 12.4 mm
Trzpien kardana T4.95 K9.3 nr 1
Trzpien kardana T4.95 K9.3 nr 2
Trzpien kardana T4.95 K9.3 nr 3
Trzpien kardana T4.95 K9.3 nr 4
Trzpien kardana T4.9 K9.3
Trzpien kardana T5.0 K9.3
Trzpien kardana T4.95 K9.2
