senecjusz/Dynia-eyes/40-cad/3mf/Podstawka v2/Szuflada v2 - probka gniazda PIR.3mf

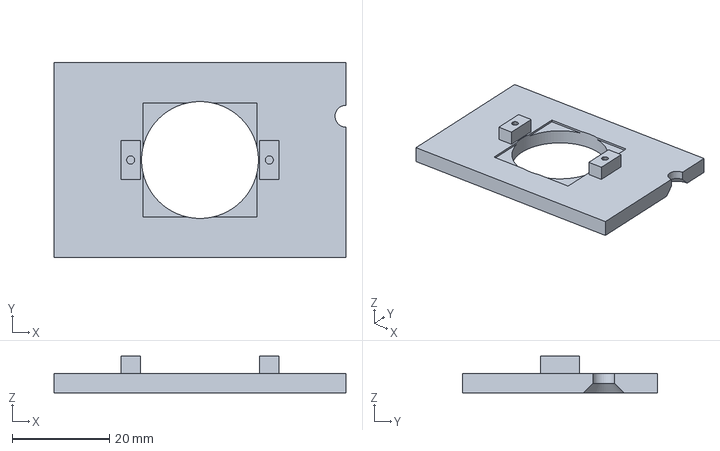
[picture p168: CAD file, 2026-10-25]
40-cad/3mf/Podstawka v2/Szuflada v2 - probka gniazda PIR.3mf
60.0 x 40.0 x 7.50 mm
