senecjusz/Dynia-eyes/40-cad/3mf/Duze oko v3/Powieka gorna.3mf

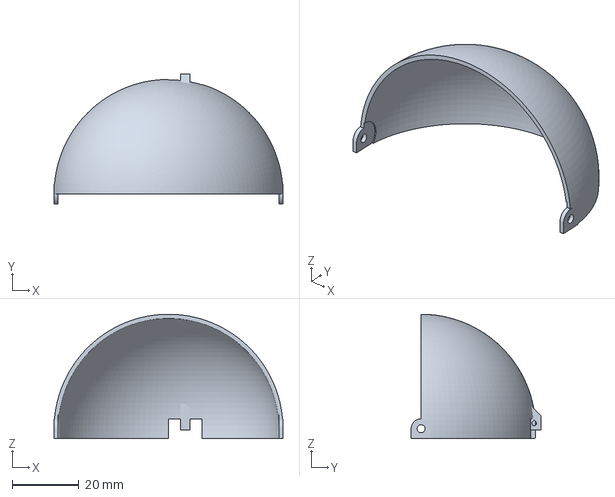
[picture p169: CAD file, 2026-10-28]
40-cad/3mf/Duze oko v3/Powieka gorna.3mf
68.8 x 39.0 x 37.4 mm
