senecjusz/Dynia-eyes/40-cad/3mf/Duze oko v3/Galka.3mf

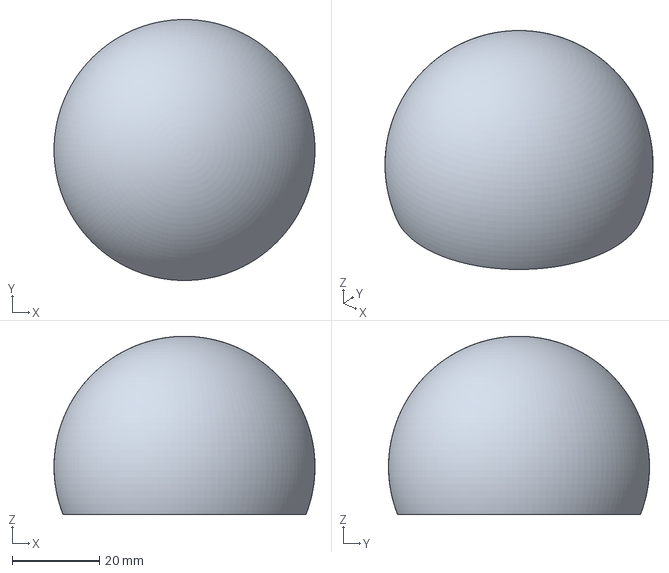
[picture p170: CAD file, 2026-10-26]
40-cad/3mf/Duze oko v3/Galka.3mf
60.0 x 60.0 x 41.0 mm
