senecjusz/Dynia-eyes/40-cad/3mf/Duze oko v3/Maskownica.3mf

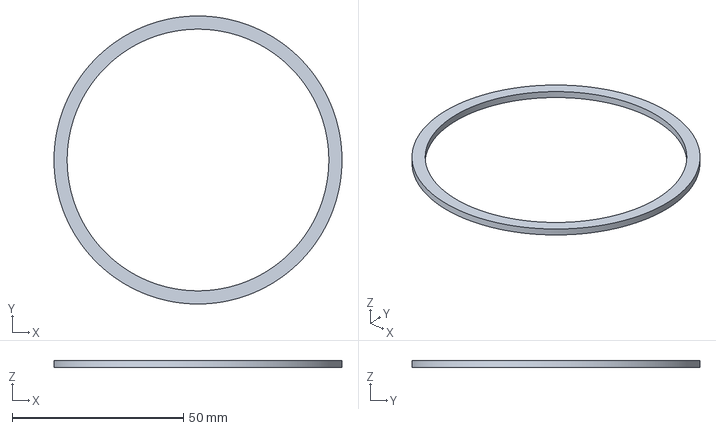
[picture p171: CAD file, 2026-10-26]
40-cad/3mf/Duze oko v3/Maskownica.3mf
84.0 x 84.0 x 2.00 mm
