senecjusz/Dynia-eyes/40-cad/3mf/Duze oko v3/Plyta.3mf

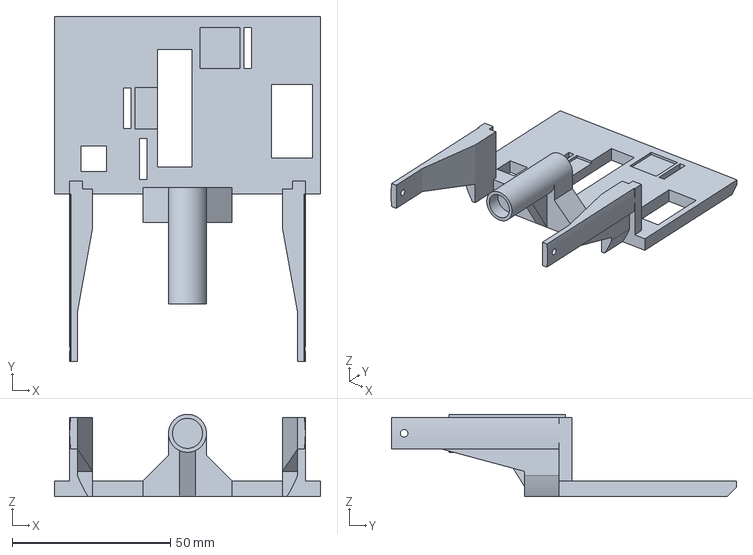
[picture p172: CAD file, 2026-10-26]
40-cad/3mf/Duze oko v3/Plyta.3mf
84.0 x 109.0 x 26.0 mm
