senecjusz/Dynia-eyes/40-cad/3mf/Duze oko v3/Podpora plyty (druk 45).3mf

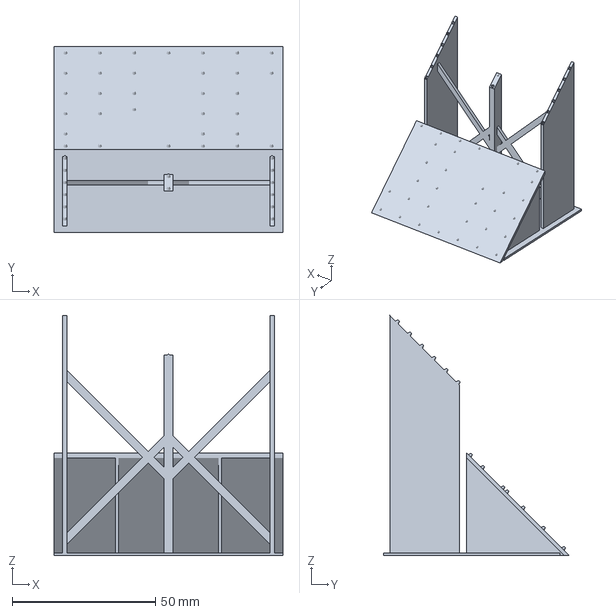
[picture p173: CAD file, 2026-10-26]
40-cad/3mf/Duze oko v3/Podpora plyty (druk 45).3mf
80.0 x 64.9 x 83.9 mm
