senecjusz/Dynia-eyes/40-cad/3mf/Duze oko v3/Plyta + podpora (druk 45).3mf

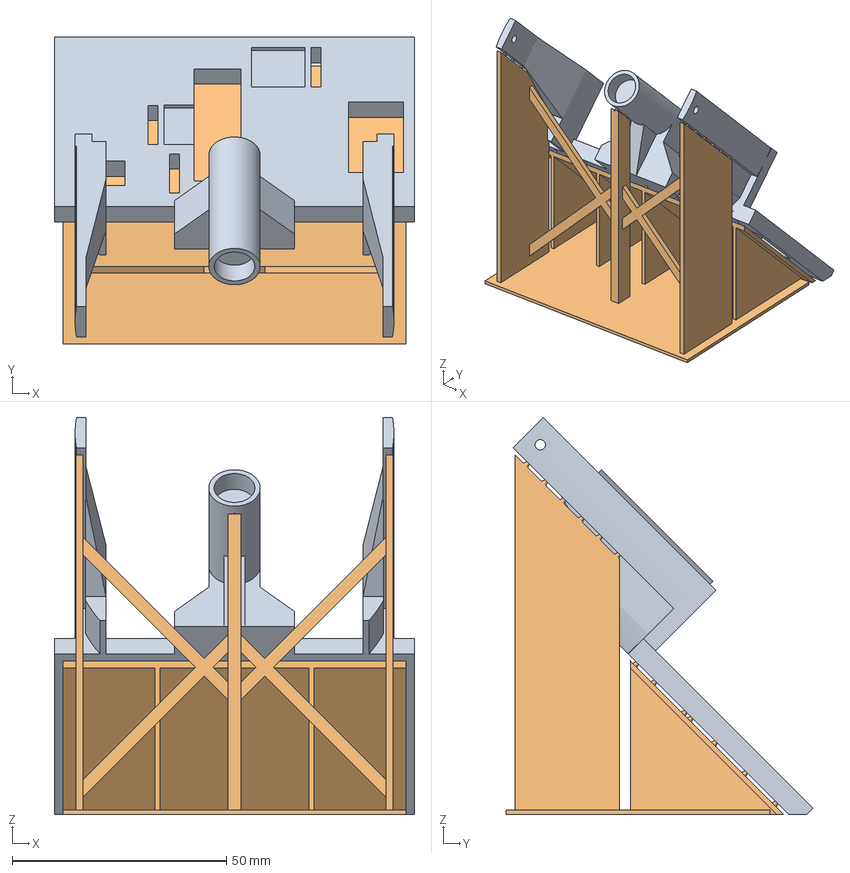
[picture p174: CAD file, 2026-10-26]
40-cad/3mf/Duze oko v3/Plyta + podpora (druk 45).3mf
84.0 x 71.6 x 92.6 mm
Plyta (druk 45)
Podpora plyty (druk 45)
