senecjusz/Dynia-eyes/50-elektronika/montaz-elektroniki/elementy.scad

// Elektronika na tacce v2 – model do instrukcji montażu i kontroli kolizji (sesja elektroniki, 28.10).
// Tacka: podstawka.scad z gałęzi wykonawca-montaz (commit 8a07059, podkładki ESP 7 mm), kopiowana obok przez eksport.sh.
// Układ tacki: x od lewego boku, y od przodu tacki, z od spodu tacki [mm]. Sufit = spód płyty górnej, 40 nad spodem tacki.
// Wymiary kupnych części: TYPOWE (nie mierzone) – listwa goldpin 2,5 plastiku, obudowa Dupont 2,5 × 2,5 × 14, wtyczka serwa 3-pin 2,5 × 7,6 × 14, kondensator Ø8 × 12,
// gniazdo USB-C z pomiarów użytkownika (kołnierz 14, korpus 13, gwint 11, nakrętka 15,5 × 3). Kanał 0 PCA po lewej – do sprawdzenia na płytce.
use <podstawka.scad>
grupa = "wszystko";

kDno = 2.4; SUFIT = 40;
// PCA9685 HW-170
pX = 75; pY = 45; pZ = kDno + 5; pT = 1.6; pTop = pZ + pT;           // płytka na słupkach 5
gp = 2.54; plast = 2.5; dup = 14;                                     // raster, plastik listwy, obudowa Dupont
function chX(i) = 81.9 + (i + floor(i / 4)) * gp;                     // kolumna kanału (4 grupy po 4)
rowY = [46.8, 46.8 + gp, 46.8 + 2 * gp];                              // od krawędzi: GND, V+, sygnał
function bokY(k) = 57.5 + (k - 2.5) * gp;                             // listwy boczne, 6 pinów: GND, OE, SCL, SDA, VCC, V+ (kolejność wg napisu)
bokXL = 77.3; bokXP = 134.7;
dupTop = pTop + plast + dup;                                          // 25,5 – wierzch wtyków na PCA
// ESP32-C3 SuperMini na podkładkach
eX0 = 15; eY0 = 16.5; eW = 18.4; eL = 22.5; eT = 1.2;
eZ = kDno + 16 + 7;                                                    // spód płytki 25,4
eRowX = [24.2 + 7.6, 24.2 - 7.6];                                      // [0] rząd prawy, od PCA (5,6,7,8,9,10,20,21); [1] rząd lewy, od ściany (5V,G,3V3,4,3,2,1,0) – widok z góry, układ scalony do góry, USB do przodu (pinout RNT, płytka od spodu przy USB u góry)
function eY(k) = 18.3 + k * gp;
eDupBot = eZ - plast - dup;                                            // 8,9 – spód wtyków pod ESP
// gniazdo USB-C
gX = 157.1; gY = 48; gZ = kDno + 18 / 2 + 1;                           // oś 12,4
// przycisk w prawej ściance podstawki (od środka)
bY = 83; bZ = 23;

module przewod(p, d = 1.3) for (i = [0 : len(p) - 2]) hull() { translate(p[i]) sphere(d = d, $fn = 8); translate(p[i + 1]) sphere(d = d, $fn = 8); }
module dupGora(x, y) { translate([x - 1.25, y - 1.25, pTop + plast]) cube([2.5, 2.5, dup]); }
module dupDol(x, y) { translate([x - 1.25, y - 1.25, eDupBot]) cube([2.5, 2.5, dup]); }
// przewód wchodzący od góry do wtyku na PCA: ostatnie punkty nad pinem
function doPCA(x, y) = [[x, y, dupTop + 3], [x, y, dupTop]];

// ---------- grupy ----------
module pca() {
  translate([pX, pY, pZ]) cube([62, 25, pT]);
}
module pcaListwy() {   // listwy goldpin (plastik i piny) bez wtyków
  for (i = [0:15], r = [0:2]) { translate([chX(i) - 1.25, rowY[r] - 1.25, pTop]) cube([2.5, 2.5, plast]); translate([chX(i) - 0.3, rowY[r] - 0.3, pTop]) cube([0.6, 0.6, plast + 6]); }
  for (x = [bokXL, bokXP], k = [0:5]) { translate([x - 1.25, bokY(k) - 1.25, pTop]) cube([2.5, 2.5, plast]); translate([x - 0.3, bokY(k) - 0.3, pTop]) cube([0.6, 0.6, plast + 6]); }
}
module zacisk() { translate([101, 62, pTop]) cube([10.2, 7.6, 10]); }
module podkladki() for (y = [16.5, 36]) translate([24.2 - 5.5, y, kDno + 16]) cube([11, 3, 7]);
module esp() {
  translate([eX0, eY0, eZ]) cube([eW, eL, eT]);
  translate([24.2 - 4.5, 15, eZ + eT]) cube([9, 7.5, 3.2]);           // gniazdo USB-C ESP
}
module espPiny() for (r = [0, 1], k = [0:7]) translate([eRowX[r] - 1.25, eY(k) - 1.25, eZ - plast]) cube([2.5, 2.5, plast]);
uzyteESP = [[1, 0], [1, 1], [1, 2], [1, 3], [1, 4], [0, 3], [0, 4], [0, 5]];   // [rząd, k]: 5V, G, 3V3, 4, 3 | 8, 9, 10 (5–6–7: wtyczka przycisku)
module espWtyki() for (u = uzyteESP) dupDol(eRowX[u[0]], eY(u[1]));
module gniazdo() {
  translate([gX, gY - 2, gZ]) rotate([-90, 0, 0]) cylinder(d = 14, h = 2, $fn = 32);     // kołnierz przed ścianką
  translate([gX, gY, gZ]) rotate([-90, 0, 0]) cylinder(d = 11, h = 13, $fn = 32);       // korpus przez ściankę
  translate([gX, gY + 3, gZ]) rotate([-90, 0, 0]) cylinder(d = 15.5 / cos(30), h = 3, $fn = 6);   // nakrętka
}
module wtykCC() translate([gX - 6, 18, gZ - 3.5]) cube([12, 28, 7]);
module zasilanie(kolor) {   // 0 czerwony → V+, 1 czarny → GND (śruby zacisku: wg napisu)
  xs = [108.6, 103.5];
  przewod([[gX + (kolor ? 1.5 : -1.5), 61, gZ], [150, 88, 6], [130, 88 + (kolor ? 2 : 0), 6], [xs[kolor], 80, 14], [xs[kolor], 70.5, 14]], 1.6);
}
// trasy pod ESP (spód wtyków 8,9): pion z pinu, potem warstwy z – 3,6 (5V, G, 3V3 pod resztą), 5 (zgięcia, PIR OUT, zapas), 6,4 (SDA, przycisk), 7,8 (SCL);
// słupki z podkładkami zajmują x 18,7–29,7 przy y 16,5–19,5 i 36–40,8 – przejście pod płytką tylko między nimi
function zPin(k, r, z) = [[eRowX[r], eY(k), eDupBot], [eRowX[r], eY(k), z]];
module espPCA(n) {   // 0: 5V→9 V+, 1: G→9 GND, 2: 3V3→VCC (rząd lewy, pod ESP do prawej), 3: 8→SDA, 4: 9→SCL (rząd prawy, od razu w prawo)
  if (n == 0) przewod(concat(zPin(0, 1, 5), [[19.2, 21.6, 5], [24, 24, 3.6], [45, 30, 3.6], [100, 38, 3.6], [chX(9) + 0.4, 40, dupTop + 3]], doPCA(chX(9) + 0.4, rowY[1])));
  if (n == 1) przewod(concat(zPin(1, 1, 5), [[19.2, 24.14, 5], [24, 26.5, 3.6], [45, 32.5, 3.6], [98, 40, 3.6], [chX(9) - 0.4, 42, dupTop + 3]], doPCA(chX(9) - 0.4, rowY[0])));
  if (n == 2) przewod(concat(zPin(2, 1, 5), [[19.2, 26.7, 5], [24, 29, 3.6], [34, 33, 3.6], [45, 45, 3.6], [70, bokY(4), 3.6], [bokXL - 3, bokY(4), dupTop + 3]], doPCA(bokXL, bokY(4))));
  if (n == 3) przewod(concat(zPin(3, 0, 6.4), [[38, eY(3), 6.4], [48, 45, 6.4], [70, bokY(3), 6.4], [bokXL - 3, bokY(3), dupTop + 4]], doPCA(bokXL, bokY(3))));
  if (n == 4) przewod(concat(zPin(4, 0, 7.8), [[40, eY(4), 7.8], [47, 43, 7.8], [70, bokY(2), 7.8], [bokXL - 3, bokY(2), dupTop + 5]], doPCA(bokXL, bokY(2))));
}
module espPCAwtyki() { dupGora(chX(9), rowY[0]); dupGora(chX(9), rowY[1]); for (k = [2:4]) dupGora(bokXL, bokY(k)); }
module kondensator() {
  for (r = [0, 1]) przewod([[chX(8), rowY[r], dupTop], [chX(8), rowY[r], dupTop + 2], [chX(8) + (r ? 1 : -1), 40, dupTop + 4]], 0.7);
  translate([chX(8), 40, dupTop + 4]) rotate([90, 0, 0]) cylinder(d = 8, h = 12, $fn = 32);
}
module kondWtyki() for (r = [0, 1]) dupGora(chX(8), rowY[r]);
module pir(n) {   // 0 VCC → 10 V+, 1 GND → 10 GND, 2 OUT → ESP 10
  if (n < 2) przewod(concat([[150, 10, 5], [142, 10 + n, 5], [125, 30, 5], [chX(10) + (n ? -0.4 : 0.4), 40, dupTop + 3]], doPCA(chX(10) + (n ? -0.4 : 0.4), rowY[1 - n])));
  if (n == 2) przewod(concat([[150, 9, 5], [142, 9, 5], [138, 22, 5], [45, eY(5), 5]], [[eRowX[0], eY(5), 5], [eRowX[0], eY(5), eDupBot]]));   // do pinu 10 od prawej, pod SDA/SCL
}
module pirWtyki() { dupGora(chX(10), rowY[0]); dupGora(chX(10), rowY[1]); }
module przycisk() translate([151, bY, bZ]) rotate([0, 90, 0]) cylinder(d = 15, h = 20, $fn = 32);
// przycisk (użytkownik 28.10): gotowy przewód, dwa przewody na skrajnych pozycjach wtyczki Dupont 3-pin, środek pusty;
// wtyczka wprost na ESP, rząd prawy (od PCA), pozycje 1–3 od USB = GPIO5 (masa, program LOW), GPIO6 (pusty), GPIO7 (odczyt); bez połączenia z PCA
module przyciskPrzew(n) {   // 0: GPIO5 (masa, czarny), 1: GPIO7 (odczyt, pomarańczowy); pod ESP ukosem między słupkami do lewej ściany (z 6,4, nad 5V/G/3V3)
  d = n ? 0 : 1.4;
  przewod(concat(n ? zPin(2, 0, 6.4) : concat(zPin(0, 0, 6.4), [[31, 21, 6.4]]),
    [[eRowX[1], n ? 34.8 : 32.3, 6.4], [12 - d, n ? 38.5 : 37, 6], [13 - d, 45 + d, 6], [45, 55 + d, 10], [70, 82 + d, 14], [120, 82 + d, 20], [151, bY - 3 + 6 * n, bZ]]));
}
module przyciskWtyczka() translate([eRowX[0] - 1.25, eY(1) - 3.8, eDupBot]) cube([2.5, 7.6, dup]);   // obudowa 3-pin 2,5 × 7,6 × 14 na pinach 5–6–7
module zapasESP() for (k = [3, 4]) przewod(concat(zPin(k, 1, 5), [[11, eY(k) - 1.9, 5]]));   // GPIO4 (k 3), GPIO3 (k 4): krótko w stronę lewej ściany, końce zaizolowane
// skrętki: s = 0 lewa (ch 0–3), 1 prawa (4–7), 2 duże oko (12–15)
// Strona PCA (użytkownik 28.10): żyły przylutowane do 4 wtyczek odciętych od serw (A–D na kanały n…n+3),
// każda wtyczka z ok. 5 cm własnego przewodu (brązowy GND, czerwony V+, pomarańczowy sygnał) do lutu w koszulce.
// B i D: tylko pomarańczowy; brązowy i czerwony obcięte przy wtyczce i zaizolowane.
sk = [[50, 55, 0], [63, 75, 4], [76, 95, 12]];   // x nad otworem, x uchwytu, n
function skCh(s) = sk[s][2];
function skXg(s) = (chX(skCh(s)) + chX(skCh(s) + 3)) / 2;
function skTr(s, t) = [sk[s][1] + t * (skXg(s) - sk[s][1]), 20 + t * 16, 5 + t * (dupTop + 1)];   // trasa od uchwytu do grupy kanałów
skWt = [[0, 0, 5], [0, 1, 4], [0, 2, 1], [1, 2, 2], [2, 0, 8], [2, 1, 7], [2, 2, 3], [3, 2, 6]];   // [wtyczka 0..3 = A..D, pin 0 brązowy / 1 czerwony / 2 pomarańczowy, żyła]
wtW = 7.6; wtT = 2.5; kosL = 8;                                       // obudowa wtyczki serwa 3-pin (typowa), długość koszulki na lucie
function skLut(s, k) = [skXg(s) + (k - 3.5) * 1.8, k % 2 ? 26 : 33, s == 2 ? 20 : 12];   // środek lutu k: przed grupą kanałów, dwa rzędy (duże oko wyżej – nad przewodami PIR)
function zWyj(r) = dupTop + 3 + r * 1.3;                               // przewód wtyczki nad obudową: sygnał najwyżej, wierzch 31,6 (rozdz. 3: zgięcie ok. 6)
module skretkaPlaszcz(s) przewod([[sk[s][0], 6, SUFIT], [sk[s][1], 9, 12], [sk[s][1], 12, 4.9], [sk[s][1], 20, 5], skTr(s, 0.1)], 5);   // płaszcz zdjęty ok. 80 mm
module skretkaWtyczki(s) for (i = [0:3]) translate([chX(skCh(s) + i) - wtT / 2, rowY[1] - wtW / 2, pTop + plast]) cube([wtT, wtW, dup]);
module skPrzewodWt(s, k) {   // przewód wtyczki: od obudowy do lutu
  w = skWt[k]; x = chX(skCh(s) + w[0]); L = skLut(s, k);
  przewod([[x, rowY[w[1]], dupTop], [x, rowY[w[1]], zWyj(w[1])], [x, 43, zWyj(w[1])], [L[0], L[1] + kosL / 2 + 1, L[2]], [L[0], L[1], L[2]]], 1);
}
module skKikut(s, i, r) { x = chX(skCh(s) + i); przewod([[x, rowY[r], dupTop], [x, rowY[r], dupTop + 2]], 1); }   // B, D: obcięty brązowy / czerwony
module skPrzewody(r) for (s = [0:2]) { for (k = [0:7]) if (skWt[k][1] == r) skPrzewodWt(s, k); if (r < 2) for (i = [1, 3]) skKikut(s, i, r); }
module skKoszulki() for (s = [0:2]) {
  for (k = [0:7]) { L = skLut(s, k); translate([L[0], L[1] - kosL / 2, L[2]]) rotate([-90, 0, 0]) cylinder(d = 2.2, h = kosL, $fn = 12); }
  for (i = [1, 3], r = [0, 1]) translate([chX(skCh(s) + i), rowY[r], dupTop + 1.5]) cylinder(d = 1.5, h = 1.5, $fn = 12);   // izolacja obciętych końców
}
module skretkaZyla(s, z) for (k = [0:7]) if (skWt[k][2] == z) { L = skLut(s, k); przewod([skTr(s, 0.1), [L[0], L[1] - kosL / 2 - 1, L[2]], [L[0], L[1], L[2]]], 0.9); }
module rezystor() {
  translate([32, 72, kDno + 8 + 3]) rotate([-90, 0, 0]) cylinder(d = 6, h = 17, $fn = 24);
  translate([32, 64, kDno + 8 + 3]) rotate([-90, 0, 0]) cylinder(d = 0.9, h = 37, $fn = 8);   // nóżki: tylna wychodzi za tylny słupek
}
module sufit() translate([0, 0, SUFIT]) cube([170, 100, 0.4]);

// ---------- wybór ----------
if (grupa == "tacka") kaseta();
else if (grupa == "sufit") sufit();
else if (grupa == "pca") pca();
else if (grupa == "pcaListwy") pcaListwy();
else if (grupa == "zacisk") zacisk();
else if (grupa == "podkladki") podkladki();
else if (grupa == "esp") esp();
else if (grupa == "espPiny") espPiny();
else if (grupa == "espWtyki") espWtyki();
else if (grupa == "gniazdo") gniazdo();
else if (grupa == "wtykCC") wtykCC();
else if (grupa == "zasilCzerw") zasilanie(0);
else if (grupa == "zasilCzarny") zasilanie(1);
else if (grupa == "esp5V") espPCA(0);
else if (grupa == "espG") espPCA(1);
else if (grupa == "espI2C") { espPCA(2); espPCA(3); espPCA(4); }
else if (grupa == "espPCAwtyki") espPCAwtyki();
else if (grupa == "kondensator") kondensator();
else if (grupa == "kondWtyki") kondWtyki();
else if (grupa == "pirVCC") pir(0);
else if (grupa == "pirGND") pir(1);
else if (grupa == "pirOUT") pir(2);
else if (grupa == "pirWtyki") pirWtyki();
else if (grupa == "przycisk") przycisk();
else if (grupa == "przyciskMasa") przyciskPrzew(0);
else if (grupa == "przyciskSyg") przyciskPrzew(1);
else if (grupa == "przyciskWtyczka") przyciskWtyczka();
else if (grupa == "zapasESP") zapasESP();
else if (grupa == "skL") { skretkaPlaszcz(0); }
else if (grupa == "skP") { skretkaPlaszcz(1); }
else if (grupa == "skD") { skretkaPlaszcz(2); }
else if (grupa == "skWtyczki") for (s = [0:2]) skretkaWtyczki(s);
else if (grupa == "skPrzewBraz") skPrzewody(0);
else if (grupa == "skPrzewCzerw") skPrzewody(1);
else if (grupa == "skPrzewPom") skPrzewody(2);
else if (grupa == "skKoszulki") skKoszulki();
else if (grupa == "skZyla1") for (s = [0:2]) skretkaZyla(s, 1);
else if (grupa == "skZyla2") for (s = [0:2]) skretkaZyla(s, 2);
else if (grupa == "skZyla3") for (s = [0:2]) skretkaZyla(s, 3);
else if (grupa == "skZyla4") for (s = [0:2]) skretkaZyla(s, 4);
else if (grupa == "skZyla5") for (s = [0:2]) skretkaZyla(s, 5);
else if (grupa == "skZyla6") for (s = [0:2]) skretkaZyla(s, 6);
else if (grupa == "skZyla7") for (s = [0:2]) skretkaZyla(s, 7);
else if (grupa == "skZyla8") for (s = [0:2]) skretkaZyla(s, 8);
else if (grupa == "rezystor") rezystor();
// kontrola kolizji: elementy, które nie mogą wchodzić w tackę ani w sufit
else if (grupa == "kolizjaTacka") intersection() { kaseta(); union() { espWtyki(); esp(); kondensator(); przycisk(); przyciskWtyczka(); pca(); for (s = [0:2]) skretkaWtyczki(s); espPCAwtyki(); zacisk(); } }
else if (grupa == "kolizjaSufit") intersection() { translate([0, 0, SUFIT]) cube([170, 100, 30]); union() { esp(); kondensator(); for (s = [0:2], z = [1:8]) skretkaZyla(s, z); for (r = [0:2]) skPrzewody(r); skKoszulki(); espPCA(0); espPCA(1); espPCA(2); espPCA(3); espPCA(4); pir(0); pir(1); pir(2); przyciskPrzew(0); przyciskPrzew(1); zapasESP(); } }
else if (grupa == "kolizjaRezystor") intersection() { kaseta(); rezystor(); }
