senecjusz/Dynia-eyes/(list of files, cad)

Other CAD files:
40-cad/archiwum/v1/nakretka-v1.stl
40-cad/3mf/Duze oko v1/eksport-2026-10-23/Duże oko v1 - Gałka.3mf
40-cad/3mf/Duze oko v1/eksport-2026-10-23/Duże oko v1 - Obejma.3mf
40-cad/3mf/Duze oko v1/eksport-2026-10-23/Duże oko v1 - P4 Krzyżak G.3mf
40-cad/3mf/Duze oko v1/eksport-2026-10-23/Duże oko v1 - P4 Krzyżak O.3mf
40-cad/3mf/Duze oko v1/eksport-2026-10-23/Duże oko v1 - P4 Pręt.3mf
40-cad/3mf/Duze oko v1/eksport-2026-10-23/Duże oko v1 - P4 Widełki pręta O.3mf
40-cad/3mf/Duze oko v1/eksport-2026-10-23/Duże oko v1 - P4 Widełki stałe G.3mf
40-cad/3mf/Duze oko v1/eksport-2026-10-23/Duże oko v1 - P4 Widełki stałe O.3mf
40-cad/3mf/Duze oko v1/eksport-2026-10-23/Duże oko v1 - Powieka dolna.3mf
40-cad/3mf/Duze oko v1/eksport-2026-10-23/Duże oko v1 - Powieka górna.3mf
40-cad/3mf/Duze oko v1/eksport-2026-10-23/Duże oko v1 - Przyrząd gięcia drutów.3mf
40-cad/3mf/Duze oko v1/eksport-2026-10-23/Duże oko v1 - Przyrząd zera.3mf
40-cad/3mf/Duze oko v1/eksport-2026-10-23/Duże oko v1 - Próbka P6.3mf
40-cad/3mf/Duze oko v1/eksport-2026-10-23/Duże oko v1 - Płyta.3mf
40-cad/3mf/Duze oko v1/eksport-2026-10-23/Duże oko v1 - Rama.3mf
40-cad/3mf/Duze oko v1/eksport-2026-10-23/Duże oko v1 - Ramię PD.3mf
40-cad/3mf/Duze oko v1/eksport-2026-10-23/Duże oko v1 - Ramię PG.3mf
40-cad/3mf/Duze oko v1/eksport-2026-10-23/Duże oko v1 - Słupek.3mf
40-cad/3mf/Duze oko v1/eksport-2026-10-23/Duże oko v1 - Uchwyt.3mf
40-cad/3mf/Duze oko v1/eksport-2026-10-23/Duże oko v1 - Łapa Uchwytu 210.3mf
40-cad/3mf/Duze oko v1/eksport-2026-10-23/Duże oko v1 - Łapa Uchwytu 330.3mf
40-cad/3mf/Duze oko v1/eksport-2026-10-23b/Duże oko v1 - Gałka.3mf
40-cad/3mf/Duze oko v1/eksport-2026-10-23b/Duże oko v1 - Krzyżak gałki Y.3mf
40-cad/3mf/Duze oko v1/eksport-2026-10-23b/Duże oko v1 - Krzyżak orczyka Y.3mf
40-cad/3mf/Duze oko v1/eksport-2026-10-23b/Duże oko v1 - Obejma.3mf
40-cad/3mf/Duze oko v1/eksport-2026-10-23b/Duże oko v1 - P4 Krzyżak G.3mf
40-cad/3mf/Duze oko v1/eksport-2026-10-23b/Duże oko v1 - P4 Krzyżak O.3mf
40-cad/3mf/Duze oko v1/eksport-2026-10-23b/Duże oko v1 - P4 Pręt.3mf
40-cad/3mf/Duze oko v1/eksport-2026-10-23b/Duże oko v1 - P4 Widełki pręta O.3mf
40-cad/3mf/Duze oko v1/eksport-2026-10-23b/Duże oko v1 - P4 Widełki stałe G.3mf
40-cad/3mf/Duze oko v1/eksport-2026-10-23b/Duże oko v1 - P4 Widełki stałe O.3mf
40-cad/3mf/Duze oko v1/eksport-2026-10-23b/Duże oko v1 - Powieka dolna.3mf
40-cad/3mf/Duze oko v1/eksport-2026-10-23b/Duże oko v1 - Powieka górna.3mf
40-cad/3mf/Duze oko v1/eksport-2026-10-23b/Duże oko v1 - Przyrząd gięcia drutów.3mf
40-cad/3mf/Duze oko v1/eksport-2026-10-23b/Duże oko v1 - Przyrząd zera.3mf
40-cad/3mf/Duze oko v1/eksport-2026-10-23b/Duże oko v1 - Próbka P6.3mf
40-cad/3mf/Duze oko v1/eksport-2026-10-23b/Duże oko v1 - Pręt Y.3mf
40-cad/3mf/Duze oko v1/eksport-2026-10-23b/Duże oko v1 - Płyta.3mf
40-cad/3mf/Duze oko v1/eksport-2026-10-23b/Duże oko v1 - Rama.3mf
40-cad/3mf/Duze oko v1/eksport-2026-10-23b/Duże oko v1 - Ramię PD.3mf
40-cad/3mf/Duze oko v1/eksport-2026-10-23b/Duże oko v1 - Ramię PG.3mf
40-cad/3mf/Duze oko v1/eksport-2026-10-23b/Duże oko v1 - Ramię X.3mf
40-cad/3mf/Duze oko v1/eksport-2026-10-23b/Duże oko v1 - Ramię Y.3mf
40-cad/3mf/Duze oko v1/eksport-2026-10-23b/Duże oko v1 - Słupek.3mf
40-cad/3mf/Duze oko v1/eksport-2026-10-23b/Duże oko v1 - Uchwyt.3mf
40-cad/3mf/Duze oko v1/eksport-2026-10-23b/Duże oko v1 - Widełki pręta przy orczyku Y.3mf
40-cad/3mf/Duze oko v1/eksport-2026-10-23b/Duże oko v1 - Łapa Uchwytu 210.3mf
40-cad/3mf/Duze oko v1/eksport-2026-10-23b/Duże oko v1 - Łapa Uchwytu 330.3mf
40-cad/3mf/Duze oko v1/eksport-2026-10-23b/stl/Duże oko v1 - Gałka.stl
40-cad/3mf/Duze oko v1/eksport-2026-10-23b/stl/Duże oko v1 - Krzyżak gałki Y.stl
40-cad/3mf/Duze oko v1/eksport-2026-10-23b/stl/Duże oko v1 - Krzyżak orczyka Y.stl
40-cad/3mf/Duze oko v1/eksport-2026-10-23b/stl/Duże oko v1 - Obejma.stl
40-cad/3mf/Duze oko v1/eksport-2026-10-23b/stl/Duże oko v1 - P4 Krzyżak G.stl
40-cad/3mf/Duze oko v1/eksport-2026-10-23b/stl/Duże oko v1 - P4 Krzyżak O.stl
40-cad/3mf/Duze oko v1/eksport-2026-10-23b/stl/Duże oko v1 - P4 Pręt.stl
40-cad/3mf/Duze oko v1/eksport-2026-10-23b/stl/Duże oko v1 - P4 Widełki pręta O.stl
40-cad/3mf/Duze oko v1/eksport-2026-10-23b/stl/Duże oko v1 - P4 Widełki stałe G.stl
40-cad/3mf/Duze oko v1/eksport-2026-10-23b/stl/Duże oko v1 - P4 Widełki stałe O.stl
40-cad/3mf/Duze oko v1/eksport-2026-10-23b/stl/Duże oko v1 - Powieka dolna.stl
40-cad/3mf/Duze oko v1/eksport-2026-10-23b/stl/Duże oko v1 - Powieka górna.stl
40-cad/3mf/Duze oko v1/eksport-2026-10-23b/stl/Duże oko v1 - Przyrząd gięcia drutów.stl
40-cad/3mf/Duze oko v1/eksport-2026-10-23b/stl/Duże oko v1 - Przyrząd zera.stl
40-cad/3mf/Duze oko v1/eksport-2026-10-23b/stl/Duże oko v1 - Próbka P6.stl
40-cad/3mf/Duze oko v1/eksport-2026-10-23b/stl/Duże oko v1 - Pręt Y.stl
40-cad/3mf/Duze oko v1/eksport-2026-10-23b/stl/Duże oko v1 - Płyta.stl
40-cad/3mf/Duze oko v1/eksport-2026-10-23b/stl/Duże oko v1 - Rama.stl
40-cad/3mf/Duze oko v1/eksport-2026-10-23b/stl/Duże oko v1 - Ramię PD.stl
40-cad/3mf/Duze oko v1/eksport-2026-10-23b/stl/Duże oko v1 - Ramię PG.stl
40-cad/3mf/Duze oko v1/eksport-2026-10-23b/stl/Duże oko v1 - Ramię X.stl
40-cad/3mf/Duze oko v1/eksport-2026-10-23b/stl/Duże oko v1 - Ramię Y.stl
40-cad/3mf/Duze oko v1/eksport-2026-10-23b/stl/Duże oko v1 - Słupek.stl
40-cad/3mf/Duze oko v1/eksport-2026-10-23b/stl/Duże oko v1 - Uchwyt.stl
40-cad/3mf/Duze oko v1/eksport-2026-10-23b/stl/Duże oko v1 - Widełki pręta przy orczyku Y.stl
40-cad/3mf/Duze oko v1/eksport-2026-10-23b/stl/Duże oko v1 - Łapa Uchwytu 210.stl
40-cad/3mf/Duze oko v1/eksport-2026-10-23b/stl/Duże oko v1 - Łapa Uchwytu 330.stl
40-cad/3mf/Duze oko v2/Duze oko v2 - wszystkie czesci.3mf
40-cad/3mf/Duze oko v2/Galka.3mf
40-cad/3mf/Duze oko v2/Maskownica.3mf
40-cad/3mf/Duze oko v2/Pierscien.3mf
40-cad/3mf/Duze oko v2/Powieka dolna.3mf
40-cad/3mf/Duze oko v2/Powieka gorna.3mf
40-cad/3mf/Duze oko v2/Probka drutu.3mf
40-cad/3mf/Duze oko v2/Przedluzenie orczyka x2.3mf
40-cad/3mf/Duze oko v2/Uchwyt serw.3mf
40-cad/3mf/Oko F v2.2/Oko F v2.2 - Ciegno.3mf
40-cad/3mf/Oko F v2.2/Oko F v2.2 - Gniazdo.3mf
40-cad/3mf/Oko F v2.2/Oko F v2.2 - Jarzmo z miska.3mf
40-cad/3mf/Oko F v2.2/Oko F v2.2 - Kaseta.3mf
40-cad/3mf/Oko F v2.2/Oko F v2.2 - Nakretka.3mf
40-cad/3mf/Oko F v2.2/Oko F v2.2 - PODGLAD SG90.3mf
40-cad/3mf/Oko F v2.2/Oko F v2.2 - PODGLAD orczyk SG90.3mf
40-cad/3mf/Oko F v2.2/Oko F v2.2 - PODGLAD pileczka 40.5.3mf
40-cad/3mf/Oko F v2.2/Oko F v2.2 - Pokrywa tylna.3mf
40-cad/3mf/Oko F v2.2/Oko F v2.2 - Probka gwintu - gniazdo.3mf
40-cad/3mf/Oko F v2.2/Oko F v2.2 - Probka gwintu - nakretka.3mf
40-cad/3mf/Oko F v2.2/Oko F v2.2 - Przyrzad centrowania orczyka.3mf
40-cad/3mf/Oko F v2.2/Oko F v2.2 - Przyrzad do wklejania pileczki.3mf
40-cad/3mf/Oko F v2.2/Oko F v2.2 - Ramie orczyka.3mf
40-cad/3mf/Oko F v2.2/Oko F v2.2 - Sanki serwa.3mf
40-cad/3mf/Oko F v2.2/Oko F v2.2 - Tulejka przegubu korby.3mf
40-cad/3mf/Oko F v2.2/Oko F v2.2 - Tulejka przegubu ramienia.3mf
40-cad/3mf/Oko F v2.3/Oko F v2.3 - Ciegno.3mf
40-cad/3mf/Oko F v2.3/Oko F v2.3 - Gniazdo.3mf
40-cad/3mf/Oko F v2.3/Oko F v2.3 - Jarzmo z miska.3mf
40-cad/3mf/Oko F v2.3/Oko F v2.3 - Kaseta.3mf
40-cad/3mf/Oko F v2.3/Oko F v2.3 - Nakretka.3mf
40-cad/3mf/Oko F v2.3/Oko F v2.3 - PODGLAD SG90.3mf
40-cad/3mf/Oko F v2.3/Oko F v2.3 - PODGLAD orczyk SG90.3mf
40-cad/3mf/Oko F v2.3/Oko F v2.3 - PODGLAD pileczka 40.5.3mf
40-cad/3mf/Oko F v2.3/Oko F v2.3 - Pokrywa tylna.3mf
40-cad/3mf/Oko F v2.3/Oko F v2.3 - Probka gwintu - gniazdo.3mf
40-cad/3mf/Oko F v2.3/Oko F v2.3 - Probka gwintu - nakretka luz 0.6.3mf
40-cad/3mf/Oko F v2.3/Oko F v2.3 - Przyrzad centrowania orczyka.3mf
40-cad/3mf/Oko F v2.3/Oko F v2.3 - Przyrzad do wklejania pileczki.3mf
40-cad/3mf/Oko F v2.3/Oko F v2.3 - Ramie orczyka.3mf
40-cad/3mf/Oko F v2.3/Oko F v2.3 - Sanki serwa.3mf
40-cad/3mf/Oko F v2.3/Oko F v2.3 - Tulejka przegubu korby.3mf
40-cad/3mf/Oko F v2.3/Oko F v2.3 - Tulejka przegubu ramienia.3mf
40-cad/3mf/Oko F v2.4/Oko F v2.4 - Ciegno.3mf
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
