senecjusz/Dynia-eyes/(commit log)

2026-10-17 Nowy układ folderów: inbox, inspiracje, analizy, projekt, cad, elektronika, firmware, budowa
2026-10-17 Prawdziwa dynia; inspiracja Kent Harris – małe oko z powieką
2026-10-17 Poziomy jako złożoność; duże oko w podpoziomach 2a–2c
2026-10-17 Analizy: wymiary modułu małego oka, zasilanie z powerbanku
2026-10-17 Powerbanki w domu, koncepcja pudełka elektroniki jako podstawy dyni
2026-10-17 Drukarki A1 mini i X1C, komplet śrub M3–M5 z nakrętkami
2026-10-17 Oko F v1: model w Onshape (SimpleEye), skrypt budujacy, STL do druku testowego
    Gniazdo z rantem i gwintem, nakretka, tuleja modulu z bagnetem i zatrzaskiem,
    jarzmo C, czopy, ciegno. Zmienne #... w Part Studio, kolizje sprawdzone.
    [gniazdo-v1.stl, modul-ciegno-v1.stl, modul-czop-v1.stl, modul-jarzmo-v1.stl, modul-tuleja-v1.stl, nakretka-v1.stl]
2026-10-17 Lista kontrolna review CAD przed wydrukiem
2026-10-17 Decyzja: kontroler Arduino Nano, zapas ESP32/RPi/Uno/Mega
2026-10-17 Radar: ESP32 zamiast Mega (3,3 V, UART 256k), wyjaśnienie
2026-10-17 Najprostsze wykrywanie: HC-SR04, 50 cm = oczy patrzą na wprost
2026-10-17 Duże oko śledzi ruch: LD2450 + ESP32, góra–dół z odległości
2026-10-17 Ustalenia 18.10: duże oko w tym roku, ESP32 z kalibracją przez telefon, radar LD2450, drukarki
2026-10-17 Oko F v1.1: pileczka 39.5-40.5, naped bez martwego punktu (ramie orczyka 22 mm, +-30 st.), rant 68x1.5, STL z dokladna siatka; v1 do archiwum
    Luzy zmierzone na eksporcie (0.01 mm / 3 st.): bagnet 0.59 mm, gwint 0.29 mm.
    Ruch -30..+30 st. bez kolizji (test na siatkach).
    [gniazdo-v1.1.stl, gniazdo-v1.stl, modul-ciegno-v1.1.stl, modul-ciegno-v1.stl, modul-czop-v1.1.stl, modul-czop-v1.stl, modul-jarzmo-v1.1.stl, modul-jarzmo-v1.stl]
2026-10-18 Oko F v2 (do review): os i przeguby na M3, bagnet z jezykami, ograniczniki +-33, przyrzady
    Onshape SimpleEye, galaz v2 (wersje v1.1 i "v2 do review"): Part Studio "Oko F v2"
    (15 czesci w 20 folderach), Variable Studio "Zmienne v2", Assembly "Oko F v2 - zlozenie".
    Plan, polaczenia, kinematyka, wyniki symulacji kolizji i niepewnosci:
    30-projekt/plan-v2-modul-oka.md. Skrypty budowy i sprawdzenia w 40-cad/onshape/.
2026-10-18 Oko F v2.1 (do review): obudowa bez bagnetu, pileczka wklejona w miske
    - Onshape: wersja "v2.1 do review" w galezi v2 (Part Studio Oko F v2.1, Assembly Oko F v2.1 - zlozenie)
    - otwor w dyni 57, rant 63, nakretka 66; wnetrze 48.5; os 2 x M3x5 ISO 7380
    - symulacja +-33: bez przenikan; wybranie w sciance na przegub H
    - plan, README, decyzje; skrypt oko-f-v2.1-build.js
2026-10-18 Oko F v2.1b: klej 0.5 mm, naped w Assembly rusza z pileczka
    - zmienna klej 0.5 (klej akrylowy 2K); przyrzad do wklejania sterowany zmiennymi
    - Assembly: limit walu serwa -37..+30 (bez drugiej galezi czworoboku), przegub C Revolute
    - symulacja +-33 bez przenikan; wersja Onshape "v2.1b do review"
2026-10-18 Assembly v2.1b: limity mate z wartoscia (Animate dziala), opis jak pokazac naped
2026-10-18 Oko F v2.1c (do review): jarzmo bez podpor, luz gwintu 0.5 + Probka gwintu, kabel SG90
    - jarzmo: plaski bok miski na stol, korba zrosnieta na calej szerokosci pasa, piasta C fi 10 kropla 45 st., oczka 2.4
    - luzGwint 0.5, nowe czesci Probka gwintu (pierscien + kawalek nakretki)
    - kabel SG90 od strony walka, pokrywa z otworem dziurka od klucza na wtyczke 3-pin
    - symulacja +-33 bez przenikan; wersja Onshape "v2.1c do review"
2026-10-18 Oko F v2.1d (do review): otwor w dyni pod otwornice 56
    - przodD 55.6 (luz 0.2/str.), gwint 54.9 (0.55/str.), za rantem nic szerszego niz 55.6
    - rant 63 bez zmian (zakladka 3.5 mm, zabki 1.5 mm od krawedzi otworu)
    - kolejnosc montazu: serwo i pokrywa od srodka dyni (wystaja poza 56)
    - symulacja +-33 bez przenikan; wersja Onshape "v2.1d do review"
2026-10-18 Decyzja: CAD zostaje w Onshape, SolidCraft do obserwacji
2026-10-18 Oko F v2.2 (do review): gniazdo w dyni + kaseta skladana na stole
    - otwor 63.5 (otwornica 2 1/2"), gniazdo z gwintem 45 skok 5 (zazebienie 1.7, luz 0.3), nakretka 74
    - kaseta 54.5/48.5 wsuwana od srodka dyni: zebro w rowku, 2 zaczepy sprezyste w okienkach
    - sanki serwa, kolejnosc montazu na stole sprawdzona symulacja wsuwania
    - ogranicznik: kolek 2.6 w szczelinie na wylot (+-33); piasty C/H fi 10; scianki >= 2 mm
    - ruch +-33 bez przenikan; wersja Onshape "v2.2 do review"; plan, README, decyzje, skrypt kolizji v2.2
2026-10-18 Oko F v2.2: eksport 3MF czesci dla recenzentow (40-cad/3mf/Oko F v2.2/)
    [Oko F v2.2 - Ciegno.3mf, Oko F v2.2 - Gniazdo.3mf, Oko F v2.2 - Jarzmo z miska.3mf, Oko F v2.2 - Kaseta.3mf, Oko F v2.2 - Nakretka.3mf, Oko F v2.2 - PODGLAD SG90.3mf, Oko F v2.2 - PODGLAD orczyk SG90.3mf, Oko F v2.2 - PODGLAD pileczka 40.5.3mf]
2026-10-18 SolidCraft v2.3: gwint ISO M63x3 w gniezdzie, nakretka M63.6x3, probka gwintu (3MF), decyzja
    [Oko F v2.3 - Nakretka.3mf, Oko F v2.3 - Probka gwintu - gniazdo.3mf, Oko F v2.3 - Probka gwintu - nakretka luz 0.6.3mf]
2026-10-18 SolidCraft głównym narzędziem CAD
2026-10-18 Oko F v2.3 w SolidCraft: komplet czesci, zlozenie z jointami, symulacja ruchu i wsuwania, tabela luzow, eksport 3MF (do review)
    [Oko F v2.3 - Ciegno.3mf, Oko F v2.3 - Gniazdo.3mf, Oko F v2.3 - Jarzmo z miska.3mf, Oko F v2.3 - Kaseta.3mf, Oko F v2.3 - PODGLAD SG90.3mf, Oko F v2.3 - PODGLAD orczyk SG90.3mf, Oko F v2.3 - PODGLAD pileczka 40.5.3mf, Oko F v2.3 - Pokrywa tylna.3mf]
2026-10-18 Oko F v2.4 (do review): poprawki review v2.3, widelec, nakretka w fazie, szczelne siatki 3MF, narzedzia kontroli i naprawy siatek, tabela luzow
    [Oko F v2.4 - Ciegno.3mf, Oko F v2.4 - Gniazdo.3mf, Oko F v2.4 - Jarzmo z miska.3mf, Oko F v2.4 - Kaseta.3mf, Oko F v2.4 - Nakretka.3mf, Oko F v2.4 - PODGLAD SG90.3mf, Oko F v2.4 - PODGLAD orczyk SG90.3mf, Oko F v2.4 - PODGLAD pileczka 40.5.3mf]
2026-10-18 Review v2.4 w repo; AGENTS.md: SolidCraft źródłem prawdy, luz gwintu ISO 0,45; review-cad oznaczone jako historyczne
2026-10-18 review-cad: poprawka formatowania
2026-10-18 AGENTS.md: zmierzone zasady pracy z API Onshape i dyscyplina modelowania
    API: limit /features ~100 na okno vs ~3000 pozostale, naglowek X-Rate-Limit-Remaining zamiast pauz na wyczucie, noSketchGeometry (-58% payloadu), edycja jednej operacji przez POST features/featureid, sourceMicroversion przeciw nadpisaniu, FeatureScript poza pula roczna. Dyscyplina: Mirror, szyki, Chamfer/Fillet, jeden szkic wiele profili, Hole, budzet 15 operacji na czesc.
2026-10-19 Nowy sposób pracy: AGENTS.md z samymi instrukcjami, agenda w teraz.md, Onshape głównym CAD
    - AGENTS.md: role i zakres zasad, rozmowa z użytkownikiem (parafraza, bieżące zadanie,
    parking, format odpowiedzi, diff przed commitem), modelowanie w Onshape (kolejność
    budowy, zakaz Fix, kontrola szkicu znacznikiem w drzewie, runda weryfikacji K1–K10),
    twarde zasady API, eksport i kontrola siatek; usunięta historia i sekcja SolidCraft
    - 30-projekt/teraz.md + teraz.html (generator teraz_html.py): epiki E1–E3, zadania, parking
    - decyzje.md: Onshape głównym CAD, SolidCraft archiwum v2.3/v2.4
    - 20-analizy: analiza sesji orkiestratora, research metodyki modelowania parametrycznego,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
2026-10-19 E2.0: model próbki gwintu 45° w Onshape (trzpień + 5 nakrętek), weryfikacja, research kluczy API
    - 40-cad/onshape: skrypt z bramką API i kontrolą szkicu, plik stanu, etap 1 i 1b (testy, plan),
    weryfikacja K1–K9, K11 (zaliczone); budowa 6 brył w 8 min, 81 wywołań API
    - brief E2.0 w wersji dla osobnej sesji wykonawcy
    - 20-analizy: klucze API Onshape a sesja przeglądarki
    - teraz.md: E2.0 czeka na eksport i wydruk; parking: ikony ostrzeżeń, logowanie i worktree
2026-10-19 AGENTS.md: stała sesja wykonawcy CAD, praca na gałęzi worktree, logowanie do Onshape przed zleceniem
2026-10-19 E2.1 etap 1: specyfikacja v2.4 → v2.5 (149 operacji, pełne pokrycie) i plan budowy
    Nowy dokument Onshape „Oko F v2.5” (folder Halloween) z pustym Part Studio
    i Variable Studio „Zmienne v2.5”. Plan: zmienne, 10 części (73 operacje
    bryłowe), budżet API, odstępstwa do zatwierdzenia.
2026-10-19 Eksport 3MF v2.5 (10 części), brief review v2.5
    [Oko F v2.5 - Cięgno.3mf, Oko F v2.5 - Gniazdo.3mf, Oko F v2.5 - Jarzmo z miską.3mf, Oko F v2.5 - Kaseta.3mf, Oko F v2.5 - Nakrętka.3mf, Oko F v2.5 - Pokrywa tylna.3mf, Oko F v2.5 - Ramię orczyka.3mf, Oko F v2.5 - Sanki serwa.3mf]
2026-10-19 v2.5 po E2.1c: eksport kasety, jarzma i sanek; instrukcja montażu z renderami Blendera
    [Oko F v2.5 - Jarzmo z miską.3mf, Oko F v2.5 - Kaseta.3mf, Oko F v2.5 - Sanki serwa.3mf]
2026-10-19 Kontroler: ESP32-C3 SuperMini; NodeMCU ESP8266 i Nano jako zapas
2026-10-19 E3.4: test elektroniki zaliczony – szkice, połączenia, dziennik; 3MF całego projektu v2.5
    ESP32-C3 SuperMini + PCA9685 + 1 × SG90: Blink, skan I²C (0x40), ruch ±30°.
    [Oko F v2.5 - FullProject.3mf]
2026-10-21 v2.6/v2.7: siatki, review, instrukcja v2.7 z pozycją zero i kalibracją, program ruchu oczu, dziennik i decyzje
    Pierwszy moduł złożony i skalibrowany (środek 1500 µs, ±25° serwa).
    [Oko F v2.6 - Cięgno.3mf, Oko F v2.6 - FullProject.3mf, Oko F v2.6 - Gniazdo.3mf, Oko F v2.6 - Jarzmo z miską.3mf, Oko F v2.6 - Kaseta.3mf, Oko F v2.6 - Klamra H.3mf, Oko F v2.6 - Nakrętka.3mf, Oko F v2.6 - Pokrywa tylna.3mf]
2026-10-21 v2.8: eksport 3MF (10 brył sprawdzone), E5.1 i E5.2 zrobione
    [Oko F v2.8 - FullProject.3mf]
2026-10-21 Audyt dokumentacji 19–21.10: instrukcja v2.8, poprawka kroku 4 (serwo trzyma 1500 µs), test-24h ze środkami w NVS, decyzje, dziennik, agenda, elektronika, przekazanie dla nowej sesji
2026-10-22 E6: duże oko – decyzje 22.10 (dokument „Duże oko v1”, geometria 2c, Ø60, kardan 5/5, gałka biała), epik E6 jako bieżące zadanie
2026-10-22 E6.2: brief wykonawcy – duże oko w „Duże oko v1” (2c w modelu, 2b w druku, kardan 5/5)
2026-10-22 E6.1: wymiary kardana 5/5 z pomiaru (L 25,5, sworzeń–M4 9,1) w briefie E6
2026-10-22 E6.1: głębokość otworu kardana 7, trzpień M5 na 6 mm
2026-10-22 E6 etap 1: dokument „Duże oko v1” (Part Studio, Variable Studio), plan drzewa do zatwierdzenia, stan API (4 wywołania)
2026-10-22 E6 plan: orczyk MG90S z pomiaru (otwory co 2 mm od 5,5 do 17,5), promienie orczyków dla trzech osi
2026-10-22 E5.5 test powerbanku (wyniki 22.10) i E6 koncepcja dużego oka 2c v1/v2 z review
    - test-powerbank: płynny ruch serwa, start od ostatniego impulsu z NVS, przyczyna restartu, przerwy 5–20 s; Baseus PPAP20K odcina zasilanie co ok. 15 s (POWERON) na obu portach USB-A
    - analizy powerbanku A (obciążenie) i B (alternatywy), brief E5.5
    - E6: brief koncepcji v1 i v2, review briefu (Fable, Astra), koncepcja v1 (Opus) i jej review (Fable, Astra, Opus – NIE), koncepcja v2 (4 × MG90S), brief review v2
2026-10-22 E6: korekta decyzji z 22.10 (otwór ≤ 80, lekko, 2c od razu, 4 × MG90S, części posiadane), agenda E6 i sprzęt
2026-10-23 E6.2: brief CAD etapu 1 (Rama, Gałka, powieki, Słupek, Obejma, przyrządy)
2026-10-23 E6.2 etap 1: próba diagnostyczna znacznika – niezaliczona przy ukrytym panelu, stop do otwarcia sesji w oknie
2026-10-23 E6: weryfikacja v3 przez Astrę (NIE – model przemiatania i okno do przeliczenia)
2026-10-23 Parking: wnioski 22–23.10 do AGENTS.md (codex w tle, encje pomocnicze a znacznik, rola wykonawcy)
2026-10-23 E6.2: zapis widoczności panelu i podstawy nocnego „hidden”
2026-10-23 E6.2 Rama: korpus, bok osi, otwór +x, fazka; Mirror nie odbija Hole – stop na budżecie (20/18)
2026-10-23 E6.2 Rama (baza) gotowa: otwór osi po −x przez Mirror FACE, folder i nazwa części; wnioski Hole/Mirror
2026-10-23 E6.2: odbiór orkiestratora K1–K4 – Rama (baza), Gałka, Próbka P6 przyjęte
2026-10-23 E6.2: Powieka górna (baza) – czasza, rant, mostek i ucha ±x, otwór osi; nazwa podkładki Ramy (K10)
2026-10-23 E6.2: odbiór K1–K4 – powieki (baza) przyjęte
2026-10-23 E6.2 etap 1: plan drzewa Słupka do zatwierdzenia (kanał nakrętki, spłaszczenie, budżet – do decyzji)
2026-10-23 E6.2: Słupek – korpus z kieszenią kardana, przelot M5, kanał nakrętki M5, otwór M4
2026-10-23 E6: koncepcja v3.1 – model kontrolny od nowa (okno z dokładnych przekrojów, odległości dolnym ograniczeniem), narzędzie akceptacji B1; skrypty v3 w v3/
2026-10-23 E6.2: odbiór K1–K4 – Słupek i Obejma przyjęte; brief weryfikacji v3.1
2026-10-23 E6.2 etap 1: runda K1–K11 (K9: błąd przycięcia Powieki dolnej), eksport 3MF całego Part Studio, siatki 7/7 OK
    [Duze oko v1 - FullProject.3mf]
2026-10-23 E6.2: poprawka przycięcia powiek (trimG = min(uchoDX1, powiekaR1) − luzOsiowy), K9 luzCzasza i kulaD zaliczone
2026-10-23 E6: weryfikacja v3.1 przez Astrę (NIE – kolizja piasty M2 Y ze Słupkiem przy θ ≥ 12°, braki macierzy par, błąd prism_d)
2026-10-23 E6: B4 (ucho MG90S) zamknięte decyzją – M2 z nakrętką, kanał kabla z obu stron
2026-10-23 E6: B1 przeguby kulowe – brak zdjęć w sesji, wartości typowe (założenia) ze źródłami
2026-10-23 E6: przegubów kulowych RC nie ma – są kardany 2/2 i 5/5 (po 2 szt.); korekta decyzji i sprzętu
2026-10-23 E6.3: brief CAD etapu 2a (dokończenie części, Płyta, ramiona powiek, przyrządy – na szacunkach jako zmiennych)
2026-10-23 E6.3: Rama (ucha, gwinty M3, fazka) i Gałka (nadlewy, wycięcia X/Y) – dane do odbioru
2026-10-23 E6.3: odbiór K1–K4 – dokończenie Ramy i Gałki przyjęte
2026-10-23 E6.3: powieki – wycięcie, przycięcia przy zaczepach, zaczepy drutu, kąciki; dane do odbioru
2026-10-23 E6.3: odbiór powiek (dokończenie) – warunkowo do pełnego K1; wyjątek K5 dla kącików
2026-10-23 E6.3: plan drzewa Płyty (klatki MG90S, bloki uszu, wspornik, słupki, słupki stopu) + czop Słupka; decyzje D1–D6
2026-10-23 E6.3: stan – czekam na decyzje (plan Płyty D1–D6, budżet, A/B/K5); licznik 2a 103/160
2026-10-23 E6.3: nadlewy Gałki na płaszczyźnie krawędzi (B), pełny K1 114/114, plan Płyty – decyzje D1–D6, styk słupek–ucho, gwint M3 4,25
2026-10-23 E6.3: pełny K1 – odbiory Ramy, Gałki i powiek zamknięte
2026-10-23 E6.3: Płyta w budowie – tarcza, klatki, bloki uszu M2, kanały, wspornik ze słupkami (stan)
2026-10-23 E6.3: Płyta (bez słupków stopu) + czop Słupka – K1 197/197, K2 64/64, foldery podgrup
2026-10-23 E6.3: stan – słupki stopu wstrzymane (kolizje z S_X i wieżyczkami), budżet 300
2026-10-23 E6.3: plan ramion – kąt montażowy jako zmienna; wniosek: przemiatanie par stała–stała; słupki stopu do v3.2
2026-10-23 E6: decyzja – wgłębienie zera pod źrenicą Gałki dopuszczone
2026-10-23 E6.3: Ramiona PG/PD, przyrząd gięcia, K9 (poprawka klatek przy zSerw), odbiór końcowy K1–K4
2026-10-23 E6.3: raport weryfikacji K1–K11 etapu 2a
2026-10-23 E6.3: odbiór końcowy etapu 2a – przyjęty (K1–K4 niezależnie, K9 wykonawcy)
2026-10-23 E6.4: wgłębienie zera Gałki i przyrząd zera (czapka na sferze rantu) – odbiór K1–K4
2026-10-23 E6.4: odbiór – wgłębienie zera i Przyrząd zera przyjęte
2026-10-23 E6: przemiatanie kolizji na siatkach CAD z kinematyką (etap 1) – przenikanie Powieki górnej w kołnierz Ramy 1,13 mm
2026-10-23 E6.5: Powieka górna – mostek 55…95° i ucho G R5,5 (luz 0,5 do kołnierza Ramy), pomiar i K1
2026-10-23 E6.5: mostekKat1 56° – luz mostka do kołnierza 0,60
2026-10-23 E6.5: kolizja powieki z kołnierzem – poprawka zmiennymi powieki (luz 0,5/0,6)
2026-10-23 E6: koncepcja v3.2 – pręty U–R–U na drukowanych przegubach krzyżowych, Uchwyt bez kolizji ze Słupkiem, słupki stopu przeliczone, model kontrolny poprawiony
2026-10-23 E6.6: brief CAD etapu 2b – napęd gałki (P4, Uchwyt, Ramiona X/Y, pręty U–R–U, krzyżaki) i słupki stopu
2026-10-23 E6.6: plan P4 – próbka przegubu krzyżowego (komplet pręta X), 5 uwag do koncepcji v3.2
2026-10-23 E6: weryfikacja v3.2 przez Astrę (TAK PO POPRAWKACH – podparcie stopu D, śruby Gałki, luz zwrotny, zapas kąta przegubów w 3D)
2026-10-23 E6.6: P4 zbudowana – 6 brył, 19 operacji OK, szkice zdefiniowane, bodydetails zgodne z planem (25/34 żądań)
2026-10-23 E6.6: plan C2–C6 – C3 przecina nadlew 330° (propozycja: nadlewy za wycięciami)
2026-10-23 E6.6: m2PoglD 3,8 (Astra), C2 (wycięcie czaszy G przy uchu D), C4, C5; README druku – Próbka P4; C3 wstrzymane (nadlew 330°)
2026-10-23 E6.6: odbiór P4 + C2–C5 (K1–K8 na GET /features, 79/79 szkiców), test nadlewów w README
2026-10-23 E6.6: odbiór P4 i C2–C5; Parking: przypora nadlewu Gałki
2026-10-23 E6.6: plan Uchwytu (wstępny, do korekty v3.2) – a1 = −y, łapy jako osobne części, 7 punktów do decyzji
2026-10-23 E6.6: plan Uchwytu – decyzje orkiestratora (łapy osobno, tuleja jak Słupek, M4 przelotowy ±y, spline okna, K3)
2026-10-23 E6.6: szkic instrukcji montażu dużego oka v1 (kroki 0–13, [2b] w miejscach zależnych od etapu 2b)
2026-10-23 E6.6: oś powiek – zamiennie DIN 913 M3×8 (instrukcja montażu i README druku)
2026-10-23 E6: korekta v3.2 po Astrze (K1–K10: filar stopu, łapy M3×6, luz z macierzy, przeguby 3D, a1 = −y)
2026-10-23 E6.6: plan Uchwytu i Łap po korekcie v3.2 (żebro przycięte do płyty, M4 przelotowy, nakrętka M5 – do decyzji)
2026-10-23 E6.6: skrypt Uchwytu i Łap (kroki 1–7, test na sucho: 12 szkiców z bilansem 0, stałe tylko n·oknoKrok)
2026-10-23 E7: firmware i strona dyni (21 efektów, kreator kalibracji, API), test powerbanku z Wi-Fi, brainstorm i koncepcja pilota
    - 50-elektronika/dynia: firmware ESP32-C3 (punkt dostępu Dynia, captive portal, API HTTP/JSON, kolejka ruchu z limitem serw, start bez skoku, heartbeat), strona na iPhone 7 z trybem symulacji, duże oko 4 x MG90S z niezależnymi powiekami, kreator kalibracji krańców oka; po review Fable i Astry
    - test-powerbank-wifi i test-24h z Wi-Fi: Baseus z Wi-Fi 47,6 min i 7,9 h w nocy bez restartu
    - strona-efekty.md, brainstorm 6 uczestników i zestawienie, koncepcja pilota ESP32-C6 (Opus, Astra), briefy i raporty review
    - bieżące pliki E6 z narzędzi siatek (stan roboczy drugi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
2026-10-23 Wnioski z pracy 22–23.10: sposób pracy orkiestratora i wykonawcy CAD (propozycje do AGENTS.md)
2026-10-23 AGENTS.md: wnioski z pracy 22–23.10 (funkcja vs technika, szacunki jako zmienne, rola wykonawcy w zleceniu, limit rund koncepcji, przemiatanie siatek CAD, pułapki Onshape API, K1/K9)
2026-10-23 E6: eksport 3MF z 23.10 19:05 (21 części, w tym Uchwyt, Łapy, P4 po korekcie), STL rozdzielone, kontrola siatek 21/21 OK; stary FullProject z etapu 1 usunięty
    [Duze oko v1 - FullProject.3mf, Duże oko v1 - Gałka.3mf, Duże oko v1 - Gałka.stl, Duże oko v1 - Obejma.3mf, Duże oko v1 - Obejma.stl, Duże oko v1 - P4 Krzyżak G.3mf, Duże oko v1 - P4 Krzyżak G.stl, Duże oko v1 - P4 Krzyżak O.3mf]
2026-10-23 E6.6: P4 – sworzeń a1 przy orczyku przelotowy (M2×12), a2 M2×4; README P4
2026-10-23 E6: przemiatanie siatek eksportu 23.10 – brak kolizji; mostek/ucho G – kołnierz 0,54–0,60, kąciki powiek 0,69–0,87, czasze 1,0–1,19; minima 0,25–0,28 to zamierzony luz osiowy uch
2026-10-23 E6.6: K9 (4 zmienne, poprawka qClosestTo w 5 operacjach) i odbiór etapu 2b (K1–K8 zaliczone, 111 szkiców, K11 otwarte)
    Wywołania: etap 2b 271/320 (GET /features 6/8), E6 752, rok 1310.
2026-10-23 E6: eksport v1.1 (23.10 22:11) – 27 części, model kompletny; STL rozdzielone, kontrola siatek 27/27 OK
    [Duże oko v1 - Gałka.3mf, Duże oko v1 - Gałka.stl, Duże oko v1 - Krzyżak gałki Y.3mf, Duże oko v1 - Krzyżak gałki Y.stl, Duże oko v1 - Krzyżak orczyka Y.3mf, Duże oko v1 - Krzyżak orczyka Y.stl, Duże oko v1 - Obejma.3mf, Duże oko v1 - Obejma.stl]
2026-10-23 E6: stan na koniec 23.10 – eksporty użytkownika (zip v1 i v1.1, FullProject), wyniki przemiatania modelu, konfiguracja przemiatania v1.1 (przebieg przerwany na polecenie użytkownika)
    [Duze oko v1 - FullProject.3mf]
2026-10-23 E6: usunięty nieaktualny FullProject z etapu 1 (aktualny eksport: eksport-2026-10-23b)
    [Duze oko v1 - FullProject.3mf]
2026-10-23 Wnioski: błąd orkiestratora – dopisane wymagania funkcjonalne, mechanizm nieprzegadany z użytkownikiem, zignorowane kardany
2026-10-23 Zlecenie dla projektanta: duże oko, krok 1 – wstępna koncepcja
2026-10-23 Duże oko krok 2: zlecenie CAD na noc, raport krytyka, PRD – mocowanie od środka i wariant B z góry
2026-10-23 Duże oko v2: próbka drutu, plan szczegółów, review Astry, kinematyka, model OpenSCAD
    Onshape: utworzenie publicznego dokumentu zablokowane uprawnieniami sesji,
    model parametryczny w OpenSCAD (40-cad/openscad). Raport nocny w 30-projekt.
    [Probka drutu.3mf, duze-oko-v2.scad]
2026-10-23 Duże oko v2: druty 1:1, instrukcja montażu i druku, podgląd złożenia, kontrola kolizji (skrypt)
    [duze-oko-v2.scad]
2026-10-23 Duże oko v2: SCAD z modułami części i zmiennymi, eksport 3MF wszystkich części + zbiorczy (siatki OK, 1 bryła na część)
    [Duze oko v2 - wszystkie czesci.3mf, Galka.3mf, Maskownica.3mf, Pierscien.3mf, Powieka dolna.3mf, Powieka gorna.3mf, Probka drutu.3mf, Uchwyt serw.3mf]
2026-10-24 Duże oko v2: ucha drutów jako blaszki (x 20, z −4), krótsze ramiona powiek, kolizje 0 przenikań, druty i kąty serw przeliczone
    [Duze oko v2 - wszystkie czesci.3mf, Galka.3mf, Powieka dolna.3mf, Powieka gorna.3mf, Probka drutu.3mf, duze-oko-v2.scad]
2026-10-24 Duże oko v2: poprawki po review Astry na siatkach (podkładki osi M2, docisk gałki, ucha, luzy drutów, instrukcja), ponowny eksport i kontrola kolizji
    [Duze oko v2 - wszystkie czesci.3mf, Galka.3mf, Maskownica.3mf, Pierscien.3mf, Powieka dolna.3mf, Powieka gorna.3mf, Probka drutu.3mf, Uchwyt serw.3mf]
2026-10-24 Duże oko v2: próbka z blaszką ucha 1:1, dłuższa płaska krawędź ucha, weryfikacja Astry, poprawka zagęszczenia w kontroli kolizji
    [Duze oko v2 - wszystkie czesci.3mf, Galka.3mf, Probka drutu.3mf, duze-oko-v2.scad]
2026-10-24 Raport nocny: drut S1–ucho 0,42 mm jako otwarte, do rozstrzygnięcia próbką
2026-10-24 Raport nocny: domknięcie kamieni 1–7, aktualne wartości
2026-10-24 Duże oko v2: zmienne bazowe i pochodne (położenia liczone ze zmiennych), skrypty kinematyki i kolizji czytają parametry z SCAD, plan przeniesienia do Onshape
    [Duze oko v2 - wszystkie czesci.3mf, Galka.3mf, Maskownica.3mf, Pierscien.3mf, Powieka dolna.3mf, Probka drutu.3mf, Uchwyt serw.3mf, duze-oko-v2.scad]
2026-10-24 Duże oko v2: test zginania (Rg 29/31, ścianka 28/50, luzObr 0,3) – model się przelicza, granica Rg ≈ 30,6 przy otworze Ø80
2026-10-24 Duże oko v2: asercje granic, parametry brył zastępczych w kontroli, test zginania z werdyktami (7 wariantów), poprawki po review Astry (parametryczność)
    [Duze oko v2 - wszystkie czesci.3mf, Galka.3mf, Maskownica.3mf, Pierscien.3mf, Probka drutu.3mf, Uchwyt serw.3mf, duze-oko-v2.scad]
2026-10-24 Duże oko v2: pełne review Astry (kamień 5), pełne orczyki w kontroli, werdykty przeliczenie/luzy, pomiar wymiarów brył, kolejność druku i test próbki w raporcie
    [Galka.3mf, Maskownica.3mf, Pierscien.3mf, Probka drutu.3mf, Uchwyt serw.3mf, duze-oko-v2.scad]
2026-10-24 Duże oko v2: przyrząd do gięcia drutów (parametryczny, 4 tory), zbiorczy 3MF z 8 osobnymi obiektami, instrukcja gięcia, rysunek drutów w układzie przyrządu, review Astry
    [Duze oko v2 - wszystkie czesci.3mf, Przyrzad do giecia drutow.3mf, duze-oko-v2.scad]
2026-10-24 Duże oko v2: przyrząd do gięcia z kołkami ze śrub M3 (wewnętrzny i oporowy przy każdym zagięciu), instrukcja
    [Duze oko v2 - wszystkie czesci.3mf, Przyrzad do giecia drutow.3mf, duze-oko-v2.scad]
2026-10-24 Kalibracja oczu: wybór kanału, zapis środka i krańców w NVS, tabela do kalibracja-oczu.md
    Program kalibracji modułów po kolei z portu (k <n>, s/min/max, t), start bez impulsu,
    kontrola I2C i NVS, limit skoku 150 µs. Review Astry (5 rund) i Opusa (2 rundy).
2026-10-24 E6.6: stan – kontrola sesji 24.10 (keepalive Failed to fetch w panelu), timer i kontrole wyłączone
2026-10-24 PRD: podstawka pod dynią z szufladą na powerbank zamiast pudełka w środku
2026-10-24 PRD: podstawka – szufladka do przodu tylko na powerbank, elektronika na stałe, tuleja w dnie dyni
2026-10-25 Podstawka pod dynię: koncepcja, model OpenSCAD, pliki do druku i rysunek cięcia
    Koncepcja (rendery Blender) po 2 rundach review Opusa i Astry; model parametryczny
    podstawka.scad: szufladka z powerbankiem do przodu (X1C albo 2 połówki A1 mini),
    kaseta elektroniki, tuleja z gwintem 45°/skok 5 i nakrętka, osłonka PIR, próbka
    gwintu; sklejka 18 mm: rysunek cięcia i złożenie z wkrętami. Siatki 3MF szczelne,
    test zginania OK, review modelu i weryfikacja poprawek (Opus, Astra).
    [Kaseta elektroniki.3mf, Nakretka.3mf, Oslonka PIR (opcja).3mf, Probka gwintu - nakretka.3mf, Probka gwintu - tuleja.3mf, Szuflada (X1C).3mf, Szuflada lewa (A1 mini).3mf, Szuflada prawa (A1 mini).3mf]
2026-10-25 Duże oko v9: powieki na osobnych serwach (zaczep 34 mm od osi, przedłużenie orczyka 25 mm), kardany 2/2 przy gałce, poprawka rowka T
    - powieki: uszko na tylnej krawędzi czaszy, dwa serwa SG/SD zamiast S3, część PrzedluzenieOrczyka (kołki przez otwory orczyka MG90S)
    - gałka: kostki pod kołek Ø2 kardanów 2/2 (środek przegubu w punkcie ucha, rUcha 17, tylRant 4), przesS2 5,5; rowek T nie przebija skorupy
    - usunięte: dźwignie r 7, widełki, przyrząd do gięcia (z eksportu)
    - instrukcja druku i montażu przepisana; przemiatania kolizji kardanów i powiek v9; review Opus + Astra (2 rundy) w 20-analizy/review
    [Duze oko v2 - wszystkie czesci.3mf, Galka.3mf, Maskownica.3mf, Pierscien.3mf, Powieka dolna.3mf, Powieka gorna.3mf, Probka drutu.3mf, Przedluzenie orczyka x2.3mf]
2026-10-25 Podstawka: szufladka na listwach nośnych, poprawki po weryfikacji
    Listwy nośne (druk) przykręcane od zewnątrz przez ściankę ze sklejki, szufladka
    leży na nich dnem 8 mm nad stołem (bez kleju; szufladka bez zmian). Wnętrze 48,
    podstawka 66. Wcześniejsze poprawki po weryfikacji: wycięcie PIR od dna, gniazdo
    zasilania w kasecie za wycięciem kablowym, otwory USB-C 9,5. Weryfikacja Opusa i
    Astry: brak uwag psujących działanie lub druk.
    [Listwy nosne x2.3mf, Oslonka PIR (opcja).3mf, podstawka-drewno.scad, podstawka.scad]
2026-10-25 Parking: usztywnienie Uchwytu – wieże połączone ściankami
2026-10-25 Duże oko v9: skrypt animacji mechanizmu w Blenderze; usunięty nieaktualny przyrząd do gięcia drutów
    [Przyrzad do giecia drutow.3mf]
2026-10-25 PM: plan z epikiem Podstawka, stan po przeglądzie sesji; PRD i decyzje – podstawka wykonana, dynia kupiona, 4 serwa, PIR, blokada szufladki
2026-10-25 PM: otwór w płycie podstawki Ø60 (pomiar użytkownika), poprawka Ø45
    [Listwy nosne x2.3mf]
2026-10-25 Podstawka v2: model do stanu wykonanego, blokada szufladki M4
    Stan wykonany 25.10: dno 6 mm sklejone ze ściankami 40, płyta 18 z otworem Ø60
    na 4 wkrętach, kaseta elektroniki przykręcona do dna (4 × 3×12 przez piasty).
    Blokada szufladki: M4 × 25 imbus przez prawy kołnierz czoła (Ø4,5) w przednią
    krawędź prawej ścianki (Ø3,3 × 22, gwint wycina śruba). Do druku szufladka X1C
    w całości; lewa połówka A1 mini bez zmian (zapas). Listwy nośne usunięte.
    Review Opusa i Astry: brak uwag psujących działanie lub druk.
    [Kaseta elektroniki.3mf, Oslonka PIR (opcja).3mf, Szuflada (X1C).3mf, Szuflada prawa (A1 mini).3mf, podstawka-drewno.scad, podstawka.scad]
2026-10-25 Stan 25.10 przed przenosinami: podstawka v2 (stan wykonany, szuflada X1C, blokada M4) po review; Uchwyt dużego oka v13 w toku (wariant S2 wyłączony, nie drukować); kalibracja, plan programu, raporty 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
    [Final-Print.3mf, Oko F v2.8 - FullProject.3mf, duze-oko-v2.scad]
2026-10-25 PM: plan – Uchwyt serw wstrzymany do analizy mocowań
2026-10-25 PRD 0.2: podstawka – wymiary wykonane, szufladka v2 (osobny front, rączka M4, blokada w płytę górną), mocowanie PIR we froncie
2026-10-25 Podstawka: szufladka v2 według PRD 0.2 (korpus 215, osobny front, rączka M4, blokada w płytę, PIR we froncie)
    - zmienne bazowe według pomiarów: wnętrze 216, dno 9, głębokość 226, wkręty płyty 20, otwór Ø60
    - korpus 215 (ścianki 2,0, wtyk USB-C 50), luz 0,5/str.; front 244 × 65 × 4 licem na stół; rączka niska
    (ścięty ostrosłup 66 × 14 → 76 × 22, wysięg 15, R3 – decyzja użytkownika), łby M4 na epoksyd; blokada M4 × 25
    w krawędź płyty (pilot Ø3,3 × 22); PIR: Ø24, gniazdo 23,5 × 23,5, 2 × M2; próbka gniazda PIR
    - kaseta v1 bez zmian; eksport 9 części do 40-cad/3mf/Podstawka v2/, siatki OK, wymiary OK
    - kontrole kolizji CGAL (podstawka-kolizje.sh):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
    [Kaseta elektroniki.3mf, Nakretka.3mf, Probka gwintu - nakretka.3mf, Probka gwintu - tuleja.3mf, Szuflada v2 - front (X1C).3mf, Szuflada v2 - korpus (X1C).3mf, Szuflada v2 - probka gniazda PIR.3mf, Szuflada v2 - raczka.3mf]
2026-10-25 PRD §9: prostota przed zakresem – każdy dodatkowy przegub omawiany z użytkownikiem, referencja jako granica złożoności, montaż rękami, bez konstrukcji na milimetr
2026-10-25 Szufladka v2: mniejsza rączka (40 × 10 → 46 × 16, wysięg 10, M4 × 20 w rozstawie 26) – decyzja użytkownika; pomiar kołnierza PIR 22,97
    Eksport korpusu, frontu, rączki i próbki PIR, siatki, wymiary i 5 kontroli kolizji powtórzone – OK.
    [Szuflada v2 - front (X1C).3mf, Szuflada v2 - korpus (X1C).3mf, Szuflada v2 - probka gniazda PIR.3mf, Szuflada v2 - raczka.3mf, podstawka.scad]
2026-10-25 Szufladka v2: PIR po prawej stronie frontu (decyzja użytkownika), przewód prosto do tyłu pasem wtyku USB-C
    Oś PIR 40 od prawego boku korpusu (pirOdPrawej), wycięcie przegrody nad pasem wtyku. Eksport korpusu, frontu, rączki
    i próbki PIR, siatki, wymiary, 5 kontroli kolizji i test czułości – OK.
    [Szuflada v2 - front (X1C).3mf, Szuflada v2 - korpus (X1C).3mf, Szuflada v2 - probka gniazda PIR.3mf, Szuflada v2 - raczka.3mf, podstawka.scad]
2026-10-25 Szufladka v2: review runda 2 (Astra 0 uwag, Fable 1 ważna) – okno PIR 38 × 30, płaskie lico rączki, kontrola kolizji wykrywa nieudane asserty
    Eksport korpusu, frontu, rączki i próbki PIR, siatki, wymiary, 5 kontroli kolizji i test czułości – OK.
    [Szuflada v2 - front (X1C).3mf, Szuflada v2 - korpus (X1C).3mf, Szuflada v2 - probka gniazda PIR.3mf, Szuflada v2 - raczka.3mf, podstawka.scad]
2026-10-25 Próbka gniazda PIR: przymiarka zaliczona (rozstaw M2 28,5, kopułka w Ø24) – front szufladki v2 do druku; zdjęcia z manifestem, wpis w dzienniku
2026-10-25 Szufladka v2: podkładki M2 pod PIR 4 × 8, wys. 3,5 (decyzja użytkownika po próbce); rysunki montażu PIR
    Kieszeń PIR 27, korpus 103 głęb. Eksport, siatki, wymiary, 5 kontroli kolizji i test czułości – OK.
    [Szuflada v2 - front (X1C).3mf, Szuflada v2 - korpus (X1C).3mf, Szuflada v2 - probka gniazda PIR.3mf, Szuflada v2 - raczka.3mf, podstawka.scad]
2026-10-25 Szufladka v2: śruby boczne front–korpus M4 × 12 stożkowe w pogłębieniu 90° zamiast M3 z łbem walcowym (decyzja użytkownika)
    Eksport, siatki, wymiary i 5 kontroli kolizji – OK.
    [Szuflada v2 - front (X1C).3mf, Szuflada v2 - korpus (X1C).3mf, Szuflada v2 - probka gniazda PIR.3mf, Szuflada v2 - raczka.3mf, podstawka.scad]
2026-10-25 Duże oko: analiza referencji The Face maker101 (Fable, Opus, Astra, synteza z pomiarem STL), decyzje 26.10 (kardan 5/5 w środku kuli, zawias powiek na słupkach, czasza do 120°, 3 długości tuby), pomi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
2026-10-25 Brief: koncepcja dużego oka na wzór The Face maker101 (krok 1, bez CAD)
2026-10-26 Duże oko: koncepcja na wzór The Face maker101 (krok 1, bez CAD)
    Płyta pionowa za gałką z 2 słupkami zawiasu i słupkiem kardana, 4 × MG90S
    wklejone w okna płyty, kardan 5/5 na 2 trzpieniach M5×8, pręty Ø1,0 od
    języczków w kuli (r 14) do orczyków 17,5 / 15,5; zakres ±35° / ±25° z
    rachunkiem czworoboku; powieki współśrodkowe na drutach Ø2. Szkic SVG,
    lista części, montaż z dostępem narzędzi, różnice wobec referencji i
    pytania P1–P5 do użytkownika.
2026-10-26 Duże oko v3: model OpenSCAD, 3MF do druku, przemiatanie kolizji (płyta pozioma według decyzji PM)
    duze-oko-v3.scad (parametry na górze): płyta pozioma za tubą ze słupkami zawiasu (łuk R37,2)
    i słupkiem kardana, gałka z jedną centralną piastą i 2 języczkami, krawędź czaszy z = −12
    (przy −15 pręt L–P przechodził przez krawędź), powieki z zaczepami 34 / 31,5 przy x = ±5,
    osie Ø2,4, tuby 30/40/50, maskownica, przedłużenie orczyka. 3MF: 0 błędów, 1 bryła na część.
    Przemiatanie (Blender BVHTree, gałka co 5° z narożnikami, powieki 0–51,5°): 0 par poniżej
    wymogu z 83. Montaż: wkręt M4 piasty tylnej dokręcany przed nałożeniem gałki.
    zbiorczy_3mf.js: p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
    [Duze oko v3 - wszystkie czesci.3mf, Galka.3mf, Maskownica.3mf, Plyta.3mf, Powieka dolna.3mf, Powieka gorna.3mf, Przedluzenie orczyka (druk x2).3mf, Tuba 30.3mf]
2026-10-26 Duże oko v3: poprawki po review zgodności (Opus, Astra), render; blokada: zaczepy „Z” na gałce
    Serwo powieki górnej na z = −95 (0,95 od tylnego ucha L–P, było przenikanie 143 mm³), płyta do
    z = −105; orczyki powiek przykręcane przed serwem L–P (droga wkrętaka > 10 mm); bez kołków
    przedłużeń; otwory osi Ø2,4 w świetle (wielokąt opisany) także w słupku, drut na CA; przejście
    kabla G–D w płycie; szczelina orczyka dolnej powieki na przedłużenie; wycięcie pod uszkiem 10 mm.
    Przemiatanie: serwa z uszami, pary nieruchome, druty z zakończeniami „Z”, tuby 30/40/50,
    gałka–powieki we wszystkich położeniach. Render 4 ujęć (MP4, PNG) w podglad/duze-oko-v3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
    [Duze oko v3 - wszystkie czesci.3mf, Maskownica.3mf, Plyta.3mf, Powieka dolna.3mf, Powieka gorna.3mf, Przedluzenie orczyka (druk x2).3mf, Tuba 30.3mf, Tuba 40.3mf]
2026-10-26 Duże oko v3: zaczepy „Z” na gałce rozwiązane geometrią (decyzja PM), próbka zaczepu, przemiatanie 0 z 139
    Otwór G–D obrócony na oś y gałki (słupek w płaszczyźnie y = 15,3 od przedniej czaszy, spód 1 mm
    pod otworem, narożniki 45°), otwory dwustożkowe Ø2,0 × 1,0 z fazkami 45° w obu zaczepach, zaczep
    na r 15,3 (mostek 1,0), noga „Z” 4,0; wymagany przechył 30,1° wobec dopuszczalnych 36,9°.
    Krawędź czaszy z = −11,5. Noga „Z” drutów powiek 2,5, wycięcie przy uszku do z = 2,6.
    Nowa część: Probka zaczepu galki (otwory A Ø2,0 × 1,0 i B Ø2,3 × 0,6) – drukować przed gałką.
    Przemiatanie z rzeczywistym „Z”: 0 par poniżej wymogu z 139. Render zbli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
    [Duze oko v3 - wszystkie czesci.3mf, Galka.3mf, Maskownica.3mf, Plyta.3mf, Powieka dolna.3mf, Powieka gorna.3mf, Probka zaczepu galki.3mf, Przedluzenie orczyka (druk x2).3mf]
2026-10-26 Duże oko v3: film ogólny i klatki PNG ponownie na obecnej geometrii (po poprawce serw i zaczepów), film zbiorczy złożony od nowa
    [duze-oko-v3.blend]
2026-10-26 Duże oko v3: poprawki po rundzie 2 (sztywny „Z”, nasada słupka G–D, krawędź czaszy −11, instrukcja)
    Nowy skrypt duze-oko-v3-z-sztywne.py: pręty gałki jako jeden sztywny drut o stałej długości
    i zagięciach, przechylany w otworach – przechył 28,9° / 29,2° (dopuszczalne 36,9°), przy orczyku
    7,2° / 8,0° (ok. 10,1° [Z]), luz do gałki 0,73 / 0,72. Krawędź czaszy z = −11 (przy −11,5 luz 0,27).
    Słupek G–D z nasadą skosem 45° od z = +4 (naprężenie przy zablokowanym serwie ok. 19 MPa zamiast 59).
    Przemiatanie: 0 z 139. Instrukcja: podpory pod uszkami powiek, klej PG bez przodu, zagięcia G–D
    w płaszczyznach prostopadłych, oględziny słupka, poprawione opis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
    [Duze oko v3 - wszystkie czesci.3mf, Galka.3mf, Maskownica.3mf, Plyta.3mf, Powieka dolna.3mf, Powieka gorna.3mf, Probka zaczepu galki.3mf, Przedluzenie orczyka (druk x2).3mf]
2026-10-26 Duże oko v3: briefy i raporty recenzji nocnych (odstępstwa koncepcji, oczko, zgodność v3 r1 i r2 – Opus 5.5, Astra), decyzja PM
2026-10-26 Duże oko v3: decyzje użytkownika o wyglądzie (źrenica ≤ Ø20, wystawanie 24 mm, czasza ok. 111°)
2026-10-26 Duże oko v3: druty Ø1,2 (Ø1,0 brak), otwory zaczepów pod Ø1,2; decyzje P4/P5/czasza
    Zaczepy gałki: gardziel Ø2,2 × 0,8 (przechył 39,2° wobec wymaganych 30,1°), zaczep r 15,5
    (mostek 1,0), L–P wałek x 33,0; uszka powiek i przedłużenia Ø1,5; próbka A Ø2,2 × 0,8, B Ø2,3 × 0,6.
    Instrukcja: otwory orczyków L–P i G–D rozwiercić do Ø1,6 (fabryczny Ø1,3 daje 3,5° wobec 8°).
    Sztywny drut Ø1,2: przechył 28,9° / 28,8°, przy orczyku 7,2° / 9,2° (13,0° dopuszczalne), luz do
    gałki 0,54 / 0,69. Przemiatanie Ø1,2: 0 z 139. Render zbliżeń prętów.
    Źrenica ≤ Ø20, wystawanie 24, czasza 111°: decyzje użytkownika 26.10 (SCAD, instrukcja, koncepcja).
    Co-Authored-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
    [Duze oko v3 - wszystkie czesci.3mf, Galka.3mf, Maskownica.3mf, Plyta.3mf, Powieka dolna.3mf, Powieka gorna.3mf, Probka zaczepu galki.3mf, Przedluzenie orczyka (druk x2).3mf]
2026-10-26 Duże oko v3: nasady słupków, stopka i podpora płyty do druku pod 45°
    - żebra nasad słupków zawiasu (do spodu płyty w r ≤ 37,6) i kardana (skosy 45°, żebro do z −31)
    - stopka: ścięcie 45° tylnej dolnej krawędzi płyty (pas 4,2)
    - projektowana podpora jako osobna bryła: Podpora plyty (druk 45).3mf oraz plik wspólny
    Plyta + podpora (druk 45).3mf (2 bryły w pozycji druku), ściany pod ramionami i słupkiem kardana,
    łączniki z karbem, odstęp bez łączników 0,69
    - rachunek wytrzymałości słupków (duze-oko-v3-slupki.py, raport w 20-analizy)
    - przemiatanie 0 z 139 par poniżej wymogu, sztywne Z OK
    [Duze oko v3 - wszystkie czesci.3mf, Maskownica.3mf, Plyta + podpora (druk 45).3mf, Plyta.3mf, Podpora plyty (druk 45).3mf, Powieka dolna.3mf, Powieka gorna.3mf, Probka zaczepu galki.3mf]
2026-10-26 Duże oko v3: poprawki po recenzji słupków i podpory (Opus, Astra)
    - stopka: cube(pl_stopka·√2), pas 4,24, zgodna z c45; w 3MF płyta i podpora na Z = 0, 32/32 łączników w płycie
    - żebro zawiasu: skos ciągły do zera na ramieniu na z = −12 (bez uskoku na z = −20), r ≤ 37,2 (0,95 do tuby 50)
    - podpora: poziome belki zastąpione zastrzałami 45° (bez mostów), łącznik przesunięty ≥ 2 mm od szczeliny,
    podpora usunięta z pliku zbiorczego; instrukcja odłamywania bez zginania ramion na boki
    - rachunek słupków: siły z kinematyki F = T/|e·(r×u)|, zginanie dwukierunkowe dla każdego wektora, przekroje co 0,5 mm,
    druk płasko / pod 45° (Tsai–Hill i dolna granica),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
    [Duze oko v3 - wszystkie czesci.3mf, Maskownica.3mf, Plyta + podpora (druk 45).3mf, Plyta.3mf, Podpora plyty (druk 45).3mf, Powieka dolna.3mf, Powieka gorna.3mf, Probka zaczepu galki.3mf]
2026-10-26 PM: plan i agenda na 26.10 – duże oko v3 gotowe w CAD, szufladka v2 w druku, otwarte tory
2026-10-26 Duże oko v3: powrót na drut Ø1, „Z” jak gięte ręcznie (noga 7, ogon 2), bez próbki zaczepu
    - drut Ø1 (użytkownik 26.10): otwory gałki Ø2,0 × 1,0 (przechył do 36,9°), uszka i przedłużenia Ø1,3,
    orczyki fabryczne Ø1,3 bez rozwiercania
    - „Z”: drut_noga 7 (otwór na środku, zagięcie 3,5 od środka otworu), drut_ogon 2, drut_r_gi 1; przy nodze 6
    ogon G–D zbliża się do płytki słupka na 0,22, przy 7 luz 0,64
    - przemiatanie i sztywne Z liczą resztę nogi i ogon po drugiej stronie otworu
    - usunięta próbka zaczepu i test 33° z instrukcji
    - sztywne Z OK (luz do gałki 0,65 / 0,64); przemiatanie: 4 z 139 poniżej wymogu – ogony „Z” drutów powiek
    przy usz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
    [Duze oko v3 - wszystkie czesci.3mf, Galka.3mf, Maskownica.3mf, Plyta.3mf, Powieka dolna.3mf, Powieka gorna.3mf, Probka zaczepu galki.3mf, Przedluzenie orczyka (druk x2).3mf]
2026-10-26 Tacka elektroniki v2: ścianka pod panelowe gniazdo USB-C (otwór łza), uchwyt rezystora 3 W, uchwyty opasek; bez pierścienia kondensatora
    Ustalenia sesji elektroniki z użytkownikiem 26.10. Wymiary gniazda – założenia do pomiaru (nie drukować).
    Siatka OK, kolizje szufladki z tacką: pusto.
    [Kaseta elektroniki.3mf, podstawka.scad]
2026-10-26 Tacka elektroniki v2: układ uzgodniony z elektroniką (PCA9685 listwami do przodu pod otwór, zacisk z tyłu przy gnieździe, ESP z przodu po lewej, rezystor z tyłu po lewej, opaski); rysunek układu
    Wymiary płytek i gniazda nadal do pomiaru (nie drukować). Siatka OK, kolizje: pusto.
    [Kaseta elektroniki.3mf, podstawka.scad]
2026-10-26 Tacka elektroniki: rezystor 47 Ω / 3 W na 2 słupkach z otworami na nóżki (korpus 8 nad dnem, nie dotyka PLA)
    Doprecyzowanie elektroniki 26.10. Siatka OK, kolizje: pusto.
    [Kaseta elektroniki.3mf, podstawka.scad]
2026-10-26 Tacka elektroniki: miejsce zapasowe 20 × 30 na 2 × M3, uchwyt opaski przewodów gniazda USB-C (lista końcowa elektroniki)
    Siatka OK, kolizje: pusto.
    [Kaseta elektroniki.3mf, podstawka.scad]
2026-10-26 Tacka elektroniki: podstawka ESP32-C3 z pinami w dół (2 podpórki 16 mm między rzędami pinów, tunel opaski, ramka z tyłu)
    Prośba elektroniki 26.10. Siatka OK, kolizje: pusto.
    [Kaseta elektroniki.3mf, podstawka.scad]
2026-10-26 Tacka elektroniki: ESP32-C3 klejony na 2 słupkach 16 mm (góra 11 × 3 pod klej, rant 1 z tyłu), bez opaski
    Poprawka elektroniki na wniosek użytkownika. Siatka OK, kolizje: pusto.
    [Kaseta elektroniki.3mf, podstawka.scad]
2026-10-26 Tacka elektroniki: wymiary ESP32-C3 z pomiaru (24 × 18,4), PCA9685 potwierdzona; czeka tylko gniazdo USB-C
    [Kaseta elektroniki.3mf, podstawka.scad]
2026-10-26 Tacka elektroniki: otwór „podwójne D” 11,3 / 10,3 pod zmierzone gniazdo USB-C (kołnierz 14, korpus 13) – tacka gotowa do druku
    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
    [Kaseta elektroniki.3mf, podstawka.scad]
2026-10-26 Tacka elektroniki: wolne Ø18 za ścianką gniazda USB-C na nakrętkę 15,5 (pomiar 27.10), oś 12,4 nad dnem
    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
    [Kaseta elektroniki.3mf, podstawka.scad]
2026-10-26 Tacka elektroniki: 4 zapasowe otwory Ø5,5 w dnie (M5 albo wkręt w sklejkę) w wolnych polach
    Prośba użytkownika 27.10 przez elektronikę. Siatka OK, kolizje: pusto.
    [Kaseta elektroniki.3mf, podstawka.scad]
2026-10-26 dynia-v2 etap 1: 8 małych oczu, PIR, przycisk blokady, duże oko (wyłączone do kalibracji), podtrzymanie powerbanku; pinout docelowy w polaczenia.md; raport elektroniki
2026-10-26 Podstawka: otwór Ø12 przycisku w prawym boku (36 od tyłu, oś 32 nad stołem, wiercić od zewnątrz, przycisk wklejony); kontrola KolizjaPrzycisk
    Decyzja użytkownika 27.10. Kolizje: pusto.
    [podstawka.scad]
2026-10-27 M2: kalibracja kanału 0 (nowy moduł) – 1500 prosto, Min 1100 = prawo, Max 1800; uwagi o module 8 i ostatnim
2026-10-27 Kalibracja: drugi nowy moduł sprawdzony na stole – wspólne wartości 1500/1100/1800 pasują
2026-10-27 Kalibracja: trzeci nowy moduł sprawdzony – wspólne wartości pasują
2026-10-27 polaczenia: przewód PIR w szufladce – zapas 150 mm w pasie wtyku (z montażem)
2026-10-28 Duże oko v3: trzpień kardana M3, osie powiek M2 × 6, przedłużenie z rowkiem, instrukcja montażu
    - trzpień kardana z rdzeniem M3 × 10 ISO 7380 (warianty T4.9/T5.0/K9.2 w jednym 3MF)
    - oś powiek: wkręt M2 × 6 wkręcony w powiekę dolną (pełny pierścień gwintu x 31…33),
    szczeliny 5,0 z fazką w tubach na łby, kołnierz cały (review Astry 28.10)
    - przedłużenie orczyka: rowek na ramię (pomiar 6 → 4) i otwory na kołki Ø1
    - ogon drutu w uszku powieki zagięty ku serwu (przemiatanie: gałka 0,95 / 3,03)
    - ilustrowana instrukcja montażu (HTML, rendery kroków, przekroje), review Astry
    [Duze oko v3 - wszystkie czesci.3mf, Powieka dolna.3mf, Powieka gorna.3mf, Przedluzenie orczyka (druk x2).3mf, Trzpien kardana M3 (2 + 2 zapas + warianty).3mf, Tuba 30.3mf, Tuba 40.3mf, Tuba 50.3mf]
2026-10-28 Stan w repo: sesje.md (role i gałęzie), lista hardware, decyzje 27–28.10 (trzpień M3, oś M2×6, przedłużenie, ogon ku serwu), pomiar kardana
2026-10-28 Duże oko: pierwszy ruch gałki na sprzęcie (G–D ±239, L–P ±284 µs), sprzężenie osi, kanały stołu do przełożenia
2026-10-28 dynia-v2: gałka dużego oka włączona (12 L–P, 13 G–D) ze sprzężeniem osi; powieki osobno wyłączone; komendy g i z; raport
2026-10-28 Duże oko v3: większe uszka powiek (wariant A), kable MG90S po stronie wałka i wnęki w płycie, przemiatanie, instrukcja i rendery
    [Duze oko v3 - wszystkie czesci.3mf, Powieka dolna.3mf, Powieka gorna.3mf, duze-oko-v3.scad]
2026-10-28 polaczenia: cofnięte przeniesienie rezystora na kanał 11 (bez zgody użytkownika) – rezystor na słupkach tacki do zacisku, jak w projekcie tacki v2
2026-10-28 Tacka: podkładki 7 mm pod ESP32-C3 na wydrukowane słupki (decyzja użytkownika 28.10)
    [Tacka - podkladki ESP (2 szt).3mf, podstawka.scad]
2026-10-28 Decyzje 28.10: podkładki 7 mm pod ESP na wydrukowaną tackę, bez przedruku
2026-10-28 Tuleja mocowania dyni: wysokość 78 z zapasem zamiast pomiaru dna dyni (użytkownik 28.10)
    [Tuleja z gwintem.3mf, podstawka.scad]
2026-10-28 Instrukcja montażu elektroniki z obrazkami z modelu: elementy.scad (tacka 8a07059 + elektronika), eksport i kontrola kolizji, render Blender, 20 obrazków kroków
    [elementy.scad]
2026-10-28 PRD 0.3: przepisane od nowa – stan obecny pełnymi zdaniami, otwarte sprawy w §10, historia w decyzje.md
2026-10-28 Obrazki skrętek pod wtyczki serw: model, rendery 07/07b/07c, schematy lutowania 07d i 07e, etykiety przycisku
    [elementy.scad]
2026-10-28 Przycisk na wtyczce 3-pin wprost w ESP (piny 5–6–7, GPIO5 jako masa, GPIO7 odczyt); GPIO4 zapas
2026-10-28 Obrazki i model: przycisk na wtyczce 3-pin na ESP 5–6–7, zapas GPIO3 i GPIO4; tekst kroków 2 i 6
    [elementy.scad]
2026-10-28 Piny ESP: rzędy zamienione na zgodne z pinoutem SuperMini (układ do góry, USB do przodu: lewy 5V/G/3V3…, prawy 5…21); model, trasy, rendery, nowy schemat 02a
    [elementy.scad]
2026-10-28 Duże oko v3: podparcie modułu w tubie – 8 łap, ścianka w tylnym końcu tuby, wspornik L z zaczepem
    Tuba 30/40/50: 8 łap co 45° (łapę w miejscu kolizji pomijasz), ścianka 2,5
    zamykająca dół tylnego końca do 26 pod osią, wycięcie na drut powieki dolnej.
    Wspornik płyty 30/40/50 (x2): L ze wzmocnieniem 45°, zaczep na krawędzi
    ścianki, noga klejona do ścianki i kołnierza, płyta na półce (użytkownik 28.10).
    Przemiatanie tub OK (drut dolny 3,3 do ścianki); wspornik do serwa L–P 0,75.
    [Duze oko v3 - wszystkie czesci.3mf, Tuba 30.3mf, Tuba 40.3mf, Tuba 50.3mf, Wspornik plyty 30 (druk x2).3mf, Wspornik plyty 40 (druk x2).3mf, Wspornik plyty 50 (druk x2).3mf, duze-oko-v3.scad]
2026-10-28 Tuleja mocowania dyni pod otwór 60, ciasno (decyzja użytkownika 28.10): gwint Ø60, przelot Ø51, nakrętka 90
    [Nakretka.3mf, Probka gwintu - nakretka.3mf, Probka gwintu - tuleja.3mf, Tuleja z gwintem.3mf, podstawka.scad]
2026-10-28 Tuleja: gwint Ø59 (luz 0,5 na stronę w otworze 60 dyni), ścianka 3, przelot Ø49; nakrętka luz 0,20 (użytkownik 28.10)
    [Nakretka.3mf, Probka gwintu - nakretka.3mf, Probka gwintu - tuleja.3mf, Tuleja z gwintem.3mf, podstawka.scad]
2026-10-28 PRD i decyzje: tuleja mocowania dyni – gwint Ø59 w otworze 60, nakrętka z luzem 0,20
2026-10-28 Obciążenie powerbanku przez IRLZ44N na GPIO4: impuls 1 s co 10 s, komenda o; pinout
2026-10-28 dynia-v2: 7 małych oczu (4 + 3, kanały 0–6, N_MALE), kanał 7 bez impulsu
